JaehyeongIm/automotive-secure-ota-ecu/docs/assets/photos/천장사진.JPG

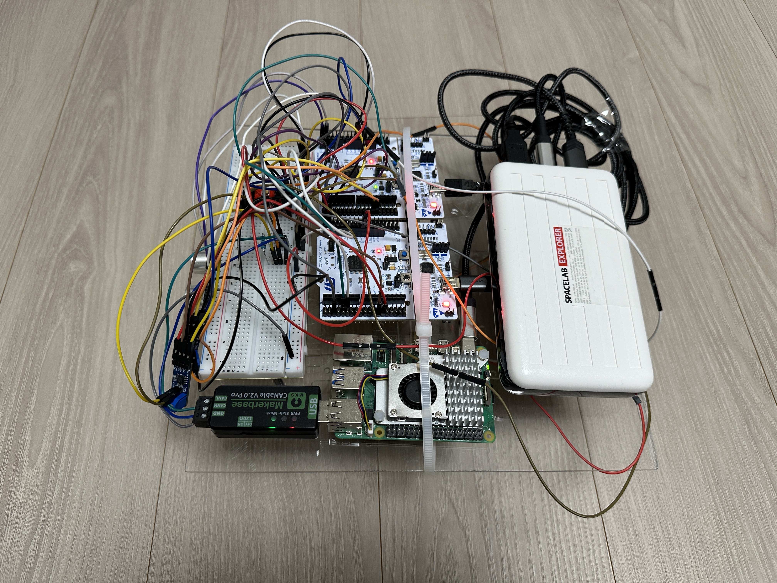
docs/assets/photos/천장사진.JPG
