JaehyeongIm/automotive-secure-ota-ecu/SRS-001_CAN_Secure_OTA_Pipeline_v4.md

# SRS-001: CAN 기반 UDS over ISO-TP Secure OTA 파이프라인 요구사항 명세서

| 항목 | 내용 |
|---|---|
| 문서 ID | SRS-001 |
| 문서명 | CAN 기반 UDS over ISO-TP Secure OTA 파이프라인 요구사항 명세서 |
| 프로젝트명 | Dual ECU 라인트레이싱 차량 Secure OTA 시스템 |
| 버전 | 1.4 |
| 작성일 | 2026-05-16 |
| 작성 목적 | Dual ECU 라인트레이싱 차량 Secure OTA 시스템 소프트웨어 요구사항 정의 |
| 주요 대상 | Raspberry Pi 5 Gateway, STM32F446RE ECU 2대, CAN Bus, Custom Bootloader, 라인트레이싱 차량 |
| 범위 변경 | 1.3 대비 ISO-TP 전송 계층 추가, SAD-001/SDD-001 필수 문서 추가(필수 문서 7종 확장), 산출물 요구사항 간소화, Drive ECU v1/v2 조작변인 구체화(ON/OFF → 비례 제어), Sensor ECU v1/v2 임계값 구체화(15cm → 25cm), HC-SR04 확정 |

---

## 1. 개요

### 1.1 프로젝트 목적

본 프로젝트의 목적은 Raspberry Pi 5를 차량 OTA Gateway 역할로, STM32F446RE 2대를 차량 ECU 역할로 구성하여 CAN 기반 Secure OTA 펌웨어 업데이트 파이프라인을 구현하는 것이다.

단순히 펌웨어 파일을 전송하는 데 그치지 않고, 다음 요소를 포함한 전장형 OTA 구조를 구현한다.

- STM32F446RE Custom Bootloader
- CAN 기반 UDS over ISO-TP 리프로그래밍 명령 구조
- 논리적 A/B App Slot 기반 안전 업데이트 및 Rollback
- Manifest 기반 펌웨어 무결성/인증성 검증
- SHA-256 Hash 검증
- 전자서명 기반 펌웨어 검증
- Anti-rollback 정책
- ECU ID / HW ID 기반 대상 검증
- 공격자 관점의 보안 시나리오 검증
- 라인트레이싱 차량을 통한 OTA 적용 결과 실증

본 시스템은 양산 차량 ECU 환경을 완전히 재현하지 않으며, 가용 개발 플랫폼(STM32F446RE, Raspberry Pi 5) 범위 내에서 전장 OTA의 핵심 기능을 구현하고 검증하는 것을 목표로 한다. 구현 범위의 한계는 Section 19에 명시한다.

본 프로젝트는 요구사항 기반 개발과 양방향 추적성 원칙을 적용하여 SRS, 설계, 구현, 테스트, 트러블슈팅 산출물 간의 일관성을 유지한다.

### 1.2 시스템 목표

본 시스템이 달성해야 하는 핵심 목표는 다음과 같다.

| 목표 영역 | 구현 내용 |
|---|---|
| Custom Bootloader | MCU 메모리맵 기반 Flash 파티션 관리, App jump, Vector Table 재배치 |
| CAN 통신 | 차량 네트워크 기반 ECU 간 업데이트 명령 및 상태 메시지 송수신 |
| UDS-style 명령 구조 | 진단 기반 리프로그래밍 절차(Session Control, Security Access, Download, Transfer) 구현 |
| A/B Slot 및 Rollback | 비활성 Slot 대상 업데이트, Self-test 기반 Confirmed 처리, 실패 시 자동 복구 |
| Secure OTA | SHA-256 무결성 검증, ECDSA 서명 검증, Anti-rollback, ECU ID 검증 |
| 위협 시나리오 검증 | 변조, 위조, 다운그레이드, Replay, 미인증 명령, CAN Flood 공격 방어 검증 |
| 시스템 실증 | 라인트레이싱 차량 플랫폼을 통한 OTA 적용 결과 기능 검증 |
| 요구사항 추적성 | SRS 요구사항에서 설계, 구현, 테스트, 트러블슈팅까지 양방향 추적 관리 |
| 계측 기반 검증 | 오실로스코프, 로직분석기, ST-LINK를 활용한 신호 수준 검증 및 원인 분석 |

---

## 2. 프로젝트 범위

### 2.1 In Scope

본 프로젝트에서 구현 대상에 포함되는 범위는 다음과 같다.

1. Raspberry Pi 5 기반 OTA Gateway 구현
2. STM32F446RE 기반 Drive ECU 구현
3. STM32F446RE 기반 Sensor/Body ECU 구현
4. 각 ECU의 Custom Secure Bootloader 구현
5. ISO-TP (SF/FF/CF/FC) 기반 UDS 전송 계층 구현
6. CAN 기반 UDS 업데이트 명령 구조 구현 (0x10, 0x27, 0x34, 0x36, 0x37, 0x31, 0x11)
7. 논리적 A/B App Slot 기반 업데이트 및 Rollback 구현
8. Manifest 기반 업데이트 패키지 검증
9. SHA-256 기반 이미지 무결성 검증
10. 전자서명 기반 펌웨어 인증성 검증
11. Anti-rollback 정책 구현
12. ECU ID / HW ID 기반 대상 검증
13. 라인트레이싱 App v1/v2 업데이트 실증
14. 공격자 시나리오 기반 보안 테스트
15. 정상/비정상 업데이트 로그 수집 및 테스트 리포트 작성
16. ASPICE-inspired 요구사항 기반 개발 프로세스 적용
17. 요구사항-설계-구현-테스트 간 추적성 매트릭스 작성
18. 계측기 기반 트러블슈팅 사례 수집 및 리포트 작성
19. ST-LINK 디버거 기반 Bootloader/App 실행 흐름 검증

### 2.2 Out of Scope

다음 항목은 본 프로젝트의 1차 구현 범위에서 제외한다.

| 제외 항목 | 제외 사유 |
|---|---|
| Delta Update / 차분 업데이트 | 1차 구현에서는 안정성 검증을 우선하며, Full Image 기반 A/B OTA에 집중하기 위함 |
| 상용 Uptane 전체 구현 | 개인 프로젝트 범위에서 과도하므로 Uptane-lite 개념 참고 수준으로 제한 |
| AUTOSAR Classic/Adaptive 정식 스택 | 상용 스택 없이 개념 연결 수준으로 제한 |
| ISO-TP 멀티 세션 동시 처리 | 단일 ECU당 단일 OTA 세션만 운용하므로 동시 세션 관리는 제외 |
| HSM 기반 키 저장 | F446RE의 하드웨어 한계로 양산 ECU 수준 구현 불가 |
| 실제 차량 ECU 연결 공격 | 안전/법적 문제로 자체 제작 테스트 네트워크 내부에서만 검증 |
| 실제 차량 주행 제어 | 축소형 라인트레이싱 차량 플랫폼에서만 실증 |
| ASPICE 완전 준수/공식 평가 | 개인 프로젝트 범위이므로 공식 ASPICE 심사나 조직 프로세스 수준의 준수는 제외 |
| 상용 요구사항 관리 도구 필수 사용 | Polarion, DOORS 등 상용 도구 대신 Markdown/Spreadsheet 기반 추적성 관리로 대체 |

---

## 3. 시스템 개요

### 3.1 전체 시스템 구성

```text
[Update Package / 개발 PC]
        |
        | 파일 복사 또는 내부 네트워크
        v
[Raspberry Pi 5: OTA Gateway]
- Update Package 관리
- Manifest 파싱 및 1차 검증
- CAN 전송 제어
- ECU Inventory 수집
- Update Campaign 상태 관리
- 공격자 시나리오 실행
        |
        | CAN Bus
        v
+----------------------------+      +------------------------------+
| STM32F446RE ECU #1         |      | STM32F446RE ECU #2           |
| Drive ECU                  |      | Sensor/Body ECU              |
| - Custom Bootloader        |      | - Custom Bootloader          |
| - A/B App Slot             |      | - A/B App Slot               |
| - Line Tracing Control     |      | - Distance/Obstacle Sensing  |
| - Motor Control            |      | - Status Message Tx          |
+----------------------------+      +------------------------------+
```

### 3.2 주요 하드웨어 역할

| 구성 요소 | 역할 |
|---|---|
| Raspberry Pi 5 | OTA Gateway, Update Manager, CAN 송수신, 로그 수집, 공격자 시나리오 실행 |
| STM32F446RE #1 | Drive ECU: 라인트레이싱, 모터 제어, OTA 대상 ECU |
| STM32F446RE #2 | Sensor/Body ECU: 거리센서, 장애물 감지, 상태 메시지 송신, OTA 대상 ECU |
| CAN Transceiver | STM32와 CAN Bus 간 물리 계층 연결 |
| CANable 또는 유사 장치 | PC/Raspberry Pi에서 CAN 로그 확인 및 테스트 프레임 송신 |
| 2WD 차체 | OTA 적용 결과를 실증할 차량 플랫폼 |
| TB6612FNG | DC 모터 구동 드라이버 |
| 라인트레이서 센서 | Drive ECU의 라인 감지 입력 |
| 거리센서 | Sensor/Body ECU의 장애물 감지 입력 |

---

## 4. 사용자 및 이해관계자

| 이해관계자 | 관심사 |
|---|---|
| 임베디드 소프트웨어 개발자 | Bootloader, CAN 드라이버, OTA 절차, 보안 검증 구현 |
| 시스템 통합 담당자 | ECU 간 인터페이스, CAN 메시지 명세, 업데이트 절차 일관성 |
| 품질 보증(QA) 담당자 | 요구사항 추적성, 테스트 커버리지, 실패 복구 검증 결과 |
| 차량 운전자 | 업데이트 실패 시 기존 주행 기능 유지, 업데이트 중 안전 정지 |

---

## 5. 운영 시나리오

### 5.1 정상 업데이트 시나리오

1. Raspberry Pi 5가 ECU Inventory를 요청한다.
2. 각 ECU는 현재 펌웨어 버전, 활성 슬롯, Boot 상태, ECU ID를 응답한다.
3. Raspberry Pi 5가 업데이트 Manifest를 확인한다.
4. Raspberry Pi 5가 대상 ECU에 UDS-style Diagnostic Session 진입을 요청한다.
5. ECU는 업데이트 가능한 조건인지 확인한다.
6. Raspberry Pi 5가 Security Access 절차를 수행한다.
7. Raspberry Pi 5가 Request Download를 전송한다.
8. ECU는 비활성 Slot을 선택하고 다운로드 준비 상태로 진입한다.
9. Raspberry Pi 5가 Transfer Data로 펌웨어 조각을 전송한다.
10. ECU는 조각 순서, 길이, 범위를 확인하고 비활성 Slot에 기록한다.
11. Request Transfer Exit 이후 ECU는 이미지 Hash, Signature, Version, ECU ID를 검증한다.
12. 검증 성공 시 ECU는 Boot Metadata를 갱신하여 다음 부팅 대상 Slot을 변경한다.
13. ECU Reset 이후 새 App으로 부팅한다.
14. App은 Self-test를 수행하고 정상일 경우 Confirmed 상태를 Bootloader에 알린다.
15. Confirmed 처리 완료 후 새 Slot이 정상 슬롯이 된다.

### 5.2 실패 복구 시나리오

1. 업데이트 중 전원 차단 또는 통신 중단이 발생한다.
2. 재부팅 시 Bootloader가 Metadata를 확인한다.
3. 새 Slot이 검증 완료/Confirmed 상태가 아니면 기존 Confirmed Slot으로 부팅한다.
4. 기존 App이 정상 동작해야 한다.
5. Raspberry Pi 5는 실패 원인을 로그로 기록한다.

### 5.3 공격자 검증 시나리오

1. 공격자 노드가 위조된 Update Start 명령을 전송한다.
2. ECU는 인증되지 않은 세션을 거부한다.
3. 공격자 노드가 변조된 Firmware Chunk를 전송한다.
4. ECU는 최종 Hash 또는 Signature 검증에서 실패 처리한다.
5. 공격자 노드가 이전 버전 펌웨어를 전송한다.
6. ECU는 Anti-rollback 정책에 의해 거부한다.
7. 공격자 노드가 Replay 프레임을 전송한다.
8. ECU는 Session ID, Sequence Number, Freshness Counter를 통해 거부한다.

---

## 6. 시스템 제약사항

### 6.1 MCU 제약

- STM32F446RE는 양산 차량용 HSM MCU가 아니다.
- F446RE의 Flash는 하드웨어 Dual Bank 구조가 아니므로, 단일 Flash 내부를 논리적으로 분할하여 A/B Slot을 구성한다.
- F446RE의 Flash 용량은 제한적이므로 App 크기, Bootloader 크기, 암호 라이브러리 크기를 관리해야 한다.
- 실제 양산 ECU 수준의 Secure Boot ROM, HSM Key Storage, Debug Lock 정책은 본 프로젝트에서 완전 재현하지 않는다.

### 6.2 CAN / ISO-TP 제약

- CAN Classic (최대 8바이트 payload) 기반으로 구현한다.
- CAN FD 수준의 대용량 Payload를 전제하지 않는다.
- 대용량 데이터(펌웨어 이미지) 전송은 ISO-TP FF/CF 분할 전송으로 처리한다.
- ISO-TP는 SF/FF/CF/FC 핵심 프레임 타입을 구현하며, 멀티 세션 동시 처리는 제외한다.
- Gateway(Raspberry Pi 5)는 Linux SocketCAN의 ISO-TP 커널 지원을 활용한다.
- ECU(STM32F446RE)는 ISO-TP 수신 상태 머신을 소프트웨어로 구현한다.
- CAN 버스 속도는 500Kbps로 운용한다.
- CAN Bus 부하, 전송 시간, STmin 타이밍, Timeout 정책을 고려한다.

### 6.3 프로젝트 범위 제약

- 본 프로젝트는 개인 사이드 프로젝트이며, 상용 OTA 시스템을 완전 대체하지 않는다.
- Uptane, AUTOSAR, UDS는 전체 표준 구현이 아니라 개념을 참고한 축소 구현으로 제한한다.
- ISO-TP는 OTA에 필요한 SF/FF/CF/FC 핵심 기능을 구현하며, ISO 15765-2 전체 규격 준수를 목표로 하지 않는다.
- 보안 공격 시나리오는 자체 제작한 테스트 환경 내부에서만 수행한다.

---

## 7. 기능 요구사항

### 7.1 OTA Gateway 요구사항

| ID | 요구사항 | 우선순위 | 수용 기준 |
|---|---|---:|---|
| FR-GW-001 | Raspberry Pi 5는 OTA Gateway 역할을 수행해야 한다. | Must | Gateway 프로세스가 ECU 목록, 버전, 상태를 수집할 수 있어야 한다. |
| FR-GW-002 | Gateway는 Update Package와 Manifest를 읽고 파싱해야 한다. | Must | Manifest 필드를 정상적으로 파싱하고 누락 필드를 오류 처리한다. |
| FR-GW-003 | Gateway는 Manifest에 포함된 ECU ID, Version, Image Size, Hash, Signature 정보를 관리해야 한다. | Must | Manifest 내용이 로그에 기록되어야 한다. |
| FR-GW-004 | Gateway는 대상 ECU별 업데이트 순서를 제어해야 한다. | Must | Drive ECU, Sensor ECU를 개별적으로 업데이트할 수 있어야 한다. |
| FR-GW-005 | Gateway는 CAN을 통해 UDS-style 명령을 송수신해야 한다. | Must | Session Control, Request Download, Transfer Data 등 핵심 명령이 동작해야 한다. |
| FR-GW-006 | Gateway는 업데이트 성공/실패 결과를 로그로 저장해야 한다. | Must | 각 ECU별 업데이트 결과, 실패 원인, 시간 정보가 기록되어야 한다. |
| FR-GW-007 | Gateway는 공격자 시나리오 실행 모드를 제공해야 한다. | Should | Replay, 변조, 비인가 명령, Flood 테스트를 선택 실행할 수 있어야 한다. |
| FR-GW-008 | Gateway는 Update Campaign ID를 관리해야 한다. | Should | 동일 Campaign에 속한 ECU 업데이트 결과를 묶어서 기록해야 한다. |

### 7.2 ECU Bootloader 요구사항

| ID | 요구사항 | 우선순위 | 수용 기준 |
|---|---|---:|---|
| FR-BL-001 | 각 STM32F446RE ECU는 Custom Bootloader를 포함해야 한다. | Must | Reset 후 Bootloader가 먼저 실행되어야 한다. |
| FR-BL-002 | Bootloader는 현재 활성 Slot과 후보 Slot을 구분해야 한다. | Must | Metadata에서 active, pending, confirmed 상태를 읽을 수 있어야 한다. |
| FR-BL-003 | Bootloader는 유효한 App이 있을 경우 해당 App으로 jump해야 한다. | Must | Vector Table 설정 후 App Reset Handler로 정상 진입해야 한다. |
| FR-BL-004 | Bootloader는 CAN 기반 업데이트 세션에 진입할 수 있어야 한다. | Must | 특정 조건 또는 명령 수신 시 update mode에 진입해야 한다. |
| FR-BL-005 | Bootloader는 수신한 펌웨어 조각을 비활성 Slot에 기록해야 한다. | Must | Flash erase/write가 섹터 경계와 주소 범위 내에서 수행되어야 한다. |
| FR-BL-006 | Bootloader는 펌웨어 전체 Hash를 검증해야 한다. | Must | Manifest의 Hash와 실제 Slot 이미지 Hash가 일치해야 한다. |
| FR-BL-007 | Bootloader는 펌웨어 Signature를 검증해야 한다. | Must | 공개키 기반 검증 실패 시 업데이트를 거부해야 한다. |
| FR-BL-008 | Bootloader는 Firmware Version을 확인하고 다운그레이드를 차단해야 한다. | Must | 현재 Confirmed Version보다 낮은 버전은 거부해야 한다. |
| FR-BL-009 | Bootloader는 Target ECU ID/HW ID를 확인해야 한다. | Must | 다른 ECU용 이미지 설치를 거부해야 한다. |
| FR-BL-010 | Bootloader는 업데이트 후 첫 부팅에서 Self-test 결과를 확인해야 한다. | Must | Self-test 실패 시 이전 Confirmed Slot으로 rollback해야 한다. |
| FR-BL-011 | Bootloader는 Boot Metadata 손상 시 안전한 기본 정책을 적용해야 한다. | Should | Metadata 오류 시 기존 Confirmed Slot 또는 Safe Mode로 진입해야 한다. |
| FR-BL-012 | Bootloader는 Watchdog 또는 Timeout 기반 업데이트 중단 처리를 지원해야 한다. | Should | 일정 시간 Transfer Data가 없으면 업데이트를 중단하고 기존 App을 유지해야 한다. |

### 7.3 A/B Slot 및 Rollback 요구사항

| ID | 요구사항 | 우선순위 | 수용 기준 |
|---|---|---:|---|
| FR-AB-001 | 시스템은 논리적 A/B App Slot을 사용해야 한다. | Must | Slot A와 Slot B 중 하나만 active 상태여야 한다. |
| FR-AB-002 | 업데이트 이미지는 현재 실행 중인 Slot이 아닌 비활성 Slot에 기록해야 한다. | Must | 현재 Confirmed Slot은 업데이트 과정에서 지워지지 않아야 한다. |
| FR-AB-003 | 새 Slot 검증이 완료되기 전까지 Boot Target을 변경하지 않아야 한다. | Must | Hash/Signature/Version 검증 실패 시 기존 Slot 유지가 확인되어야 한다. |
| FR-AB-004 | 새 App은 부팅 후 Self-test를 통과해야 Confirmed 처리되어야 한다. | Must | Self-test 실패 App은 다음 부팅에서 rollback되어야 한다. |
| FR-AB-005 | 업데이트 중 전원 차단이 발생해도 기존 Confirmed App은 유지되어야 한다. | Must | 전원 차단 테스트 후 기존 App으로 정상 부팅해야 한다. |
| FR-AB-006 | Boot Metadata는 active, pending, confirmed, version, attempt count를 관리해야 한다. | Should | Metadata dump 또는 로그에서 상태 확인이 가능해야 한다. |
| FR-AB-007 | Boot attempt count를 초과하면 이전 Slot으로 복구해야 한다. | Should | 지정 횟수 내 Confirmed 되지 않은 App은 실패 처리되어야 한다. |

### 7.4 CAN / ISO-TP / UDS 프로토콜 요구사항

| ID | 요구사항 | 우선순위 | 수용 기준 |
|---|---|---:|---|
| FR-CAN-001 | 시스템은 CAN 기반 ECU 업데이트 통신을 수행해야 한다. | Must | Gateway와 각 ECU 간 CAN 송수신이 가능해야 한다. |
| FR-CAN-002 | 모든 UDS 메시지는 ISO-TP 전송 계층을 통해 송수신되어야 한다. | Must | ISO-TP 없이 직접 CAN 프레임으로 UDS 명령을 송수신하지 않아야 한다. |
| FR-CAN-003 | ECU는 ISO-TP SF(Single Frame)를 수신하여 UDS 명령을 처리해야 한다. | Must | 7바이트 이하 UDS 명령이 SF로 수신되어 정상 처리되어야 한다. |
| FR-CAN-004 | ECU는 ISO-TP FF/CF(First Frame / Consecutive Frame)를 수신하여 UDS 페이로드를 조립해야 한다. | Must | 다중 프레임으로 분할된 Transfer Data 페이로드가 누락 없이 조립되어야 한다. |
| FR-CAN-005 | ECU는 FF 수신 후 ISO-TP FC(Flow Control) 프레임을 송신해야 한다. | Must | FC 프레임의 FlowStatus, BlockSize, STmin 필드가 정확히 설정되어야 한다. |
| FR-CAN-006 | ECU는 ISO-TP STmin 타이밍을 준수해야 한다. | Must | CF 프레임 간 수신 간격이 STmin 이하일 경우 오류 처리해야 한다. |
| FR-CAN-007 | Gateway는 SocketCAN ISO-TP 인터페이스를 통해 UDS 메시지를 송수신해야 한다. | Must | Python socket(AF_CAN, SOCK_DGRAM, CAN_ISOTP) 기반으로 전송되어야 한다. |
| FR-CAN-008 | 명령 구조는 UDS 리프로그래밍 절차를 준수해야 한다. | Must | 0x10, 0x27, 0x34, 0x36, 0x37, 0x31, 0x11에 대응하는 명령이 정의되어야 한다. |
| FR-CAN-009 | Diagnostic Session Control 명령을 지원해야 한다. | Must | Default Session과 Programming Session 상태를 구분해야 한다. |
| FR-CAN-010 | Security Access 명령을 지원해야 한다. | Must | 인증되지 않은 상태에서는 다운로드 명령을 거부해야 한다. |
| FR-CAN-011 | Request Download 명령을 지원해야 한다. | Must | Image size, target slot, target ECU ID를 확인해야 한다. |
| FR-CAN-012 | Transfer Data 명령을 지원해야 한다. | Must | Sequence Number와 Chunk 길이를 확인해야 한다. |
| FR-CAN-013 | Request Transfer Exit 명령을 지원해야 한다. | Must | 모든 Chunk 수신 후 검증 단계로 진입해야 한다. |
| FR-CAN-014 | Routine Control - Verify Image 명령을 지원해야 한다. | Must | Hash/Signature/Version/ECU ID 검증 결과를 반환해야 한다. |
| FR-CAN-015 | ECU Reset 명령을 지원해야 한다. | Must | 검증 성공 후 Reset을 통해 새 Slot 부팅을 시도해야 한다. |
| FR-CAN-016 | Negative Response Code를 정의해야 한다. | Should | 잘못된 세션, 보안 실패, 길이 오류, 순서 오류, 인증 실패 등을 구분해야 한다. |
| FR-CAN-017 | Replay 방어를 위한 Session ID 또는 Freshness Counter를 사용해야 한다. | Should | 이전 세션의 Transfer Data 재전송이 거부되어야 한다. |

### 7.5 Drive ECU Application 요구사항

| ID | 요구사항 | 우선순위 | 수용 기준 |
|---|---|---:|---|
| FR-DRV-001 | Drive ECU는 라인트레이싱 센서 입력을 읽어야 한다. | Must | 4채널 IR 센서 입력값을 주기적으로 읽고 로그/상태로 확인할 수 있어야 한다. |
| FR-DRV-002 | Drive ECU는 TB6612FNG를 통해 좌우 모터를 제어해야 한다. | Must | PWM 기반 좌우 모터 속도 제어가 가능해야 한다. |
| FR-DRV-003 | Drive ECU App v1은 ON/OFF 방식(bang-bang) 라인트레이싱 제어를 구현해야 한다. | Must | 4채널 IR 센서 입력을 ON/OFF로 해석하여 좌우 모터를 전속 또는 정지 상태로 전환하며, 직선에서는 주행하되 곡선 구간에서 진동/사행 주행이 관찰되어야 한다. |
| FR-DRV-004 | Drive ECU App v2는 가중치 기반 비례 제어 라인트레이싱을 구현해야 한다. | Should | 4채널 IR 센서에 가중치(외측 ±3, 내측 ±1)를 적용하여 편차를 계산하고, 좌우 모터 PWM을 차등 조정하여 v1 대비 곡선 구간 추종이 부드럽게 개선되어야 한다. |
| FR-DRV-005 | Drive ECU는 Sensor ECU의 장애물 상태 메시지를 반영해야 한다. | Should | 장애물 감지 시 정지 또는 감속해야 한다. |
| FR-DRV-006 | Drive ECU는 현재 App Version과 Slot 정보를 CAN으로 보고해야 한다. | Must | Gateway의 Inventory 요청에 응답해야 한다. |

### 7.6 Sensor/Body ECU Application 요구사항

| ID | 요구사항 | 우선순위 | 수용 기준 |
|---|---|---:|---|
| FR-SEN-001 | Sensor ECU는 HC-SR04 초음파 거리센서 입력을 읽어야 한다. | Must | Trigger/Echo GPIO 방식으로 거리값을 주기적으로 측정할 수 있어야 한다. |
| FR-SEN-002 | Sensor ECU App v1은 장애물 감지 임계값 15cm를 사용해야 한다. | Must | 측정 거리가 15cm 이하일 때 obstacle_detected 상태를 CAN으로 송신해야 한다. |
| FR-SEN-003 | Sensor ECU는 Alive/Heartbeat 메시지를 송신해야 한다. | Should | Drive ECU 또는 Gateway가 Sensor ECU 생존 상태를 확인할 수 있어야 한다. |
| FR-SEN-004 | Sensor ECU App v2는 장애물 감지 임계값을 25cm로 변경해야 한다. | Should | OTA 업데이트 후 측정 거리가 25cm 이하일 때 obstacle_detected 상태를 송신하여 v1(15cm) 대비 조기 감지가 확인되어야 한다. |
| FR-SEN-005 | Sensor ECU는 현재 App Version과 Slot 정보를 CAN으로 보고해야 한다. | Must | Gateway의 Inventory 요청에 응답해야 한다. |

---

## 8. 보안 요구사항

### 8.1 Manifest 요구사항

| ID | 요구사항 | 우선순위 | 수용 기준 |
|---|---|---:|---|
| SR-MF-001 | 업데이트 패키지는 Manifest를 포함해야 한다. | Must | Manifest 없이는 업데이트가 시작되지 않아야 한다. |
| SR-MF-002 | Manifest는 target_ecu_id를 포함해야 한다. | Must | ECU ID 불일치 시 업데이트가 거부되어야 한다. |
| SR-MF-003 | Manifest는 firmware_version을 포함해야 한다. | Must | Version 기반 anti-rollback 검증이 가능해야 한다. |
| SR-MF-004 | Manifest는 image_size를 포함해야 한다. | Must | 수신 데이터가 image_size를 초과하면 중단해야 한다. |
| SR-MF-005 | Manifest는 image_hash를 포함해야 한다. | Must | 최종 Slot 이미지 Hash와 비교해야 한다. |
| SR-MF-006 | Manifest는 signature를 포함해야 한다. | Must | 공개키 기반 서명 검증을 수행해야 한다. |
| SR-MF-007 | Manifest는 campaign_id를 포함해야 한다. | Should | 복수 ECU 업데이트 결과를 하나의 캠페인으로 추적해야 한다. |
| SR-MF-008 | Manifest는 expiration 또는 metadata_version을 포함해야 한다. | Should | 오래된 Manifest 재사용을 방지해야 한다. |

### 8.2 Firmware 검증 요구사항

| ID | 요구사항 | 우선순위 | 수용 기준 |
|---|---|---:|---|
| SR-FW-001 | ECU는 수신한 펌웨어 전체에 대해 Hash를 계산해야 한다. | Must | 계산 Hash와 Manifest Hash가 다르면 업데이트 실패 처리해야 한다. |
| SR-FW-002 | ECU는 펌웨어 또는 Manifest Signature를 검증해야 한다. | Must | 검증 실패 시 Boot Target을 변경하지 않아야 한다. |
| SR-FW-003 | ECU는 현재 Confirmed Version보다 낮은 Version을 거부해야 한다. | Must | Downgrade 테스트가 실패 처리되어야 한다. |
| SR-FW-004 | ECU는 대상 ECU ID가 일치하지 않는 이미지를 거부해야 한다. | Must | Drive ECU용 이미지를 Sensor ECU에 설치할 수 없어야 한다. |
| SR-FW-005 | ECU는 이미지 크기가 Slot 크기를 초과하면 업데이트를 거부해야 한다. | Must | Slot boundary 침범이 발생하지 않아야 한다. |
| SR-FW-006 | ECU는 Flash write 주소 범위를 검증해야 한다. | Must | Bootloader, Metadata 영역에 App 데이터가 기록되지 않아야 한다. |

### 8.3 공격 방어 요구사항

| ID | 공격 시나리오 | 방어 요구사항 | 수용 기준 |
|---|---|---|---|
| SR-ATK-001 | Firmware Tampering | Hash/Signature 검증 | 1바이트 변조 이미지가 거부되어야 한다. |
| SR-ATK-002 | Arbitrary Software | Signature 검증 | 개인이 임의 생성한 unsigned image가 거부되어야 한다. |
| SR-ATK-003 | Downgrade Attack | Anti-rollback | 낮은 version image가 거부되어야 한다. |
| SR-ATK-004 | ECU Mismatch | target_ecu_id 검증 | 다른 ECU용 image가 거부되어야 한다. |
| SR-ATK-005 | Replay Attack | session_id, sequence number, freshness counter | 이전 Transfer Data 재전송이 거부되어야 한다. |
| SR-ATK-006 | Unauthorized Update Start | Security Access | 인증되지 않은 update command가 거부되어야 한다. |
| SR-ATK-007 | Endless Data Attack | image_size, chunk_count 제한 | Manifest size 초과 수신 시 세션이 종료되어야 한다. |
| SR-ATK-008 | CAN Flood / DoS | timeout, abort, rollback | 업데이트 중단 후 기존 App으로 복구되어야 한다. |
| SR-ATK-009 | Fake Complete | ECU 내부 검증 결과 기반 commit | Gateway의 fake complete 명령만으로 Confirmed 되지 않아야 한다. |
| SR-ATK-010 | Partial Bundle Installation | campaign result 추적 | 한 ECU만 업데이트 성공 시 Campaign 상태가 partial/fail로 기록되어야 한다. |

---

## 9. Uptane-lite 참고 요구사항

### 9.1 적용 범위

본 프로젝트는 Uptane 전체 표준을 구현하지 않는다. 대신 자동차 OTA 보안에서 중요한 메타데이터 기반 검증 개념을 참고하여 Uptane-lite 구조로 축소 적용한다.

### 9.2 개념 매핑

| Uptane 개념 | 본 프로젝트 대응 |
|---|---|
| Primary ECU | Raspberry Pi 5 OTA Gateway |
| Secondary ECU | STM32F446RE Drive ECU, Sensor ECU |
| Image Repository | 개발 PC 또는 Raspberry Pi 5의 펌웨어 저장소 |
| Director Repository | Raspberry Pi 5의 ECU별 업데이트 지시 로직 |
| Targets Metadata | manifest.json |
| ECU Inventory | ECU ID, version, active slot, boot state 보고 |
| Version Report | 각 ECU의 현재 펌웨어 버전 보고 |
| Rollback 방어 | firmware_version, metadata_version, campaign_id 검증 |
| Partial Bundle 방어 | ECU별 업데이트 결과 수집 및 Campaign 상태 관리 |

### 9.3 Uptane-lite 요구사항

| ID | 요구사항 | 우선순위 | 수용 기준 |
|---|---|---:|---|
| SR-UP-001 | Gateway는 ECU Inventory를 수집해야 한다. | Must | 각 ECU의 version, slot, state가 기록되어야 한다. |
| SR-UP-002 | Manifest는 ECU별 대상 이미지를 명확히 구분해야 한다. | Must | Drive ECU와 Sensor ECU 이미지가 구분되어야 한다. |
| SR-UP-003 | Gateway는 Campaign 단위 업데이트 결과를 관리해야 한다. | Should | 전체 성공, 일부 성공, 전체 실패 상태가 구분되어야 한다. |
| SR-UP-004 | ECU는 Gateway 검증 결과만 신뢰하지 않고 자체 검증을 수행해야 한다. | Must | Gateway가 변조되었다는 가정에서도 unsigned image가 설치되지 않아야 한다. |
| SR-UP-005 | Manifest 재사용 공격을 방어해야 한다. | Should | metadata_version 또는 expiration 기반으로 오래된 Manifest를 거부해야 한다. |

---

## 10. 비기능 요구사항

### 10.1 신뢰성 요구사항

| ID | 요구사항 | 우선순위 | 수용 기준 |
|---|---|---:|---|
| NFR-REL-001 | 업데이트 실패 시 기존 정상 App이 유지되어야 한다. | Must | 실패 테스트 후 기존 라인트레이싱 기능이 동작해야 한다. |
| NFR-REL-002 | 전원 차단 후에도 Bootloader가 일관된 상태로 복구해야 한다. | Must | 재부팅 후 Metadata 기반으로 안전 Slot을 선택해야 한다. |
| NFR-REL-003 | CAN 통신 중단 시 업데이트 세션이 무한 대기하지 않아야 한다. | Must | Timeout 후 abort 상태로 전환되어야 한다. |
| NFR-REL-004 | App Self-test 실패 시 rollback해야 한다. | Must | 실패 App이 Confirmed 처리되지 않아야 한다. |

### 10.2 성능 요구사항

| ID | 요구사항 | 우선순위 | 수용 기준 |
|---|---|---:|---|
| NFR-PERF-001 | CAN 전송은 Chunk 단위로 안정적으로 수행되어야 한다. | Must | 전체 이미지 전송 중 sequence 오류 없이 완료되어야 한다. |
| NFR-PERF-002 | 업데이트 시간은 측정되어야 한다. | Should | 이미지 크기, chunk 수, 전송 시간, 평균 throughput이 로그에 남아야 한다. |
| NFR-PERF-003 | 라인트레이싱 제어 루프는 정상 주행에 충분한 주기로 실행되어야 한다. | Should | 센서 읽기와 PWM 제어가 눈에 띄는 지연 없이 수행되어야 한다. |

### 10.3 유지보수성 요구사항

| ID | 요구사항 | 우선순위 | 수용 기준 |
|---|---|---:|---|
| NFR-MNT-001 | CAN / ISO-TP / UDS 메시지 명세는 문서로 관리해야 한다. | Must | SDD-001 또는 CAN-001에 CAN ID, ISO-TP 프레임 구조, UDS SID/NRC 명세가 포함되어야 한다. |
| NFR-MNT-002 | Bootloader 상태 전이는 다이어그램으로 문서화해야 한다. | Must | SDD-001에 Bootloader 상태 전이 다이어그램이 포함되어야 한다. |
| NFR-MNT-003 | 테스트 케이스와 결과는 추적 가능해야 한다. | Must | 요구사항 ID와 테스트 ID가 매핑되어야 한다. |
| NFR-MNT-004 | App v1/v2 변경점은 릴리즈 노트로 관리해야 한다. | Should | version별 기능 차이가 문서화되어야 한다. |

### 10.4 안전성 요구사항

| ID | 요구사항 | 우선순위 | 수용 기준 |
|---|---|---:|---|
| NFR-SAFE-001 | 라인트레이싱 차량은 업데이트 중 주행하지 않아야 한다. | Must | 업데이트 세션 진입 시 모터 출력이 차단되어야 한다. |
| NFR-SAFE-002 | 장애물 감지 시 Drive ECU는 정지 또는 감속해야 한다. | Should | 지정 거리 이하에서 모터 출력이 제한되어야 한다. |
| NFR-SAFE-003 | Bootloader 상태에서는 모터가 구동되지 않아야 한다. | Must | Bootloader 실행 중 PWM 출력이 비활성화되어야 한다. |

---

## 11. 개발 프로세스 및 요구사항 추적성 요구사항

### 11.1 적용 원칙

본 프로젝트는 Automotive SPICE의 요구사항 기반 개발, 산출물 간 일관성, 양방향 추적성, 변경 영향 추적 원칙을 적용한다. 공식 ASPICE 조직 프로세스 인증 및 외부 평가는 본 프로젝트 범위에 포함하지 않는다.

### 11.2 프로세스 요구사항

| 요구사항 ID | 요구사항 내용 | 우선순위 | 검증 방법 |
|---|---|---:|---|
| PRC-001 | 프로젝트 요구사항은 SRS-001에 고유 ID를 부여하여 관리해야 한다. | High | 문서 리뷰 |
| PRC-002 | 주요 기능 요구사항은 설계 문서 또는 설계 항목으로 추적 가능해야 한다. | High | RTM 확인 |
| PRC-003 | 주요 보안 요구사항은 공격 시나리오 및 테스트 케이스와 연결되어야 한다. | High | SEC-001, TP-001 확인 |
| PRC-004 | 주요 테스트 케이스는 관련 요구사항 ID를 포함해야 한다. | High | TP-001, TR-001 확인 |
| PRC-005 | 구현 중 요구사항이 변경되면 개정 이력 또는 변경 로그에 기록해야 한다. | Medium | 변경 로그 확인 |
| PRC-006 | 실패/결함 사례는 원인, 분석 도구, 조치, 재검증 결과를 포함하여 기록해야 한다. | High | TSR-001 확인 |
| PRC-007 | Release Note는 App v1/v2 차이, 업데이트 대상 ECU, 버전, 검증 결과를 포함해야 한다. | Medium | RN-001 확인 |

### 11.3 추적성 관리 요구사항

| 요구사항 ID | 요구사항 내용 | 우선순위 | 검증 방법 |
|---|---|---:|---|
| RTM-001 | 각 요구사항은 Requirement ID, 설계 항목, 구현 파일/함수, 테스트 케이스, 결과를 연결해야 한다. | High | RTM-001 리뷰 |
| RTM-002 | 보안 요구사항은 최소 1개 이상의 공격 또는 실패 테스트와 연결되어야 한다. | High | RTM-001 리뷰 |
| RTM-003 | Bootloader 관련 요구사항은 App jump, Flash write, Slot selection, Rollback 테스트와 연결되어야 한다. | High | RTM-001 리뷰 |
| RTM-004 | CAN/UDS-style 요구사항은 정상 응답과 Negative Response 테스트를 모두 포함해야 한다. | Medium | TP-001 확인 |
| RTM-005 | 요구사항 변경 시 영향받는 설계/테스트 항목을 식별해야 한다. | Medium | 변경 로그 확인 |

### 11.4 추적성 예시

| Requirement ID | Design 항목 | Implementation 예시 | Test Case | 결과 |
|---|---|---|---|---|
| SR-FW-002 | Signature Verification | boot_verify_signature() | TC-SEC-002 | PASS/FAIL 기록 |
| FR-AB-004 | Rollback State Machine | boot_select_slot() | TC-FAIL-004 | PASS/FAIL 기록 |
| FR-CAN-012 | TransferData Sequence Check | uds_transfer_data_handler() | TC-FAIL-002 | PASS/FAIL 기록 |
| SR-ATK-005 | Replay Defense | session_counter_check() | TC-SEC-005 | PASS/FAIL 기록 |
| PRC-006 | Troubleshooting Record | TSR-001 | TC-DBG-001~ | PASS/FAIL 기록 |

---

## 12. 계측 및 디버깅 요구사항

### 12.1 적용 원칙

계측기 사용 자체를 시스템 기능 요구사항으로 분류하지 않는다. 그러나 전장 임베디드 개발에서 문제를 관찰하고 원인을 측정 근거로 분석하는 과정은 검증의 핵심이다. 따라서 본 프로젝트는 계측 및 디버깅 도구 사용을 검증/트러블슈팅 산출물 요구사항으로 관리한다.

### 12.2 사용 도구 및 목적

| 도구 | 사용 목적 | 주요 확인 항목 |
|---|---|---|
| 오실로스코프 | 전기적 신호 및 전원 품질 확인 | CANH/CANL 파형, 전원 리플, 모터 구동 시 전압 강하 |
| 로직분석기 | 디지털 신호 및 타이밍 확인 | GPIO, PWM, UART, 센서 입력 타이밍 |
| 멀티미터 | 정적 전압/저항/연결 상태 확인 | 전원 레일, GND 연결, 종단저항, 단락 여부 |
| ST-LINK 디버거 | MCU 내부 실행 흐름 분석 | Breakpoint, register, stack pointer, VTOR, Flash error flag |
| CANable 또는 SocketCAN | CAN 프레임 송수신/로그 | UDS-style 요청/응답, 공격 프레임, timeout, NRC |

### 12.3 디버깅/트러블슈팅 요구사항

| 요구사항 ID | 요구사항 내용 | 우선순위 | 검증 방법 |
|---|---|---:|---|
| DBG-001 | CAN 통신 이상 발생 시 CANH/CANL 파형 또는 CAN 로그를 통해 원인을 분석해야 한다. | Medium | TSR-001 |
| DBG-002 | 업데이트 중 MCU 리셋 또는 오동작 발생 시 전원 레일과 모터 구동 영향을 확인해야 한다. | Medium | TSR-001 |
| DBG-003 | Bootloader에서 App jump 실패 시 MSP, Reset Handler 주소, VTOR 설정을 ST-LINK로 확인해야 한다. | High | TSR-001 |
| DBG-004 | Flash erase/write 실패 시 HAL Flash error flag, sector boundary, write alignment를 확인해야 한다. | High | TSR-001 |
| DBG-005 | 라인트레이싱 제어 이상 발생 시 센서 입력, PWM 출력, 모터 드라이버 입력 신호를 확인해야 한다. | Low | TSR-001 |
| DBG-006 | 보안 검증 실패 사례는 로그상 실패 원인과 실제 입력 조건이 일치하는지 확인해야 한다. | High | TR-001, TSR-001 |

### 12.4 트러블슈팅 리포트 형식 요구사항

TSR-001에는 각 문제에 대해 다음 항목을 포함한다.

| 항목 | 설명 |
|---|---|
| Issue ID | 예: ISS-CAN-001, ISS-BL-001 |
| 증상 | 관찰된 문제 현상 |
| 재현 조건 | 문제가 발생하는 입력, 상태, 절차 |
| 초기 가설 | 가능한 원인 후보 |
| 사용 도구 | 오실로스코프, 로직분석기, 멀티미터, ST-LINK 등 |
| 측정/분석 결과 | 파형, 로그, 레지스터, 전압, 오류 플래그 등 |
| 원인 | 최종 원인 |
| 조치 | 코드/회로/배선/설계 수정 내용 |
| 재검증 | 동일 테스트 재수행 결과 |
| 연결 요구사항 | 관련 SRS/테스트 ID |

### 12.5 예상 트러블슈팅 사례

| Issue ID | 예상 문제 | 사용 도구 | 확인 포인트 | 기대 산출물 |
|---|---|---|---|---|
| ISS-CAN-001 | CAN 통신 불안정 | 오실로스코프, 멀티미터 | 종단저항, CANH/CANL 차동 파형 | 파형 캡처, 원인 분석 |
| ISS-PWR-001 | 모터 구동 시 ECU 리셋 | 오실로스코프, 멀티미터 | 전원 강하, GND 공유 문제 | 전원 분리/필터링 조치 기록 |
| ISS-BL-001 | Bootloader App jump 실패 | ST-LINK | MSP, Reset Handler, VTOR | 디버깅 캡처, 수정 전후 로그 |
| ISS-FL-001 | Flash write 실패 | ST-LINK | sector boundary, HAL error flag | sector map 수정 기록 |
| ISS-CAN-002 | TransferData 누락/순서 오류 | CANable, SocketCAN | sequence number, timeout | CAN 로그 및 NRC 기록 |
| ISS-SEN-001 | 라인트레이싱 오동작 | 로직분석기 | 센서 입력 타이밍, PWM duty | 센서/제어 주기 조정 기록 |

---
## 13. 데이터 및 메시지 요구사항

### 13.1 Manifest 예시 구조

```json
{
  "manifest_version": 1,
  "campaign_id": "CAMP-2026-001",
  "target_ecu_id": "DRIVE_ECU",
  "hardware_id": "F446RE-DRIVE-V1",
  "firmware_version": 2,
  "min_allowed_version": 1,
  "image_size": 98304,
  "image_hash_alg": "SHA-256",
  "image_hash": "<hex string>",
  "signature_alg": "ECDSA-P256 or Ed25519",
  "signature": "<hex string>",
  "metadata_version": 5,
  "expires_at": "2026-12-31T23:59:59+09:00"
}
```

### 13.2 Boot Metadata 요구 필드

| 필드 | 설명 |
|---|---|
| magic | Metadata 유효성 확인용 고정 값 |
| metadata_version | Metadata 구조 버전 |
| active_slot | 현재 실행 대상 Slot |
| confirmed_slot | 마지막으로 정상 확인된 Slot |
| pending_slot | 다음 부팅에서 검증할 후보 Slot |
| slot_a_version | Slot A 펌웨어 버전 |
| slot_b_version | Slot B 펌웨어 버전 |
| boot_attempt_count | 후보 Slot 부팅 시도 횟수 |
| last_error | 마지막 업데이트/부팅 실패 원인 |
| metadata_crc | Metadata 손상 검출용 CRC |

### 13.3 UDS-style 명령 요구사항

| SID | 명령명 | 용도 |
|---:|---|---|
| 0x10 | Diagnostic Session Control | Programming Session 진입 |
| 0x27 | Security Access | 업데이트 권한 확인 |
| 0x34 | Request Download | 다운로드 조건 협상 |
| 0x36 | Transfer Data | 펌웨어 Chunk 전송 |
| 0x37 | Request Transfer Exit | 데이터 전송 종료 |
| 0x31 | Routine Control | 이미지 검증, Self-test, Confirm 처리 |
| 0x11 | ECU Reset | 업데이트 후 재부팅 |
| 0x22 | Read Data By Identifier | ECU ID, Version, Slot 상태 조회 |
| 0x7F | Negative Response | 오류 응답 |

### 13.4 주요 Negative Response Code 예시

| NRC | 의미 |
|---:|---|
| 0x10 | General Reject |
| 0x11 | Service Not Supported |
| 0x12 | Sub-function Not Supported |
| 0x22 | Conditions Not Correct |
| 0x24 | Request Sequence Error |
| 0x31 | Request Out Of Range |
| 0x33 | Security Access Denied |
| 0x35 | Invalid Key |
| 0x36 | Exceeded Number Of Attempts |
| 0x72 | General Programming Failure |
| 0x73 | Wrong Block Sequence Counter |

---

## 14. Flash Partition 요구사항

### 14.1 기본 원칙

- F446RE의 하드웨어 Dual Bank Flash를 사용하는 것이 아니라, 단일 Flash를 논리적으로 분할한다.
- Bootloader 영역은 업데이트 중 덮어쓰지 않는다.
- 현재 Confirmed App Slot은 새 이미지 검증이 완료될 때까지 유지한다.
- Metadata는 App 영역과 분리하여 관리한다.

### 14.2 초기 파티션 제안

아래 파티션은 초기 제안이며, 최종 주소는 실제 Linker Script, Bootloader 크기, App 크기 측정 후 확정한다.

```text
0x08000000  Bootloader Area       128KB  섹터 0~4
0x08020000  App Slot A            128KB  섹터 5
0x08040000  App Slot B            128KB  섹터 6
0x08060000  Metadata / Log Area   128KB  섹터 7
```

### 14.3 파티션 관련 요구사항

| ID | 요구사항 | 우선순위 | 수용 기준 |
|---|---|---:|---|
| FR-FL-001 | Linker Script는 Bootloader와 App 주소를 분리해야 한다. | Must | App이 지정된 Slot 시작 주소에서 빌드되어야 한다. |
| FR-FL-002 | Bootloader는 App Vector Table 주소를 검증해야 한다. | Must | Stack Pointer와 Reset Handler가 유효 범위 내에 있어야 한다. |
| FR-FL-003 | Flash erase/write는 Slot 경계 내에서만 수행되어야 한다. | Must | Bootloader와 Metadata 영역 침범이 없어야 한다. |
| FR-FL-004 | App 크기가 Slot 크기를 초과하면 빌드 또는 업데이트 단계에서 실패 처리해야 한다. | Must | 초과 이미지가 설치되지 않아야 한다. |
| FR-FL-005 | Metadata는 손상 검출 정보를 포함해야 한다. | Should | metadata_crc 불일치 시 안전 정책으로 복구해야 한다. |

---

## 15. 테스트 요구사항

### 15.1 정상 기능 테스트

| 테스트 ID | 관련 요구사항 | 테스트 내용 | 기대 결과 |
|---|---|---|---|
| TC-NOR-001 | FR-GW-001, FR-CAN-001 | Gateway와 ECU CAN 통신 확인 | Inventory 응답 수신 |
| TC-NOR-002 | FR-BL-003 | Bootloader에서 App jump 확인 | App 정상 실행 |
| TC-NOR-003 | FR-CAN-002~009 | UDS-style 업데이트 전체 절차 수행 | 새 Slot에 이미지 설치 |
| TC-NOR-004 | FR-AB-004 | 새 App Self-test 및 Confirm | 새 Slot confirmed 처리 |
| TC-NOR-005 | FR-DRV-003 | Drive ECU App v1 ON/OFF 라인트레이싱 | 직선 주행 가능, 곡선 구간에서 진동/사행 주행 관찰 |
| TC-NOR-006 | FR-DRV-004 | OTA 후 App v2 비례 제어 주행 확인 | 동일 코스에서 곡선 추종이 v1 대비 부드러워짐 확인 |
| TC-NOR-007 | FR-SEN-002, FR-SEN-004 | Sensor ECU v1(15cm)/v2(25cm) 임계값 동작 확인 | v1: 15cm 이하 감지, v2: OTA 후 25cm 이하 감지, Drive ECU 정지/감속 반영 |

### 15.2 실패 복구 테스트

| 테스트 ID | 관련 요구사항 | 테스트 내용 | 기대 결과 |
|---|---|---|---|
| TC-FAIL-001 | FR-AB-005 | 업데이트 중 전원 차단 | 기존 Confirmed App 부팅 |
| TC-FAIL-002 | FR-CAN-006 | Transfer Data Sequence 누락 | Request Sequence Error 응답 |
| TC-FAIL-003 | FR-BL-012 | 업데이트 중 통신 중단 | Timeout 후 abort |
| TC-FAIL-004 | FR-AB-004 | 새 App Self-test 실패 | 이전 Slot rollback |
| TC-FAIL-005 | FR-FL-004 | Slot 크기 초과 이미지 전송 | Request Out Of Range 또는 Programming Failure |

### 15.3 보안 공격 테스트

| 테스트 ID | 관련 요구사항 | 공격 시나리오 | 기대 결과 |
|---|---|---|---|
| TC-SEC-001 | SR-ATK-001 | Firmware 1바이트 변조 | Hash mismatch로 거부 |
| TC-SEC-002 | SR-ATK-002 | unsigned firmware 설치 시도 | Signature verification failure |
| TC-SEC-003 | SR-ATK-003 | 낮은 버전 firmware 설치 | Anti-rollback으로 거부 |
| TC-SEC-004 | SR-ATK-004 | ECU ID 불일치 image 전송 | Target mismatch로 거부 |
| TC-SEC-005 | SR-ATK-005 | 이전 Transfer Data replay | Sequence/Freshness 오류로 거부 |
| TC-SEC-006 | SR-ATK-006 | Security Access 없이 Request Download | Security Access Denied |
| TC-SEC-007 | SR-ATK-007 | Manifest size 초과 Transfer Data | Endless data 방어, 세션 종료 |
| TC-SEC-008 | SR-ATK-008 | CAN Flood 중 업데이트 | Timeout/Abort 후 기존 App 유지 |
| TC-SEC-009 | SR-ATK-009 | Fake complete 명령 전송 | ECU 내부 검증 실패 시 commit 거부 |
| TC-SEC-010 | SR-ATK-010 | 한 ECU만 업데이트 성공 | Campaign partial/fail 기록 |

### 15.4 개발 프로세스 및 디버깅 검증

| 테스트 ID | 관련 요구사항 | 검증 내용 | 기대 결과 |
|---|---|---|---|
| TC-PRC-001 | PRC-001, RTM-001 | 요구사항 ID 체계 및 RTM 작성 여부 확인 | 주요 요구사항이 설계/구현/테스트와 연결됨 |
| TC-PRC-002 | PRC-003, RTM-002 | 보안 요구사항과 공격 테스트 연결 확인 | 각 보안 요구사항에 관련 TC가 존재함 |
| TC-DBG-001 | DBG-001 | CAN 통신 문제 사례 문서화 | CAN 로그 또는 파형 기반 원인 분석 기록 |
| TC-DBG-002 | DBG-003 | App jump 문제 사례 문서화 | ST-LINK 기반 MSP/VTOR/Reset Handler 확인 기록 |
| TC-DBG-003 | DBG-004 | Flash write 문제 사례 문서화 | Flash error flag 또는 sector boundary 분석 기록 |
| TC-DBG-004 | DBG-006 | 보안 검증 실패 로그 일관성 확인 | 실패 원인과 입력 조건이 문서/로그에 일치함 |

---

## 16. 요구사항 추적성 매트릭스

| 요구사항 그룹 | 대표 ID | 관련 테스트 |
|---|---|---|
| Gateway | FR-GW-001 ~ FR-GW-008 | TC-NOR-001, TC-NOR-003, TC-SEC-010 |
| Bootloader | FR-BL-001 ~ FR-BL-012 | TC-NOR-002, TC-NOR-003, TC-FAIL-001 ~ TC-FAIL-005 |
| A/B Rollback | FR-AB-001 ~ FR-AB-007 | TC-NOR-004, TC-FAIL-001, TC-FAIL-004 |
| CAN / ISO-TP / UDS | FR-CAN-001 ~ FR-CAN-017 | TC-NOR-003, TC-FAIL-002, TC-SEC-005 |
| Drive ECU App | FR-DRV-001 ~ FR-DRV-006 | TC-NOR-005, TC-NOR-006, TC-NOR-007 |
| Sensor ECU App | FR-SEN-001 ~ FR-SEN-005 | TC-NOR-007 |
| Manifest / Firmware Security | SR-MF-001 ~ SR-MF-008, SR-FW-001 ~ SR-FW-006 | TC-SEC-001 ~ TC-SEC-004 |
| Attack Defense | SR-ATK-001 ~ SR-ATK-010 | TC-SEC-001 ~ TC-SEC-010 |
| Uptane-lite | SR-UP-001 ~ SR-UP-005 | TC-NOR-001, TC-SEC-003, TC-SEC-010 |
| Flash Partition | FR-FL-001 ~ FR-FL-005 | TC-NOR-002, TC-FAIL-005 |
| 개발 프로세스 | PRC-001 ~ PRC-007 | TC-PRC-001, TC-PRC-002 |
| 추적성 관리 | RTM-001 ~ RTM-005 | TC-PRC-001, TC-PRC-002 |
| 계측/디버깅 | DBG-001 ~ DBG-006 | TC-DBG-001 ~ TC-DBG-004 |

---

## 17. 산출물 요구사항

본 프로젝트의 산출물은 제출 산출물과 엔지니어링 문서 산출물로 구분한다.

### 17.1 제출 산출물

| 산출물 ID | 산출물 | 형식 | 목적 |
|---|---|---|---|
| DEL-001 | 프로젝트 발표 PPT | PPT | 시스템 목적, 구조, 구현 결과, 검증 결과 요약 |
| DEL-002 | 소스코드 저장소 | GitHub | 구현 코드, 빌드 방법, 필수 문서 7종 포함 |
| DEL-003 | 시연 동영상 | 동영상 | OTA 동작, 공격 시나리오 방어, rollback 결과 실증 |
| DEL-004 | 작품소개서 | 문서 | 시스템 개요, 핵심 기능, 보안 설계, 검증 결과 요약 |
| DEL-005 | 개발 작품 하드웨어 | 실물 | 차체, Dual ECU, Gateway, CAN Bus 결합 실물 |

### 17.3 필수 엔지니어링 문서 산출물 7종

본 프로젝트는 ASPICE SWE.1~SWE.6 개발 주기에 대응하는 다음 7종의 문서를 필수 산출물로 작성해야 한다.

| 필수 여부 | 문서 ID | 문서명 | ASPICE 대응 | 목적 |
|---|---|---|---|---|
| 필수 | SRS-001 | Software Requirements Specification | SWE.1 | 프로젝트 범위, 기능/비기능/보안/검증/산출물 요구사항 정의 |
| 필수 | SAD-001 | Software Architectural Design | SWE.2 | 전체 시스템 아키텍처, ECU 역할 분담, 컴포넌트 간 인터페이스, 소프트웨어 레이어 구조 정의 |
| 필수 | SDD-001 | Software Detailed Design | SWE.3 | Bootloader 상태 전이, Flash 파티션, ISO-TP 상태 머신, UDS 서비스별 처리 함수, CAN ID 할당 상세 정의 |
| 필수 | RTM-001 | Requirements Traceability Matrix | SWE.1~6 | 요구사항-설계-구현-테스트-결과 양방향 연결 관리 |
| 필수 | TP-001 | Test Plan | SWE.5/6 | 정상/실패/보안/디버깅 테스트 계획 정의 |
| 필수 | TR-001 | Test Report | SWE.5/6 | 테스트 실행 결과, PASS/FAIL, 로그, 사진/영상 증빙 정리 |
| 필수 | TSR-001 | Troubleshooting Report | SUP.9 | 오실로스코프, 로직분석기, 멀티미터, ST-LINK 기반 문제 분석 및 해결 과정 정리 |

### 17.4 선택 엔지니어링 문서 산출물

필수 7종 외에도 프로젝트 완성도를 높이기 위해 다음 문서는 선택적으로 작성할 수 있다.

| 문서 ID | 문서명 | 목적 |
|---|---|---|
| CAN-001 | CAN / ISO-TP / UDS Message Specification | CAN ID, ISO-TP 프레임, UDS SID/NRC 별도 명세가 필요한 경우 (SDD-001에 포함 가능) |
| SEC-001 | Threat Model & Attack Scenario | 공격자 모델, 공격 시나리오, 방어 요구사항 정의 |
| CHG-001 | Change Log | 요구사항/설계/구현 변경 이력 관리 |
| RN-001 | Release Note | App v1/v2 변경점 및 OTA 결과 정리 |

### 17.5 필수 문서 간 추적 관계

필수 문서 7종은 다음 관계를 가져야 한다.

```text
SRS-001  (SWE.1)
  ↓ 요구사항 ID → 컴포넌트 할당
SAD-001  (SWE.2)
  ↓ 아키텍처 컴포넌트 → 상세 설계
SDD-001  (SWE.3)
  ↓ 함수/모듈/프로토콜 명세 → 구현
  ↕ 요구사항-설계-구현-테스트 양방향 연결
RTM-001
  ↓ 테스트 케이스 연결
TP-001   (SWE.5/6)
  ↓ 테스트 케이스 실행
TR-001   (SWE.5/6)
  ↓ 실패/비정상 현상 발생 시
TSR-001  (SUP.9)
  ↓ 원인 분석 및 재발 방지 → SRS/SAD/SDD/RTM 반영
```

| 연결 기준 | 요구사항 |
|---|---|
| SRS → SAD | 모든 주요 기능/보안 요구사항은 SAD의 컴포넌트 또는 인터페이스 항목으로 할당되어야 한다. |
| SAD → SDD | 아키텍처의 각 컴포넌트는 SDD에서 상태 전이, 함수, 자료구조 수준으로 상세화되어야 한다. |
| SDD → RTM | SDD의 설계 항목은 RTM에서 요구사항 ID 및 구현 파일/함수와 연결되어야 한다. |
| RTM → TP | 각 핵심 요구사항은 최소 1개 이상의 테스트 케이스와 연결되어야 한다. |
| TP → TR | 테스트 케이스는 실행 결과, 로그, PASS/FAIL, 증빙 자료와 연결되어야 한다. |
| TR → TSR | 테스트 중 발생한 주요 실패 또는 비정상 현상은 TSR에 원인 분석과 해결 조치로 기록되어야 한다. |
| TSR → SRS/RTM | 트러블슈팅 결과 요구사항 또는 설계 변경이 필요하면 SRS/SAD/SDD/RTM에 반영되어야 한다. |

---

## 18. 성공 기준

본 프로젝트는 다음 조건을 만족하면 1차 성공으로 판단한다.

1. Raspberry Pi 5와 STM32F446RE 2대가 CAN으로 통신한다.
2. 각 ECU가 Custom Bootloader를 통해 App으로 정상 jump한다.
3. Gateway가 UDS over ISO-TP 절차로 각 ECU에 Full Image OTA를 수행한다.
4. 새 이미지는 비활성 Slot에 기록된다.
5. Hash, Signature, Version, ECU ID 검증이 수행된다.
6. 검증 성공 후 새 Slot으로 부팅하고 Self-test 후 Confirmed 처리된다.
7. 업데이트 실패 또는 전원 차단 시 기존 Confirmed Slot으로 복구된다.
8. Drive ECU App v1/v2의 라인트레이싱 동작 차이가 확인된다.
9. Sensor ECU의 장애물 감지 메시지가 Drive ECU 동작에 반영된다.
10. 변조, unsigned, downgrade, replay, unauthorized update, CAN flood 공격 시나리오가 거부 또는 안전 실패 처리된다.
11. 요구사항-설계-구현-테스트 추적성 문서와 테스트 로그가 남는다.
12. 주요 디버깅 이슈는 사용 도구, 측정 근거, 원인, 조치, 재검증 결과를 포함하여 TSR-001에 기록된다.

---

## 19. 한계 및 명시적 인정 사항

본 시스템은 가용 개발 플랫폼(STM32F446RE, Raspberry Pi 5) 기반의 축소형 전장 OTA 검증 시스템이다. 다음 한계 사항을 명시한다.

1. STM32F446RE는 실제 차량용 HSM MCU가 아니므로 양산 ECU 수준의 키 보호와 Secure Boot ROM을 제공하지 않는다.
2. F446RE는 하드웨어 Dual Bank Flash 구조가 아니므로, 단일 Flash를 논리적으로 분할한 A/B Slot 구조를 사용한다.
3. UDS는 정식 상용 UDS 스택 전체 구현이 아니라, 리프로그래밍 절차를 참고한 UDS-style 구조이다.
4. Uptane은 전체 표준 구현이 아니라, Manifest, ECU Inventory, Version Report, Rollback 방어, Partial Bundle 방어 개념을 참고한 Uptane-lite 구조이다.
5. Delta Update는 1차 구현 범위에서 제외하고, Full Image 기반 A/B Secure OTA에 집중한다.
6. ASPICE는 공식 준수 또는 평가가 아니라, 요구사항 기반 개발과 추적성 개념을 참고한 수준으로 적용한다.
7. 공격자 시나리오는 자체 제작한 CAN 테스트 네트워크 내부에서만 수행한다.
8. 실제 차량의 IGN 상태, 배터리 전압 조건, DTC, 네트워크 슬립/웨이크업, 서비스센터 복구 정책은 1차 범위에서 제외한다.

이러한 한계를 인정한 상태에서, 본 프로젝트는 개인이 구현 가능한 범위 내에서 Secure OTA의 핵심 설계 사고와 전장 펌웨어 개발 역량을 증명하는 것을 목표로 한다.

---

## 20. 향후 확장 방향

1차 구현 이후 다음 확장을 고려할 수 있다.

| 확장 항목 | 목적 |
|---|---|
| ISO-TP 멀티 세션 확장 | 복수 ECU 동시 업데이트 세션 관리 구현 |
| Delta Update | CAN 전송량과 업데이트 시간을 줄이는 최적화 실험 |
| 차량용 MCU 보드 포팅 | AURIX, S32K, SPC5 등 차량용 MCU 경험 확장 |
| HSM/Secure Element 연동 | 키 저장과 서명 검증 보안성 강화 |
| CANoe/CANalyzer 또는 대체 도구 연동 | 테스트 자동화와 CAN 로그 분석 전문성 강화 |
| DTC/진단 서비스 추가 | OTA 실패 원인과 ECU 상태를 진단 서비스로 조회 |
| 배터리 전압/주행 상태 조건 추가 | 실제 차량 OTA 조건에 가까운 업데이트 조건 제어 |

---

## 22. 용어 정의

| 용어 | 정의 |
|---|---|
| OTA | Over-The-Air. 네트워크를 통한 소프트웨어/펌웨어 업데이트 |
| ECU | Electronic Control Unit. 차량 내 전자제어장치 |
| Gateway | 여러 ECU와 외부 업데이트 서버 사이에서 업데이트를 중계하는 노드 |
| Bootloader | Reset 후 먼저 실행되어 App 검증, 업데이트, App jump를 담당하는 펌웨어 |
| App Slot | 실행 가능한 Application Image가 저장되는 Flash 영역 |
| A/B Update | 기존 App을 유지한 채 비활성 Slot에 새 App을 설치하고 검증 후 전환하는 업데이트 방식 |
| Rollback | 새 App 실패 시 이전 정상 App으로 복구하는 동작 |
| Manifest | 업데이트 대상, 버전, 크기, Hash, Signature 등을 담은 메타데이터 |
| Hash | 데이터 무결성 검증을 위한 요약값 |
| Signature | 펌웨어가 신뢰된 배포자로부터 왔음을 확인하기 위한 전자서명 |
| Anti-rollback | 취약한 구버전 펌웨어 재설치를 방지하는 정책 |
| UDS | Unified Diagnostic Services. 차량 진단 서비스 표준 |
| UDS-style | 본 프로젝트에서 UDS 개념을 참고하여 축소 구현한 명령 구조 |
| Uptane-lite | Uptane의 메타데이터/위협 모델 개념을 참고한 축소형 OTA 보안 구조 |
| CAN | Controller Area Network. 차량용 네트워크 프로토콜 |
| DTC | Diagnostic Trouble Code. 진단 고장 코드 |
| ASPICE-inspired | Automotive SPICE를 공식 준수하지는 않지만 요구사항 기반 개발, 추적성, 검증 연계 개념을 참고하는 방식 |
| RTM | Requirements Traceability Matrix. 요구사항-설계-구현-테스트 연결표 |
| TSR | Troubleshooting Report. 문제 발생, 분석, 조치, 재검증 과정을 기록한 문서 |
| VTOR | Vector Table Offset Register. Cortex-M에서 인터럽트 벡터 테이블 위치를 지정하는 레지스터 |

---

## 23. 개정 이력

| 버전 | 날짜 | 변경 내용 |
|---|---|---|
| 1.0 | 2026-05-15 | 초기 Secure OTA SRS 작성 |
| 1.1 | 2026-05-15 | 라인트레이싱 차량 실증, 논리적 A/B Slot, Uptane-lite, 공격 시나리오, Delta Update 제외 범위 반영 |
| 1.2 | 2026-05-15 | ASPICE-inspired 개발 관리, 요구사항 추적성, 계측기 기반 트러블슈팅, 디버깅 검증 요구사항 반영 |
| 1.3 | 2026-05-15 | 최종 제출 산출물 5종과 필수 문서 산출물 5종(SRS, RTM, TP, TR, TSR) 요구사항 반영 |
| 1.4 | 2026-05-16 | ISO-TP 전송 계층 추가, SAD-001/SDD-001 필수 문서 추가(필수 문서 7종 확장), 산출물 요구사항 간소화, Drive ECU v1/v2 조작변인 구체화(ON/OFF → 비례 제어), Sensor ECU v1/v2 임계값 구체화(15cm → 25cm), HC-SR04 확정 |
