JaehyeongIm/automotive-secure-ota-ecu/docs/SRS-001_CAN_Secure_OTA_Pipeline_v1.4.md

# SRS-001: CAN 기반 UDS over ISO-TP Secure OTA 파이프라인 요구사항 명세서

| 항목 | 내용 |
|---|---|
| 문서 ID | SRS-001 |
| 문서명 | CAN 기반 UDS over ISO-TP Secure OTA 파이프라인 요구사항 명세서 |
| 프로젝트명 | Dual ECU 버튼 트리거 직진 주행 Secure OTA 시스템 |
| 버전 | 2.4 |
| 작성일 | 2026-05-25 |
| 작성 목적 | Dual ECU 버튼 트리거 직진 주행 + 장애물 회피 OTA 데모 시스템 소프트웨어 요구사항 정의 |
| 주요 대상 | Raspberry Pi 5 Gateway, STM32F446RE ECU 2대, CAN Bus, Custom Bootloader, RC 차량 데모 플랫폼 |
| 범위 변경 | 1.7 대비 주행 방식 변경(라인트레이싱 → 버튼 트리거 직진), App v1/v2 2단계 OTA 구조 확정, Uptane 지연 활성화 도입, 장애물 임계값 단일화(10cm) |

---

## 1. 개요

### 1.1 프로젝트 목적

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

단순히 펌웨어 파일을 전송하는 데 그치지 않고, 다음 요소를 포함한 전장형 OTA 구조를 구현한다.

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

### 1.2 시스템 목표

본 시스템이 달성해야 하는 핵심 목표는 다음과 같다.

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

---

## 2. 프로젝트 범위

### 2.1 In Scope

본 프로젝트에서 구현 대상에 포함되는 범위는 다음과 같다.

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

### 2.2 Out of Scope

다음 항목은 본 프로젝트의 1차 구현 범위에서 제외한다.

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

---

## 3. 시스템 개요

### 3.1 전체 시스템 구성

```text
[개발자 PC]
        |
        | Git Push (로컬 네트워크)
        v
[Raspberry Pi 5: Jenkins CI/CD 서버 + OTA Gateway]
  ┌─ CI/CD 파이프라인 (Jenkins) ──────────────────┐
  │  Stage 1: 크로스컴파일 (arm-none-eabi-gcc)    │
  │  Stage 2: 정적 분석 (cppcheck)                │
  │  Stage 3: 바이너리 크기 검사 (≤ 128KB)        │
  │  Stage 4: ECDSA 서명 + Manifest 생성          │
  │  Stage 5: OTA 배포 스크립트 실행              │
  └───────────────────────────────────────────────┘
  ┌─ OTA Gateway ─────────────────────────────────┐
  │  - ECU Inventory 수집                          │
  │  - Update Campaign 상태 관리                   │
  │  - 공격자 시나리오 실행                        │
  └───────────────────────────────────────────────┘
        |
        | CAN Bus
        v
+----------------------------+      +------------------------------+
| STM32F446RE ECU #1         |      | STM32F446RE ECU #2           |
| Drive ECU                  |      | Sensor/Body ECU              |
| - Custom Bootloader        |      | - Custom Bootloader          |
| - A/B App Slot             |      | - A/B App Slot               |
| - Button-Trigger Drive     |      | - Distance/Obstacle Sensing  |
| - Motor Control (PWM)      |      | - Status Message Tx          |
+----------------------------+      +------------------------------+
```

### 3.2 주요 하드웨어 역할

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

---

## 4. 사용자 및 이해관계자

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

---

## 5. 운영 시나리오

### 5.1 정상 업데이트 시나리오

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

### 5.2 실패 복구 시나리오

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

### 5.3 공격자 검증 시나리오

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

---

## 6. 시스템 제약사항

### 6.1 MCU 제약

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

### 6.2 CAN / ISO-TP 제약

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

### 6.3 프로젝트 범위 제약

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

---

## 7. 기능 요구사항

### 7.1 OTA Gateway 요구사항

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

### 7.2 ECU Bootloader 요구사항

| ID | 요구사항 | 우선순위 | 수용 기준 |
|---|---|---:|---|
| FR-BL-001 | 각 STM32F446RE ECU는 Custom Bootloader를 포함해야 한다. | Must | Reset 후 Bootloader가 먼저 실행되어야 한다. |
| FR-BL-002 | Bootloader는 현재 활성 Slot과 후보 Slot을 구분해야 한다. | Must | Metadata에서 active, pending, confirmed 상태를 읽을 수 있어야 한다. |
| FR-BL-003 | Bootloader는 유효한 App이 있을 경우 해당 App으로 jump해야 한다. | Must | Vector Table 설정 후 App Reset Handler로 정상 진입해야 한다. |
| FR-BL-004 | Bootloader는 CAN 기반 업데이트 세션에 진입할 수 있어야 한다. | Must | 특정 조건 또는 명령 수신 시 update mode에 진입해야 한다. |
| FR-BL-005 | Bootloader는 수신한 펌웨어 조각을 비활성 Slot에 기록해야 한다. | Must | Flash erase/write가 섹터 경계와 주소 범위 내에서 수행되어야 한다. |
| FR-BL-006 | Bootloader는 펌웨어 전체 Hash를 검증해야 한다. | Must | Manifest의 Hash와 실제 Slot 이미지 Hash가 일치해야 한다. |
| FR-BL-007 | Bootloader는 펌웨어 Signature를 검증해야 한다. | Must | 공개키 기반 검증 실패 시 업데이트를 거부해야 한다. |
| FR-BL-008 | Bootloader는 Firmware Version을 확인하고 다운그레이드를 차단해야 한다. | Must | 현재 Confirmed Version보다 낮은 버전은 거부해야 한다. |
| FR-BL-009 | Bootloader는 Target ECU ID/HW ID를 확인해야 한다. | Must | 다른 ECU용 이미지 설치를 거부해야 한다. |
| FR-BL-010 | Bootloader는 업데이트 후 첫 부팅에서 Self-test 결과를 확인해야 한다. | Must | Self-test 실패 시 이전 Confirmed Slot으로 rollback해야 한다. |
| FR-BL-011 | Bootloader는 Boot Metadata 손상 시 안전한 기본 정책을 적용해야 한다. | Should | Metadata CRC 오류 시 기존 Confirmed Slot 또는 Safe Mode로 진입해야 한다. |
| FR-BL-012 | Bootloader는 IWDG(Independent Watchdog)를 사용하여 MCU 무응답 상태를 감지해야 한다. | Must | IWDG 타임아웃은 8000ms로 설정하며, Flash erase/write 구간에서 주기적으로 피딩하여 의도치 않은 리셋을 방지해야 한다. Transfer Data 미수신 5000ms 초과 시 소프트웨어적으로 세션을 abort하고 기존 App을 유지해야 한다. |
| FR-BL-013 | Bootloader Flash 영역은 STM32 WRP(Write Protection)로 보호되어야 한다. | Should | Bootloader 섹터(0x08000000~0x0801FFFF, Sector 0~4)에 WRP가 설정된 상태에서 해당 영역 write 시도가 거부되어야 한다. |

### 7.3 A/B Slot 및 Rollback 요구사항

#### 7.3.1 슬롯 상태 모델

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

#### 7.3.2 요구사항

| ID | 요구사항 | 우선순위 | 수용 기준 |
|---|---|---:|---|
| FR-AB-001 | 시스템은 논리적 A/B App Slot을 사용하며, 각 슬롯은 INVALID/UPDATING/UPDATED/TRIAL/CONFIRMED 5상태(§7.3.1)로 관리해야 한다. | Must | 임의 시점에 CONFIRMED-active 슬롯은 최대 1개여야 한다. 두 슬롯이 모두 CONFIRMED이면 active_slot이 우선하고, 모두 비유효(INVALID/검증실패)이면 Safe State(NFR-SAFE-004)로 진입해야 한다. |
| FR-AB-002 | 업데이트 이미지는 실행 중이 아닌 비활성 Slot에만 기록하며, 기록 구간 동안 해당 슬롯을 UPDATING으로 표시해야 한다. | Must | 현재 CONFIRMED Slot은 업데이트 과정에서 erase/write되지 않아야 한다. |
| FR-AB-003 | 새 Slot은 정적 검증(이미지 헤더 서명·hash·version, FR-AB-008)을 통과하기 전까지 Boot Target으로 선택되지 않아야 한다. 검증 불가·헤더 부재는 PASS가 아니라 **검증 실패(fail-closed)**로 처리한다. | Must | 헤더/서명/hash/version 중 하나라도 검증 실패 또는 검증 불가 시 기존 CONFIRMED Slot이 유지되어야 한다. `image_size==0` 등 검증을 우회하는 경로가 존재하지 않아야 한다(ISO 24089/R155 deny-by-default). |
| FR-AB-004 | 새 App은 부팅 후 **측정 가능한 Self-test**를 통과해야 CONFIRMED로 전이되며, Confirm 주체는 ECU 자신이어야 한다. | Must | 다음 4개를 부팅 후 Tboot 이내 모두 만족 시 PASS: ① app main 루프 진입, ② CAN/Timer/모터·센서 페리페럴 init 성공, ③ CAN heartbeat 1회 송신 성공, ④ 런타임 APP_VERSION == 이미지 헤더 version(FR-AB-008). PASS 시 ECU가 메타를 TRIAL→CONFIRMED로 기록한다. Gateway의 완료 명령만으로는 CONFIRMED되지 않아야 한다(SR-ATK-009). **Tboot**는 타깃 실측 worst-case(리셋~Self-test 완료)의 2배 이상 여유로 유도하되 IWDG 윈도우(8000ms) 미만이어야 하며, 측정 방식은 **ADR-002**를 따른다. |
| FR-AB-005 | 업데이트(특히 메타데이터 갱신) 도중 전원 차단이 발생해도 기존 CONFIRMED App이 유지되어야 하며, 메타데이터는 **원자적으로** 갱신되어야 한다. | Must | 메타데이터를 **2개의 분리된 플래시 섹터에 이중화(redundant)**하고 각 사본에 CRC32와 monotonic `seq_counter`를 둔다. 갱신은 구(舊) 사본에 기록하고 CRC를 **마지막에** 기록하며, 부팅 시 CRC가 유효하고 seq가 최신인 사본을 선택한다(AUTOSAR NvM redundant-block 패턴). 메타 쓰기 중 전원 차단 테스트 후 기존 App으로 정상 부팅해야 한다. |
| FR-AB-006 | Boot Metadata는 슬롯 상태(slot_a/b_status), active/confirmed/pending slot, slot 버전, boot_attempt_count, last_error, metadata_crc, seq_counter를 관리해야 한다. | Should | §13.3의 필드를 모두 포함하고, metadata dump 또는 로그에서 상태 확인이 가능해야 한다. |
| FR-AB-007 | 부트로더는 UPDATED 슬롯으로 점프하기 **직전** boot_attempt_count를 비휘발성으로 1 증가시키고, Self-test PASS 시 0으로 리셋하며 CONFIRMED로 전이해야 한다. count가 3을 초과하면 해당 슬롯을 INVALID로 마킹하고 이전 CONFIRMED Slot으로 롤백해야 한다. | Should | hang·crash·reset 등 Self-test를 완료하지 못한 **모든** 경우가 카운트되어, 3회 초과 시 자동 롤백이 확인되어야 한다(증가-먼저-점프). 임계값 3과 롤백 총지연(3×부팅시간)은 ISO 26262 FTTI 범위 및 IWDG 윈도우 내여야 한다. |
| FR-AB-008 | 각 App 이미지는 고정 오프셋(offset 0)에 **서명으로 보호되는 Image Header**를 포함해야 한다. | Must | 헤더는 `{magic, header_version, target_ecu_id, hardware_id, fw_version, image_size, image_hash}`를 포함하고, ECDSA 서명이 (헤더+코드)를 함께 덮어야 한다. 부트로더는 이미지를 **실행하지 않고** 헤더만 읽어 anti-rollback(fw_version, FR-BL-008/SR-FW-003)과 ECU ID 일치(FR-BL-009)를 검증한다. 기대 fw_version의 출처는 서명된 Manifest(§13.1)이며, ECU는 Gateway의 Manifest를 신뢰하지 않고 헤더+서명으로 독립 검증해야 한다(SR-UP-004, Uptane). |

### 7.4 CAN / ISO-TP / UDS 프로토콜 요구사항

| ID | 요구사항 | 우선순위 | 수용 기준 |
|---|---|---:|---|
| FR-CAN-001 | 시스템은 CAN 기반 ECU 업데이트 통신을 수행해야 한다. | Must | Gateway와 각 ECU 간 CAN 송수신이 가능해야 한다. |
| FR-CAN-002 | 모든 UDS 메시지는 ISO-TP 전송 계층을 통해 송수신되어야 한다. | Must | ISO-TP 없이 직접 CAN 프레임으로 UDS 명령을 송수신하지 않아야 한다. |
| FR-CAN-003 | ECU는 ISO-TP SF(Single Frame)를 수신하여 UDS 명령을 처리해야 한다. | Must | 7바이트 이하 UDS 명령이 SF로 수신되어 정상 처리되어야 한다. |
| FR-CAN-004 | ECU는 ISO-TP FF/CF(First Frame / Consecutive Frame)를 수신하여 UDS 페이로드를 조립해야 한다. | Must | 다중 프레임으로 분할된 Transfer Data 페이로드가 누락 없이 조립되어야 한다. |
| FR-CAN-005 | ECU는 FF 수신 후 ISO-TP FC(Flow Control) 프레임을 송신해야 한다. | Must | FC 프레임의 FlowStatus, BlockSize, STmin 필드가 정확히 설정되어야 한다. |
| FR-CAN-006 | ECU는 ISO-TP STmin 타이밍을 준수해야 한다. | Must | CF 프레임 간 수신 간격이 STmin 이하일 경우 오류 처리해야 한다. |
| FR-CAN-007 | Gateway는 SocketCAN ISO-TP 인터페이스를 통해 UDS 메시지를 송수신해야 한다. | Must | Python socket(AF_CAN, SOCK_DGRAM, CAN_ISOTP) 기반으로 전송되어야 한다. |
| FR-CAN-008 | 명령 구조는 UDS 리프로그래밍 절차를 따르며, FR-CAN-009~015가 이를 구성하는 개별 요구사항이다. | Must | FR-CAN-009~015 요구사항이 모두 구현되어야 한다. |
| FR-CAN-009 | Diagnostic Session Control 명령을 지원해야 한다. | Must | Default Session과 Programming Session 상태를 구분해야 한다. |
| FR-CAN-010 | Security Access 명령을 지원해야 한다. | Must | ECU가 4바이트 랜덤 Seed를 생성하고, Gateway가 HMAC-SHA256(Seed \|\| PreSharedKey)의 앞 4바이트를 Key로 응답하면 인증이 성공해야 한다. 연속 3회 Key 오류 시 NRC 0x36(Exceeded Number of Attempts)을 반환하고 10초간 Security Access를 잠금해야 한다. |
| FR-CAN-011 | Request Download 명령을 지원해야 한다. | Must | Image size, target slot, target ECU ID를 확인해야 한다. |
| FR-CAN-012 | Transfer Data 명령을 지원해야 한다. | Must | Sequence Number와 Chunk 길이를 확인해야 한다. |
| FR-CAN-013 | Request Transfer Exit 명령을 지원해야 한다. | Must | 모든 Chunk 수신 후 검증 단계로 진입해야 한다. |
| FR-CAN-014 | Routine Control - Verify Image 명령을 지원해야 한다. | Must | Hash/Signature/Version/ECU ID 검증 결과를 반환해야 한다. |
| FR-CAN-015 | ECU Reset 명령을 지원해야 한다. | Must | 검증 성공 후 Reset을 통해 새 Slot 부팅을 시도해야 한다. |
| FR-CAN-016 | Negative Response Code를 정의해야 한다. | Must | 잘못된 세션, 보안 실패, 길이 오류, 순서 오류, 인증 실패 등을 구분해야 한다. |
| FR-CAN-017 | Replay 방어를 위한 Session ID 또는 Freshness Counter를 사용해야 한다. | Should | 이전 세션의 Transfer Data 재전송이 거부되어야 한다. |

### 7.5 Drive ECU Application 요구사항

| ID | 요구사항 | 우선순위 | 수용 기준 |
|---|---|---:|---|
| FR-DRV-001 | Drive ECU는 TB6612FNG를 통해 좌우 모터를 PWM 제어해야 한다. | Must | PWM 기반 좌우 모터 속도 제어 및 후진 방향 제어가 가능해야 한다. |
| FR-DRV-002 | Drive ECU는 B1(USER) 버튼 입력을 EXTI 인터럽트로 감지하여 주행을 시작해야 한다. | Must | B1 버튼 누름 후 300ms 디바운스 처리 후 g_button_pressed 플래그가 설정되어 DRIVE_IDLE → DRIVE_RUNNING 전이가 발생해야 한다. |
| FR-DRV-003 | Drive ECU App v1은 버튼 트리거 직진 주행 중 장애물이 10cm 이내 감지되면 즉시 정지해야 한다. | Must | 주행 시작 후 최대 3000ms 직진하며, 10cm 이하 장애물 감지 시(g_obstacle_flag) 즉시 모터를 정지하고 DRIVE_IDLE로 복귀해야 한다. |
| FR-DRV-004 | Drive ECU App v2는 v1 정지 후 자동 후진 복귀를 구현해야 한다. | Should | 10cm 이하 정지 후 300ms 대기, 600ms 후진(SLOW_SPEED), DRIVE_IDLE 복귀 순서로 동작해야 한다. |
| FR-DRV-006 | Drive ECU는 현재 App Version과 Slot 정보를 CAN으로 보고해야 한다. | Must | CAN ID 0x100 heartbeat에 APP_VERSION, 활성 슬롯, 주행 상태, 장애물 상태가 포함되어야 한다. |
| FR-DRV-007 | Drive ECU는 OTA 다운로드(TransferData) 진행 중에도 주행 기능을 유지해야 한다. | Must | RequestDownload(0x34) 수신 후 g_ota_active=1 구간(Flash Erase ~4초)에만 모터가 정지되며, 그 외 TransferData 구간에서는 drive_update()가 정상 실행되어야 한다. |
| FR-DRV-008 | Drive ECU는 DRIVE_IDLE 상태 진입 시 g_fw_pending 플래그를 확인하여 재부팅으로 펌웨어를 활성화해야 한다. | Must | TransferExit(0x37) 완료 후 g_fw_pending=1이 설정되고, 다음 DRIVE_IDLE 진입 시 NVIC_SystemReset()이 호출되어 Bootloader가 새 슬롯으로 부팅해야 한다. (Uptane 지연 활성화) |

### 7.6 Sensor/Body ECU Application 요구사항

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

### 7.7 CI/CD 파이프라인 요구사항

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

| ID | 요구사항 | 우선순위 | 수용 기준 |
|---|---|---:|---|
| FR-CICD-001 | Jenkins 서버는 Raspberry Pi 5에 설치되어 운용되어야 한다. | Must | Jenkins 웹 UI에 접근 가능하고 파이프라인 실행 이력이 기록되어야 한다. |
| FR-CICD-002 | Git 저장소에 push 이벤트 발생 시 Jenkins 파이프라인이 자동으로 트리거되어야 한다. | Must | 소스코드 커밋 후 수동 개입 없이 파이프라인이 시작되어야 한다. |
| FR-CICD-003 | Stage 1에서 arm-none-eabi-gcc를 통해 Drive ECU 및 Sensor ECU 펌웨어를 크로스컴파일해야 한다. | Must | 빌드 오류 발생 시 이후 Stage가 실행되지 않고 파이프라인이 중단되어야 한다. |
| FR-CICD-004 | Stage 2에서 cppcheck를 통해 펌웨어 소스코드 정적 분석을 수행해야 한다. | Should | error 등급 이상의 결함 검출 시 파이프라인이 중단되고 결함 목록이 로그에 기록되어야 한다. |
| FR-CICD-005 | Stage 3에서 빌드된 펌웨어 바이너리 크기가 App Slot 크기(128KB)를 초과하는지 검사해야 한다. | Must | 초과 시 파이프라인이 중단되고 실제 크기와 한계 크기가 로그에 기록되어야 한다. |
| FR-CICD-006 | Stage 4에서 ECDSA 개인키로 펌웨어에 서명하고 Manifest를 생성해야 한다. | Must | 서명된 펌웨어 바이너리와 Manifest 파일이 Jenkins 아티팩트로 저장되어야 한다. |
| FR-CICD-007 | Stage 5에서 OTA 배포 스크립트는 주행 중에도 다운로드를 시작할 수 있으나, 실제 펌웨어 활성화(재부팅)는 ECU가 IDLE 상태가 된 후 자동으로 수행된다. | Must | UDS over ISO-TP 절차(0x10→0x27→0x34→0x36→0x37)로 비활성 슬롯에 펌웨어 기록을 완료한다. TransferExit 후 ECU는 g_fw_pending=1을 세트하고 즉시 재부팅하지 않는다. DRIVE_IDLE 상태 진입 시 ECU가 자동 재부팅하며, Jenkins는 heartbeat(CAN 0x100) 슬롯 전환을 확인한다. (Uptane 지연 활성화, FR-DRV-008 연계) |
| FR-CICD-008 | 각 Stage의 실행 결과와 로그가 Jenkins 빌드 이력에 기록되어야 한다. | Must | 성공/실패 여부, 실패 원인, 각 Stage 소요 시간이 Jenkins UI에서 확인 가능해야 한다. |
| FR-CICD-009 | ECDSA 개인키는 Jenkins Credentials로 관리되어야 하며 Jenkinsfile에 평문 노출되지 않아야 한다. | Must | Jenkinsfile 소스코드에 키 값이 존재하지 않아야 한다. |
| FR-CICD-010 | Stage 5 OTA 배포 실패 시 Jenkins 빌드를 FAILURE로 표시하고 실패 원인을 로그에 기록해야 한다. | Must | ECU 플래시 실패, Self-test 실패, Rollback 발생 중 어느 경우에도 Jenkins 빌드 상태가 FAILURE로 기록되어야 한다. 재시도는 수동으로만 수행한다. |

---

## 8. 보안 요구사항

### 8.1 Manifest 요구사항

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

### 8.2 Firmware 검증 요구사항

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

### 8.3 공격 방어 요구사항

| ID | 공격 시나리오 | 방어 요구사항 | 수용 기준 |
|---|---|---|---|
| SR-ATK-001 | Firmware Tampering | Hash/Signature 검증 | 1바이트 변조 이미지가 거부되어야 한다. |
| SR-ATK-002 | Arbitrary Software | Signature 검증 | 개인이 임의 생성한 unsigned image가 거부되어야 한다. |
| SR-ATK-003 | Downgrade Attack | Anti-rollback | 낮은 version image가 거부되어야 한다. |
| SR-ATK-004 | ECU Mismatch | target_ecu_id 검증 | 다른 ECU용 image가 거부되어야 한다. |
| SR-ATK-005 | Replay Attack | session_id, sequence number, freshness counter | 이전 Transfer Data 재전송이 거부되어야 한다. |
| SR-ATK-006 | Unauthorized Update Start / Brute Force | Security Access, 시도 횟수 제한 | 인증되지 않은 update command가 거부되어야 하며, 연속 3회 Key 오류 시 10초간 Security Access가 잠금되어야 한다. |
| SR-ATK-007 | Endless Data Attack | image_size, chunk_count 제한 | Manifest size 초과 수신 시 세션이 종료되어야 한다. |
| SR-ATK-008 | CAN Flood / DoS | timeout, abort, rollback | 업데이트 중단 후 기존 App으로 복구되어야 한다. |
| SR-ATK-009 | Fake Complete | ECU 내부 검증 결과 기반 commit | Gateway의 fake complete 명령만으로 Confirmed 되지 않아야 한다. |
| SR-ATK-010 | Partial Bundle Installation | campaign result 추적 | 한 ECU만 업데이트 성공 시 Campaign 상태가 partial/fail로 기록되어야 한다. |

### 8.4 키 관리 요구사항

| ID | 요구사항 | 우선순위 | 수용 기준 |
|---|---|---:|---|
| SR-KEY-001 | ECDSA 공개키는 Bootloader Flash 영역(Sector 0~4)에 하드코딩되어야 한다. | Must | 공개키가 App Slot 또는 Metadata 영역에 저장되지 않고 Bootloader 이미지 내에 포함되어야 한다. |
| SR-KEY-002 | ECDSA 개인키는 개발 PC 또는 Jenkins Credentials에만 존재해야 하며 ECU에 저장되지 않아야 한다. | Must | ECU Flash 어느 영역에도 개인키가 존재하지 않아야 한다. |
| SR-KEY-003 | Security Access에 사용하는 PreSharedKey는 Bootloader Flash 영역에 저장되어야 한다. | Must | PreSharedKey가 App Slot에 포함되지 않아야 한다. WRP가 적용된 Bootloader 영역에 위치해야 한다. |
| SR-KEY-004 | 공개키 및 PreSharedKey의 갱신은 Bootloader 재플래싱을 통해서만 가능해야 한다. | Should | ST-LINK 또는 전용 플래싱 도구를 통한 Bootloader 재기록으로만 키를 변경할 수 있어야 한다. |

---

## 9. Uptane-lite 참고 요구사항

### 9.1 적용 범위

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

### 9.2 개념 매핑

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

### 9.3 Uptane-lite 요구사항

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

---

## 10. 비기능 요구사항

### 10.1 신뢰성 요구사항

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

### 10.2 성능 요구사항

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

### 10.3 유지보수성 요구사항

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

### 10.4 안전성 요구사항

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

---

## 11. 개발 프로세스 및 요구사항 추적성 요구사항

### 11.1 적용 원칙

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

### 11.2 프로세스 요구사항

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

### 11.3 추적성 관리 요구사항

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

### 11.4 추적성 예시

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

---

## 12. 계측 및 디버깅 요구사항

### 12.1 적용 원칙

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

### 12.2 사용 도구 및 목적

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

### 12.3 디버깅/트러블슈팅 요구사항

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

### 12.4 트러블슈팅 리포트 형식 요구사항

TSR-001에는 각 문제에 대해 다음 항목을 포함한다.

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

### 12.5 예상 트러블슈팅 사례

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

---
## 13. 데이터 및 메시지 요구사항

### 13.1 Manifest 예시 구조

```json
{
  "manifest_version": 1,
  "campaign_id": "CAMP-2026-001",
  "target_ecu_id": "DRIVE_ECU",
  "hardware_id": "F446RE-DRIVE-V1",
  "firmware_version": 2,
  "min_allowed_version": 1,
  "image_size": 98304,
  "image_hash_alg": "SHA-256",
  "image_hash": "<hex string>",
  "signature_alg": "ECDSA-P256 or Ed25519",
  "signature": "<hex string>",
  "metadata_version": 5,
  "expires_at": "2026-12-31T23:59:59+09:00"
}
```

### 13.2 CAN ID 할당 테이블

본 프로젝트에서 사용하는 CAN ID는 11-bit Standard CAN ID 기반으로 다음과 같이 할당한다.

#### UDS 진단 메시지 (Physical Addressing)

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

#### Application 메시지

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

### 13.3 Boot Metadata 요구 필드

| 필드 | 설명 |
|---|---|
| magic | Metadata 유효성 확인용 고정 값 |
| metadata_version | Metadata 구조 버전 |
| active_slot | 현재 실행 대상 Slot |
| confirmed_slot | 마지막으로 정상 확인된 Slot |
| pending_slot | 다음 부팅에서 검증할 후보 Slot |
| slot_a_version | Slot A 펌웨어 버전 |
| slot_b_version | Slot B 펌웨어 버전 |
| slot_a_status | Slot A 상태 (INVALID/UPDATING/UPDATED/TRIAL/CONFIRMED, §7.3.1) |
| slot_b_status | Slot B 상태 (INVALID/UPDATING/UPDATED/TRIAL/CONFIRMED, §7.3.1) |
| boot_attempt_count | 후보 Slot 부팅 시도 횟수 |
| last_error | 마지막 업데이트/부팅 실패 원인 |
| metadata_crc | Metadata 손상 검출용 CRC32 |
| seq_counter | 이중화 사본 중 최신본 식별용 monotonic 카운터 |

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

### 13.4 UDS-style 명령 요구사항

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

### 13.5 주요 Negative Response Code 예시

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

### 13.6 Security Access 파라미터

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

---

## 14. Flash Partition 요구사항

### 14.1 기본 원칙

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

### 14.2 확정 파티션 레이아웃

STM32F446RE Linker Script 및 실제 구현 기준으로 확정된 파티션.

```text
주소          영역                크기    섹터
0x08000000  Bootloader Area     32KB    섹터 0 (16KB) + 섹터 1 (16KB)
0x08008000  Metadata Copy A     16KB    섹터 2
0x0800C000  Metadata Copy B     16KB    섹터 3
0x08010000  Slot A Application  192KB   섹터 4 (64KB) + 섹터 5 (128KB)
0x08040000  Slot B Application  256KB   섹터 6 (128KB) + 섹터 7 (128KB)
```

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

### 14.3 파티션 관련 요구사항

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

---

## 15. 테스트 요구사항

### 15.1 정상 기능 테스트 (SWE.6 — 시스템 수준)

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

### 15.2 실패 복구 테스트 (SWE.6 — 시스템 수준)

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

### 15.3 보안 공격 테스트 (SWE.6 — 시스템 수준)

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

### 15.4 개발 프로세스 및 디버깅 검증 (SWE.4/SWE.5 — 단위/통합 수준)

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

### 15.5 CI/CD 파이프라인 테스트 (SWE.5 — 통합 수준)

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

---

## 16. 요구사항 추적성 매트릭스

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

---

## 17. 산출물 요구사항

본 프로젝트의 산출물은 제출 산출물과 엔지니어링 문서 산출물로 구분한다.

### 17.1 제출 산출물

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

### 17.3 필수 엔지니어링 문서 산출물 7종

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

### 17.4 선택 엔지니어링 문서 산출물

필수 7종 외에도 프로젝트 완성도를 높이기 위해 다음 문서는 선택적으로 작성할 수 있다.

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

### 17.5 필수 문서 간 추적 관계

필수 문서 7종은 다음 관계를 가져야 한다.

```text
SRS-001  (SWE.1)
  ↓ 요구사항 ID → 컴포넌트 할당
SAD-001  (SWE.2)
  ↓ 아키텍처 컴포넌트 → 상세 설계
SDD-001  (SWE.3)
  ↓ 함수/모듈/프로토콜 명세 → 구현
  ↕ 요구사항-설계-구현-테스트 양방향 연결
RTM-001
  ↓ 테스트 케이스 연결
TP-001   (SWE.5/6)
  ↓ 테스트 케이스 실행
TR-001   (SWE.5/6)
  ↓ 실패/비정상 현상 발생 시
TSR-001  (SUP.9)
  ↓ 원인 분석 및 재발 방지 → SRS/SAD/SDD/RTM 반영
```

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

---

## 18. 성공 기준

본 프로젝트는 다음 조건을 만족하면 1차 성공으로 판단한다.

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

---

## 19. 한계 및 명시적 인정 사항

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

1. STM32F446RE는 실제 차량용 HSM MCU가 아니므로 양산 ECU 수준의 키 보호와 Secure Boot ROM을 제공하지 않는다.
2. F446RE는 하드웨어 Dual Bank Flash 구조가 아니므로, 단일 Flash를 논리적으로 분할한 A/B Slot 구조를 사용한다.
3. UDS는 정식 상용 UDS 스택 전체 구현이 아니라, 리프로그래밍 절차를 참고한 UDS-style 구조이다.
4. Uptane은 전체 표준 구현이 아니라, Manifest, ECU Inventory, Version Report, Rollback 방어, Partial Bundle 방어 개념을 참고한 Uptane-lite 구조이다.
5. Delta Update는 1차 구현 범위에서 제외하고, Full Image 기반 A/B Secure OTA에 집중한다.
6. ASPICE는 공식 준수 또는 평가가 아니라, 요구사항 기반 개발과 추적성 개념을 참고한 수준으로 적용한다.
7. 공격자 시나리오는 자체 제작한 CAN 테스트 네트워크 내부에서만 수행한다.
8. 실제 차량의 IGN 상태, 배터리 전압 조건, DTC, 네트워크 슬립/웨이크업, 서비스센터 복구 정책은 1차 범위에서 제외한다.
9. **직진 주행이 보장되지 않는다.** 실제 테스트 시 매 실행마다 진행 방향이 달라지는 현상이 확인된다 (고정된 편향이 아니라 실행마다 방향이 좌·우 불규칙하게 변함). 원인은 미파악 상태이며, 모터 PWM 초기 타이밍 불일치, 기구적 요인, 또는 소프트웨어 로직 요인 중 하나 또는 복합 원인으로 추정된다. 추후 원인 분석 및 해결이 필요하다.

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

---

## 20. 향후 확장 방향

1차 구현 이후 다음 확장을 고려할 수 있다.

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

---

## 21. 개발 일정

### 21.1 전체 일정 요약

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

### 21.2 주차별 상세 일정

#### 1주차: 개발 환경 + Bootloader (2026-05-16 ~ 2026-05-22)

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

#### 2주차: OTA 파이프라인 + Secure OTA (2026-05-23 ~ 2026-05-29)

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

#### 3주차: App 구현 + 통합 + 문서화 (2026-05-30 ~ 2026-06-06)

| 날짜 | 작업 내용 | 산출물 |
|---|---|---|
| 05/30 ~ 05/31 | Drive ECU App v1(즉시 정지) + App v2(자동 후진 복귀) 구현, 장애물 임계값 10cm 고정 (FR-DRV-001~008, FR-SEN-002~004) | v1/v2 버튼 트리거 주행 및 장애물 반응 동작 확인 |
| 06/01 | OTA로 App v1→v2 순차 배포 및 장애물 반응 차이 실증, Uptane 지연 활성화 확인 (FR-DRV-007, FR-DRV-008) | TC-NOR-005~006 PASS |
| 06/02 ~ 06/03 | 보안 공격 시나리오 테스트 10종 수행 (SR-ATK-001~010) | TC-SEC-001~010 PASS |
| 06/04 | Jenkins Stage 4~5 완성 (서명 자동화 + OTA 자동 배포) (FR-CICD-006~009) | TC-CICD-001~003 PASS |
| 06/05 ~ 06/06 | 필수 문서 7종 완성 (SAD, SDD, RTM, TP, TR, TSR) + 최종 검토 | 필수 문서 7종 완료 |

### 21.3 마일스톤 요약

| 마일스톤 ID | 날짜 | 내용 |
|---|---|---|
| MS-001 | 2026-05-22 | Bootloader에서 App jump 성공, Jenkins 빌드 파이프라인 동작 |
| MS-002 | 2026-05-29 | 전체 OTA 흐름 성공 (SHA-256/ECDSA 검증 포함), Rollback 동작 확인 |
| MS-003 | 2026-06-01 | App v1/v2 OTA 실증 완료 (버튼 트리거 주행 + 장애물 반응 단계별 차이 확인, Uptane 지연 활성화 확인) |
| MS-004 | 2026-06-04 | 보안 공격 시나리오 10종 통과, Jenkins 전체 파이프라인 완성 |
| MS-005 | 2026-06-06 | 필수 문서 7종 완성, 프로젝트 1차 완료 |

---

## 22. 용어 정의

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

---

## 23. 개정 이력

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
