JaehyeongIm/automotive-secure-ota-ecu/docs/assets/구현계획.md

# 구현 계획

## 구현 현황 요약

| 컴포넌트 | 상태 | 비고 |
|---|---|---|
| Phase 1 — CAN 통신 기초 | ✅ 완료 | 양방향 통신, CANable 모니터링 검증 |
| Phase 2 — CAN 메시지 구조 | ✅ 완료 | 0x100(DriveECU), 0x201(SensorECU) 송수신 |
| Phase 3 — Bootloader | ✅ 완료 | Slot A/B 선택, IWDG 시작, App jump |
| Phase 4 — UDS/ISO-TP/OTA (DriveECU) | ✅ 완료 | A/B OTA 완료 (ECU가 비활성 슬롯 자동 선택) |
| Phase 5 — RPi5 게이트웨이 + ECDSA 서명 파이프라인 | ✅ 완료 | SocketCAN(can0) OTA 성공, ECDSA 서명 검증 OK |
| Phase 6 — SensorECU OTA 완성 | ✅ 완료 | HC-SR04, 0x200 메시지, UDS/ISO-TP OTA |
| Phase 7 — Jenkins CI/CD | ✅ 완료 | Git push → 빌드 → 서명 → OTA 자동화 |
| Phase 8 — CI/CD 파이프라인 통합 테스트 | 🔄 진행 중 | OTA 버그 수정, 안정성 확보 |
| Phase 9 — RC카 + Drive ECU 앱 구현 | ✅ 완료 | 버튼 트리거 직진, App v1/v2/v3 구현 완료 |
| Phase 10 — 예외 시나리오 + 단위 테스트 | ❌ 미완료 | 실패 복구, 보안 공격, OTA 단위 테스트 |
| Phase 11 — 통합 테스트 + 시연 영상 | ❌ 미완료 | 전체 E2E 검증, 시연 영상 촬영 |

---

## 컴포넌트별 현재 구현 상태

### Bootloader (`Bootloader/Core/Src/bootloader.c`)

| 기능 | 상태 |
|---|---|
| Slot A/B Metadata 기반 선택 | ✅ |
| Stack Pointer 유효성 검사 후 App jump | ✅ |
| IWDG 시작 (App 8초 내 kick 필요) | ✅ |
| ECDSA-P256 서명 검증 (micro-ecc + SHA-256) | ✅ |
| boot_count 기반 롤백 | ❌ (필드는 있으나 미사용) |
| WRP(Write Protection) 설정 | ❌ |

### DriveECU (`DriveECU/Core/Src/`)

| 기능 | 상태 |
|---|---|
| CAN 0x100 상태 메시지 200ms 송신 | ✅ |
| ISO-TP SF/FF/CF/FC 수신 처리 | ✅ |
| UDS 0x10/0x27/0x34/0x36/0x37 | ✅ |
| Flash Slot A/B erase/write | ✅ |
| ECU 자동 비활성 슬롯 선택 (ota_get_active_slot) | ✅ |
| Metadata A/B 대칭 PENDING 기록 및 리셋 | ✅ |
| Bootloader에서 점프 후 VTOR 재설정 | ✅ |
| B1 버튼 트리거 직진 주행 (EXTI PC13) | ✅ |
| TB6612FNG 모터 PWM 제어 | ✅ |
| App v1 (즉시 정지 장애물 반응) | ✅ |
| App v2 (비례 감속 + 정지) | ✅ |
| App v3 (비례 감속 + 정지 + 자동 후진 복귀) | ✅ |
| 0x200 수신 후 장애물 반응 로직 | ✅ |

### SensorECU (`SensorECU/Core/Src/`)

| 기능 | 상태 |
|---|---|
| CAN 0x201 Heartbeat 100ms 송신 | ✅ |
| HC-SR04 거리 측정 | ✅ |
| CAN 0x200 장애물 감지 메시지 | ✅ |
| ISO-TP + UDS OTA 수신 | ✅ |
| Flash Slot A/B erase/write | ✅ |

### RPi5 / Gateway (`tools/`)

| 기능 | 상태 |
|---|---|
| RPi5 SocketCAN(can0)을 통한 UDS OTA 전송 (`ota_client.py`) | ✅ |
| ECDSA 서명 바이너리 생성 (`sign_firmware.py`) | ✅ |
| Jenkins CI/CD 파이프라인 (빌드/서명/OTA 자동화) | ✅ |
| ECU Inventory 수집 (0x22 RDBI) | ❌ |
| Campaign 단위 결과 관리 | ❌ |

---

## Phase 1 — CAN 버스 통신 검증 ✅ 완료

**목표:** STM32 두 보드가 CAN으로 실제 통신하는 것 확인

- STM32CubeIDE 프로젝트 생성 (F446RE ×2, DriveECU / SensorECU)
- 하드웨어 연결

```
STM32 #1 --- SN65HVD230 ---[120Ω]--- SN65HVD230 --- STM32 #2
                               |
                           CANable --- PC (USB)
```

- CAN 핀: PA11 (CAN1_RX), PA12 (CAN1_TX)
- 버스 양 끝단에 120Ω 종단저항 각 1개
- PC 측 툴 설치

### 하드웨어 배선 절차

**각 Nucleo → SN65HVD230 연결 (×2)**

| Nucleo 핀 | SN65HVD230 핀 | 비고 |
|---|---|---|
| PA12 (CAN1_TX) | CTX | 데이터 송신 |
| PA11 (CAN1_RX) | CRX | 데이터 수신 |
| 3.3V | VCC | 트랜시버 전원 |
| GND | GND | 공통 그라운드 |

**CAN 버스 (브레드보드)**

```
DriveECU                         SensorECU
SN65HVD230                       SN65HVD230
  CANH ─┬────────────────────────┬─ CANH
  CANL ─┼────────────────────────┼─ CANL
        │                        │
       [120Ω]              [120Ω]  ← 버스 양 끝단 종단저항
        │                        │
       GND                      GND
```

**CANable 연결**

| CANable 단자 | 연결 대상 |
|---|---|
| CANH | 버스 CANH 라인 |
| CANL | 버스 CANL 라인 |
| GND | 공통 GND |
| USB | PC |

**GND 공통 연결 필수**
- DriveECU GND, SensorECU GND, CANable GND 모두 브레드보드 GND 레일에 연결

**전원 인가 순서**
1. USB → DriveECU, SensorECU (PC 연결)
2. CANable USB → PC

**정상 동작 확인**
- 두 보드 모두 LD2(녹색) 깜빡임 → CAN 메시지 송신 중
- 각 보드 UART 터미널에 상대방 ID 수신 로그 출력

```bash
pip install python-can   # CANable → slcan 인터페이스로 인식
```

- CAN Loopback 테스트 (단일 보드 자가 송수신) → 두 노드 양방향 통신 테스트 → CANable PC 모니터링
- 오실로스코프로 CAN_H/CAN_L 파형 확인 (500Kbps 검증)

---

## Phase 2 — CAN 메시지 구조 구현 ✅ 완료

**목표:** SRS Section 13.2 CAN ID 테이블대로 메시지 송수신

| 보드 | 역할 | 구현 내용 |
|---|---|---|
| STM32 #1 | Drive ECU | 0x100 Status 메시지 200ms 주기 송신 |
| STM32 #2 | Sensor ECU | 0x201 Heartbeat 100ms 주기 송신 |
| PC (Python) | 임시 Gateway | 수신 파싱 + UDS 명령 송신 |

---

## Phase 3 — Bootloader 구현 ✅ 완료

**목표:** 전원 인가 시 유효한 Slot을 선택해 점프하는 Bootloader

- Flash 레이아웃 설계 (F446RE 512KB 기준)

```
주소          영역                크기   섹터
0x08000000  Bootloader Area     32KB   섹터 0(16KB) + 섹터 1(16KB)
0x08008000  Metadata Area       16KB   섹터 2
0x0800C000  Reserved            16KB   섹터 3
0x08010000  Slot A Application  192KB  섹터 4(64KB) + 섹터 5(128KB)
0x08040000  Slot B Application  256KB  섹터 6(128KB) + 섹터 7(128KB)
```

- Metadata 구조체: magic, active_slot, slot_a/b_status, slot_a/b_version, boot_count, slot_a_size, slot_b_size
- 부팅 로직: Metadata 확인 → CONFIRMED/PENDING Slot 선택 → Stack Pointer 유효성 검사 → ECDSA-P256 서명 검증 → App jump
- IWDG 시작 (Prescaler 256, Reload 999 → 약 8초): App이 kick하지 않으면 리셋
- 검증 실패 시 Safe State (UART 출력 + IWDG kick 루프)

**미구현 사항:**
- boot_count 3회 초과 시 반대 Slot 폴백
- WRP(Write Protection) Sector 0~1 활성화

---

## Phase 4 — UDS + ISO-TP + OTA 프로토콜 (DriveECU) ✅ 완료

**목표:** A/B OTA — ECU가 비활성 슬롯을 자동 선택하여 펌웨어 업데이트

- ISO-TP 구현 (STM32 측 수신 처리)
  - Single Frame / First Frame / Consecutive Frame / Flow Control
  - STmin=0, BlockSize=0, N_Bs=1000ms
- UDS 서비스 구현 (DriveECU)
  - `0x10` DiagnosticSessionControl
  - `0x27` SecurityAccess (Seed XOR 0xDEADBEEF)
  - `0x34` RequestDownload — addr=0: ECU가 `ota_get_active_slot()`으로 비활성 슬롯 자동 선택
  - `0x36` TransferData (256 byte 청크)
  - `0x37` RequestTransferExit → `ota_meta_write_pending(slot, fw_size)` → NVIC_SystemReset
- OTA 클라이언트 (`tools/ota_client.py`) — Slot 주소 하드코딩 제거, ECU 자동 선택 위임
- E2E 테스트 완료: RPi5(can0) → DriveECU A/B OTA → ECDSA OK → 신규 슬롯 부팅

**A/B 슬롯 동작 원리:**
```
active_slot=0(A) → OTA 타겟=Slot B → firmware_slotb.bin(0x08040000 링크)
active_slot=1(B) → OTA 타겟=Slot A → firmware_slota.bin(0x08010000 링크)
```
클라이언트는 항상 동일한 명령 전송, 타겟 슬롯 결정은 ECU 책임.

**트러블슈팅 기록:**
- VTOR 하드코딩 문제 → `g_pfnVectors` 링커 심볼로 해결 (`main.c` USER CODE BEGIN 1)
- python-can slcan DLC 파싱 버그 → `.venv/.../slcan.py` line 282 패치
- ARM inline asm `-mthumb` 호환 문제 → `uECC_PLATFORM=0`으로 순수 C 강제
- 상세 내용: `docs/troubleshooting/ISS-BL-001_can-irq-after-bootloader.md`

---

## Phase 5 — RPi5 게이트웨이 + ECDSA 서명 파이프라인 ✅ 완료

**목표:** RPi5가 SocketCAN을 통해 게이트웨이로 동작하고, 서명된 펌웨어만 Bootloader가 수락

### RPi5 기초 설정

1. Raspberry Pi OS 64-bit 설치 + SSH 설정 (개발 PC와 동일 LAN)
2. CANable USB 연결 및 SocketCAN 인터페이스 활성화

```bash
sudo apt install can-utils
sudo ip link set can0 up type can bitrate 500000
ip link show can0  # 확인
candump can0       # CAN 프레임 모니터링
```

3. Python 환경 구성

```bash
python3 -m venv .venv
source .venv/bin/activate
pip install python-can cryptography
```

4. `tools/ota_client.py` + `tools/sign_firmware.py` RPi5로 복사
5. slcan 대신 `--interface socketcan --channel can0` 옵션으로 실행 (slcan DLC 패치 불필요)

**검증 완료:** RPi5(can0) → DriveECU A/B OTA 성공, ECDSA OK 확인

### 구현된 서명 포맷 (Appended Signature)

SRS 13.1의 manifest.json 방식 대신, 바이너리 말미에 서명을 직접 붙이는 방식으로 구현:

```
┌───────────────────────────────┐
│  firmware binary  (N bytes)   │  ← SHA-256 해시 대상
├───────────────────────────────┤
│  ECDSA-P256 sig   (64 bytes)  │  ← r(32) || s(32), big-endian
└───────────────────────────────┘
         총 (N + 64) bytes
```

Metadata의 `slot_*_size` = 총 바이너리 크기(N + 64), Bootloader가 마지막 64바이트를 서명으로 인식.

### 키 생성 (개발 PC에서 1회)

```bash
openssl ecparam -name prime256v1 -genkey -out keys/private_key.pem
# 공개키는 tools/sign_firmware.py 실행 시 자동 출력되는 C 배열을
# Bootloader/Core/Inc/ecdsa_pubkey.h 에 복사
```

- `keys/private_key.pem`: Git 커밋 금지 (`.gitignore` 등록), Jenkins Credentials에만 보관
- `ecdsa_pubkey.h`: Bootloader 이미지에 하드코딩 (공개키이므로 노출 무방)

### Bootloader ECDSA 검증 (`bootloader.c`, 구현 완료)

- micro-ecc 라이브러리 (secp256r1, `uECC_PLATFORM=0` 순수 C)
- SHA-256 라이브러리 (`Bootloader/Core/Lib/sha256.c`)
- 검증 흐름:
  1. `slot_*_size`(N+64)에서 N = `fw_total - 64` 계산
  2. Flash[boot_addr .. boot_addr+N-1] 구간 SHA-256 해시
  3. Flash[boot_addr+N .. boot_addr+N+63] 를 서명으로 `uECC_verify()` 호출
  4. 실패 시 `safe_state()` 진입
- `size==0` 또는 `size > slot_max`: ST-Link 직접 플래싱 호환을 위해 검증 건너뜀

**검증 완료 (UART 로그):**
```
[BL] ECDSA OK
[DriveECU v2] Start
```

**트러블슈팅 기록:**
- RPi5 OTA 중단 후 Bootloader Safe State 진입: `docs/troubleshooting/ISS-BL-002_fallback-pending-invalid.md`
- Slot B 부팅 후 CAN 통신 불통 (ISS-CAN-003): `docs/troubleshooting/ISS-CAN-003_slot-b-can-failure.md`

---

## Phase 6 — SensorECU OTA 완성 ✅ 완료

**목표:** HC-SR04 장애물 감지 메시지 송신 + UDS/ISO-TP OTA 수신

### HC-SR04 거리 측정

| 핀 | SensorECU 핀 | 비고 |
|---|---|---|
| Trigger | GPIO Output | 10us pulse |
| Echo | TIM InputCapture | 펄스 폭 측정 |

- 측정 거리(cm) = Echo 펄스 폭(us) / 58
- 10cm 이하 감지 시 0x200 CAN 메시지 송신

**0x200 CAN 메시지 페이로드:**

| Byte | 내용 |
|---|---|
| 0 | obstacle_detected (0x01=감지, 0x00=없음) |
| 1 | distance_cm |
| 2~3 | 예약 |

### SensorECU OTA 구현

DriveECU 구현을 포팅 (CAN ID만 교체):

| 항목 | DriveECU | SensorECU |
|---|---|---|
| UDS Request CAN ID | 0x7E0 | 0x7E1 |
| UDS Response CAN ID | 0x7E8 | 0x7E9 |
| Slot A 주소 | 0x08010000 | 0x08010000 (동일) |
| Slot B 주소 | 0x08040000 | 0x08040000 (동일) |

- `isotp.c`, `uds.c`, `ota_flash.c` SensorECU 프로젝트에 추가
- Linker Script: DriveECU와 동일 구조 사용
- Bootloader: 동일 바이너리 재사용 가능

---

## Phase 7 — Jenkins CI/CD 파이프라인 ✅ 완료

**목표:** Git push → 빌드 → 서명 → OTA 자동화 (SRS FR-CICD-001~009)

### 구현 내용

- RPi5에 Jenkins 직접 설치 (Docker 미사용)
- arm-none-eabi-gcc 크로스컴파일 환경 구성
- `Jenkinsfile` 4단계 파이프라인:
  1. 변경된 ECU 감지 (git diff)
  2. 빌드 (`ci/build.sh`: make clean + make all)
  3. ECDSA 서명 (`tools/sign_firmware.py`)
  4. OTA 배포 (`tools/ota_client.py --cf-delay 0.005`)
- 슬롯 전환 확인: `ci/read_slot.py`로 OTA 완료 후 활성 슬롯 검증
- Jenkins Credentials에 ECDSA 개인키 Secret File로 등록
- GitHub Push 트리거 (`githubPush()`)

---

## Phase 8 — CI/CD 파이프라인 통합 테스트 🔄 진행 중

**목표:** Jenkins 파이프라인의 안정적 동작 확인, 알려진 OTA 버그 수정

### 진행 중인 작업

| 항목 | 상태 | 참고 |
|---|---|---|
| CF 간격 최적값 확인 (ISS-OTA-004) | 🔄 0.005s 유효 확인, TX_FAIL 진단 중 | `ISS-OTA-004_sensor-ota-random-timeout.md` |
| OTA 실패 후 반복 하트비트 없음 수정 (ISS-OTA-005) | ❌ 미수정 | `ISS-OTA-005_no-heartbeat-after-failed-ota.md` |
| ISS-OTA-005 수정: RequestDownload에서 슬롯 소거 전 메타데이터 INVALID 기록 | ❌ | `SensorECU/Core/Src/uds.c` |
| 진단 코드 정리 (g_isotp_tx_fail_count, TX_FAIL_DURING_OTA) | ❌ CF 간격 확인 후 제거 예정 | |
| Jenkinsfile SENSOR_CHANGED 조건 복원 | ❌ 현재 'true' 하드코딩 | |

### 알려진 버그

**ISS-OTA-004: SensorECU OTA 랜덤 타임아웃**
- 원인: ISO-TP CF 전송 간격이 짧으면 CAN TX 메일박스 포화 → OTA 실패
- 현황: CF 간격 0.005s에서 안정적 동작 확인. 원인 재분석 중.
- 참고: `docs/troubleshooting/ISS-OTA-004_sensor-ota-random-timeout.md`

**ISS-OTA-005: OTA 실패 후 반복적 하트비트 없음**
- 원인: 플래시 소거와 메타데이터 무효화가 원자적이지 않음. OTA 실패 후 소거된 슬롯이 CONFIRMED로 잘못 기록되어, 반복 OTA 실패 시 양쪽 슬롯 모두 소거 → safe_state()
- 수정 방향: `RequestDownload`에서 슬롯 소거 전에 대상 슬롯을 INVALID로 메타데이터에 기록
- 임시 복구: STM32CubeProgrammer로 메타데이터 섹터(0x08008000) 소거 후 SlotA 재플래싱
- 참고: `docs/troubleshooting/ISS-OTA-005_no-heartbeat-after-failed-ota.md`

### Phase 8 완료 기준

- [ ] ISS-OTA-005 수정 및 검증 (연속 OTA 5회 이상 실패/성공 반복 후 safe_state 없음)
- [ ] 진단 코드 제거
- [ ] Jenkinsfile SENSOR_CHANGED 조건 복원
- [ ] 파이프라인 연속 3회 성공 확인

---

## Phase 9 — RC카 + Drive ECU 앱 구현 ✅ 완료

**목표:** 버튼 트리거 직진 주행 + App v1/v2/v3 구현 (SRS FR-DRV-001~005)

### 하드웨어 배선

**TB6612FNG 모터 드라이버 (DriveECU)**

| DriveECU 핀 | TB6612FNG 핀 | 비고 |
|---|---|---|
| TIM (PWM A) | PWMA | 좌측 모터 속도 |
| TIM (PWM B) | PWMB | 우측 모터 속도 |
| GPIO | AIN1/AIN2 | 좌측 모터 방향 |
| GPIO | BIN1/BIN2 | 우측 모터 방향 |
| 3.3V | STBY | Standby 해제 |
| VM | 모터 전원 (배터리) | |

**B1 버튼 (USER button)**

| 핀 | 용도 |
|---|---|
| PC13 (EXTI) | 주행 트리거 입력 |

버튼 누름 → DRIVE_RUN 진입 → 직진 → 장애물 반응 또는 3000ms 경과 → DRIVE_IDLE 복귀

### Drive ECU App v1 — 즉시 정지 (FR-DRV-003)

- B1 버튼 누름 → 직진 시작 (BASE_SPEED)
- 0x200 수신 + distance_cm ≤ 10 → 즉시 모터 정지 → DRIVE_IDLE
- 3000ms 경과 시 자동 DRIVE_IDLE 복귀
- OTA 세션 진입 시 PWM 출력 차단 (NFR-SAFE-001)

### Drive ECU App v2 — 비례 감속 + 정지 (FR-DRV-004)

- 30cm ≥ distance_cm > 10: `PWM = BASE_SPEED(600) ~ SLOW_SPEED(300)` 비례 감속
- distance_cm ≤ 10: 즉시 정지 → DRIVE_IDLE
- OTA 다운로드 완료 후 DRIVE_IDLE 진입 시 자동 재부팅 (FR-DRV-007)

### Drive ECU App v3 — 비례 감속 + 정지 + 자동 후진 복귀 (FR-DRV-005)

- v2 감속 로직 동일
- distance_cm ≤ 10 정지 → 300ms 대기 → 600ms 후진(SLOW_SPEED) → DRIVE_IDLE 복귀

**0x100 CAN 메시지 페이로드 업데이트:**

| Byte | 내용 |
|---|---|
| 0 | app_version (1, 2, 또는 3) |
| 1 | active_slot (0=A, 1=B) |
| 2 | driving_state (0=IDLE, 1=RUN) |
| 3 | obstacle_flag (0x200 수신 여부) |
| 4~7 | tx_count (기존 유지) |

---

## Phase 10 — 예외 시나리오 + 단위 테스트 ❌ 미완료

**목표:** OTA 실패 복구 시나리오 검증, 보안 공격 테스트, 단위 테스트 커버리지 확보

### 실패 복구 테스트

| TC ID | 내용 | 기대 결과 |
|---|---|---|
| TC-FAIL-001 | OTA 전송 중 전원 차단 | 재부팅 후 기존 Confirmed Slot 부팅 |
| TC-FAIL-002 | TransferData Sequence 누락 | Request Sequence Error NRC 응답 |
| TC-FAIL-003 | 통신 중단 후 N_Bs Timeout | Abort 후 기존 App 유지 |
| TC-FAIL-004 | RequestDownload 후 리셋 (ISS-OTA-005 수정 검증) | 소거된 슬롯 INVALID 처리, 반대 슬롯 정상 부팅 |

### 보안 공격 테스트

| TC ID | 공격 시나리오 | 기대 결과 |
|---|---|---|
| TC-SEC-001 | .bin 1바이트 변조 후 OTA | ECDSA 검증 실패 → Safe State |
| TC-SEC-002 | 서명 없는 펌웨어 설치 시도 | Signature failure → 거부 |
| TC-SEC-003 | 낮은 버전 펌웨어 전송 | Anti-rollback → 거부 |
| TC-SEC-006 | Security Access 없이 0x34 요청 | Security Access Denied NRC |
| TC-SEC-008 | CAN Flood 중 OTA | Timeout/Abort 후 기존 App 유지 |

### 단위 테스트

| 대상 | 테스트 내용 |
|---|---|
| `ota_flash.c` | 메타데이터 읽기/쓰기, INVALID 기록 순서 |
| `uds.c` | NRC 응답 코드, 시퀀스 오류 처리 |
| `bootloader.c` | Slot 선택 로직, is_valid_app 경계 조건 |

---

## Phase 11 — 통합 테스트 + 시연 영상 ❌ 미완료

**목표:** SRS Section 15 테스트 케이스 전체 실행 및 시연 영상 촬영

### 정상 기능 테스트

| TC ID | 내용 | 기대 결과 |
|---|---|---|
| TC-NOR-003 | RPi5 → DriveECU + SensorECU 전체 OTA Campaign | 두 ECU 모두 새 Slot 설치 완료 |
| TC-NOR-005 | Drive ECU App v1: B1 버튼 → 직진 → 10cm 장애물 즉시 정지 | 버튼 후 주행 시작, 10cm 이하 즉시 정지 |
| TC-NOR-006 | App v2 OTA 후: 30cm 감속 + 10cm 정지 비례제어 확인 | v1 대비 감속 구간 동작 확인 |
| TC-NOR-007 | App v3 OTA 후: 감속 + 정지 + 자동 후진 복귀 | 정지 후 300ms 대기 → 600ms 후진 → IDLE |

### 시연 영상 촬영

- App v1 → v2 → v3 OTA 전환 및 장애물 반응 변화 비교
- 변조 펌웨어 거부 로그 화면 (TC-SEC-001)
- 전원 차단 복구 시퀀스 (TC-FAIL-001)
- Jenkins 파이프라인 자동 실행 화면

---

## 진행 순서

```
[완료] Phase 1~9: CAN, Bootloader, OTA, ECDSA, SensorECU, Jenkins, RC카+앱
  → Phase 8 (CI/CD 파이프라인 통합 테스트)  ← 현재 (Phase 9와 병행)
    - ISS-OTA-005 수정
    - 진단 코드 정리
    - Jenkinsfile 복원
  → Phase 10 (예외 시나리오 + 단위 테스트)
  → Phase 11 (통합 테스트 + 시연 영상)
```

**미구현 이슈 (Phase 8 수정 필요):**
- ISS-OTA-005: RequestDownload에서 슬롯 소거 전 INVALID 기록 누락 (`SensorECU/Core/Src/uds.c`)
