JaehyeongIm/automotive-secure-ota-ecu/docs/assets/photos/오실로스코프.JPG

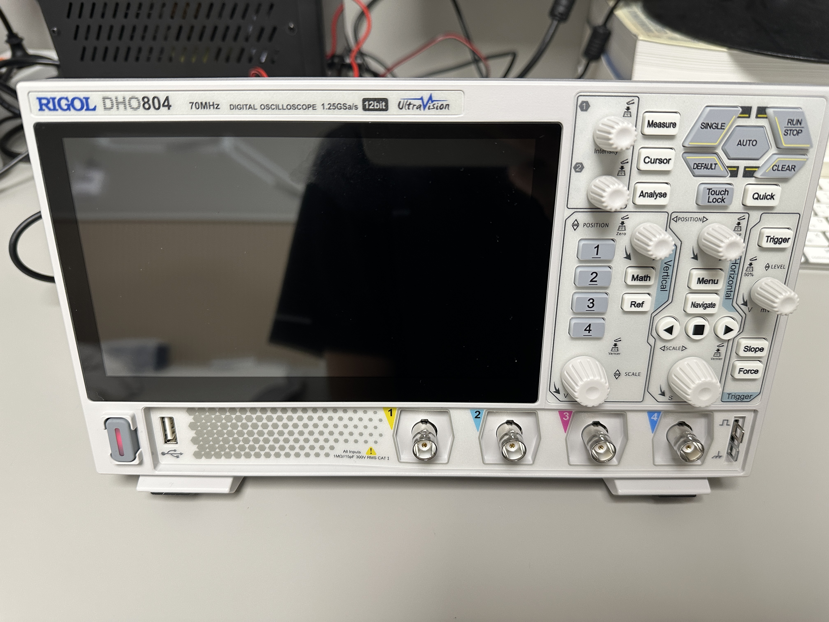
docs/assets/photos/오실로스코프.JPG
