JaehyeongIm/automotive-secure-ota-ecu/docs/assets/photos/측면사진2.JPG

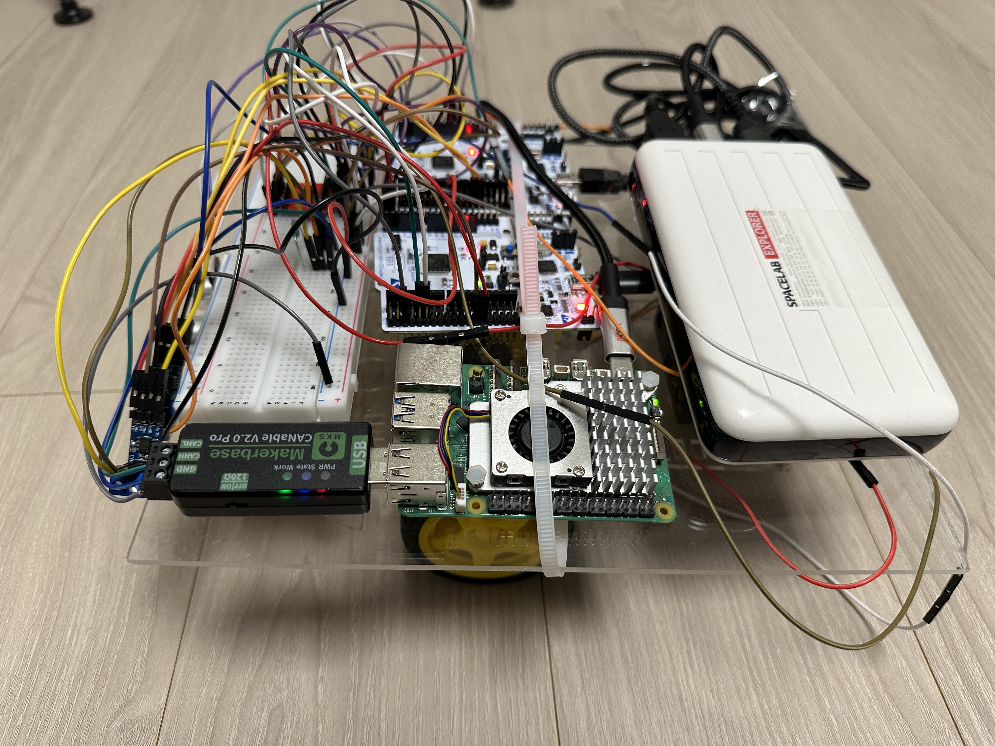
docs/assets/photos/측면사진2.JPG
