JaehyeongIm/automotive-secure-ota-ecu/docs/assets/photos/측면사진.JPG

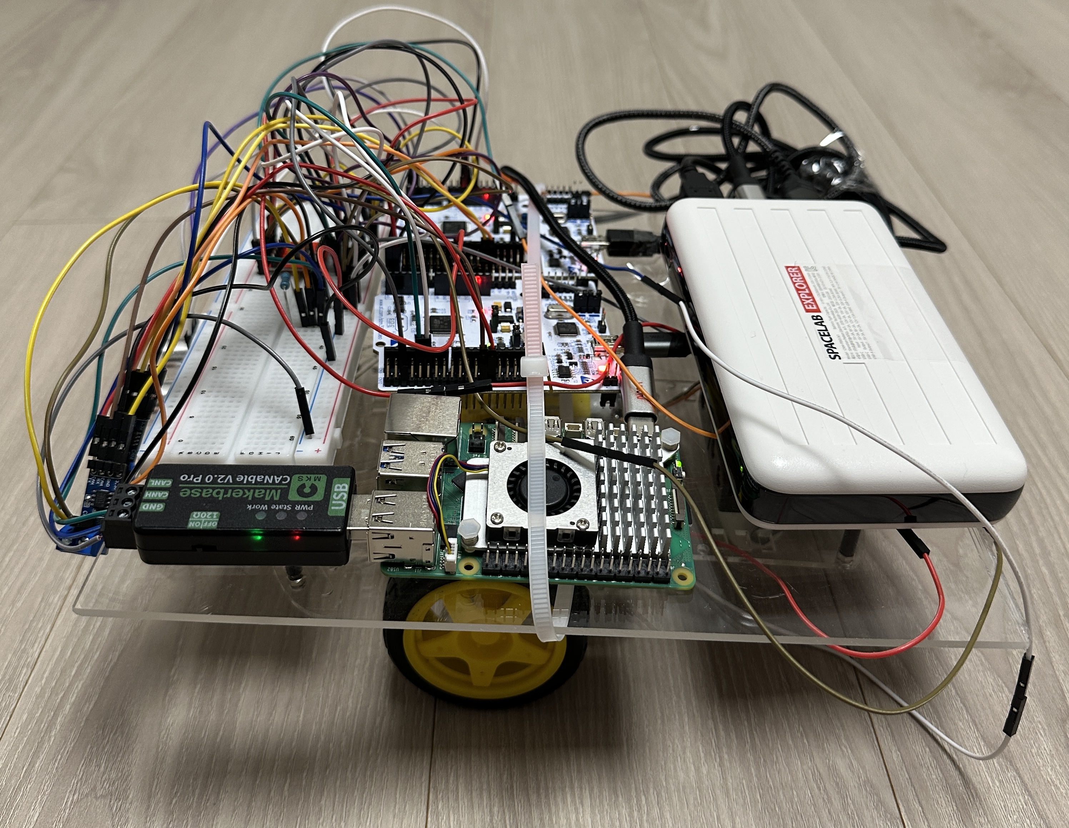
docs/assets/photos/측면사진.JPG
