JaehyeongIm/automotive-secure-ota-ecu/docs/assets/pinmap.png

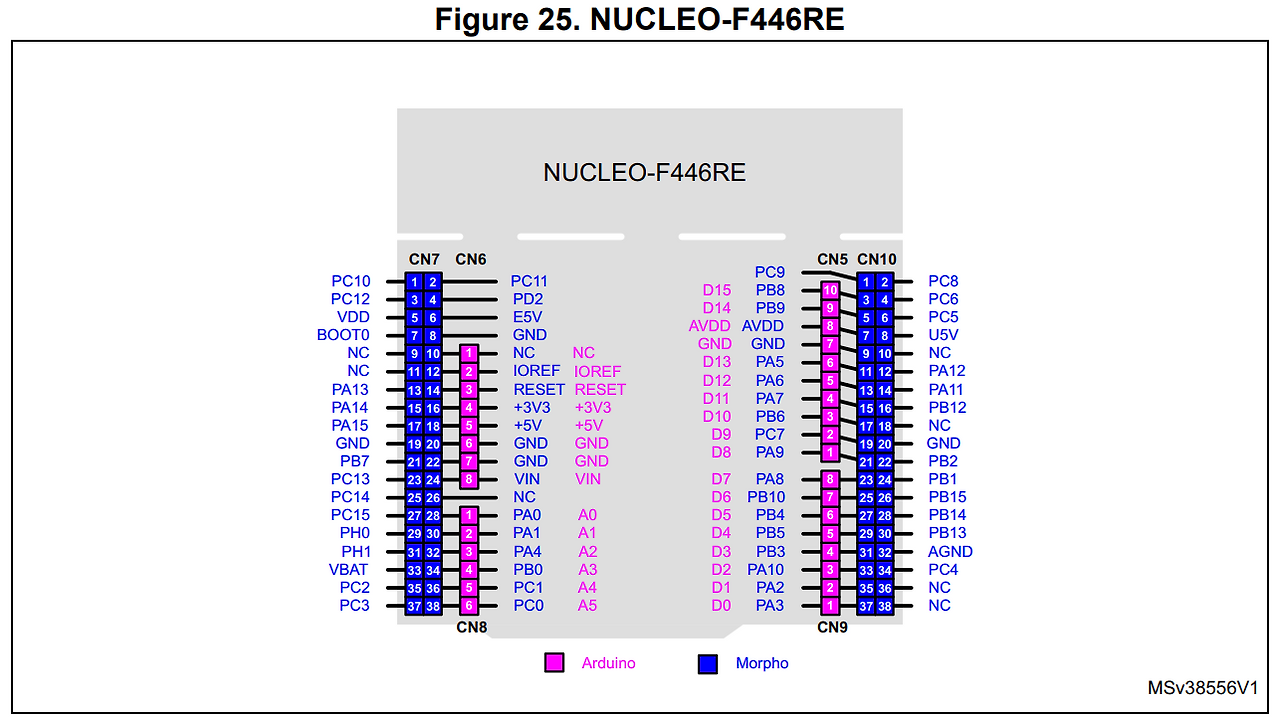
docs/assets/pinmap.png
