JaehyeongIm/automotive-secure-ota-ecu/docs/assets/부품구매목록.xlsx

전자부품 구매 목록 — BTM-ECU 프로젝트
구매처 | 디바이스마트 (일부 외부구매)
작성일 | 2026-04-16
작성자 | 임재형
분류 | Hardware / BOM
구매차수 | 번호 | 품명 | 규격·모델 | 수량 | 단가(원) | 금액(원) | 비고 | 상태
1차 구매 | 1 | STM32 Nucleo F411RE | STM32F411RE, ARM Cortex-M4 |  |  |  | 보드 손상사고로 현재 사용 불가 | 사용 불가
1차 구매 | 2 | 저항 1kΩ | 1/4W 1% Axial, 102F |  |  |  |  | 구매완료
1차 구매 | 3 | 저항 4.7kΩ | 1/4W 1% Axial, 472F |  |  |  | I2C 풀업용 | 구매완료
1차 구매 | 4 | 저항 220Ω | 1/4W 1% Axial, 221F |  |  |  |  | 구매완료
1차 구매 | 5 | 저항 10kΩ | 1/4W 1% Axial |  |  |  |  | 구매완료
1차 구매 | 6 | 디지털 멀티미터 | UT136B+ |  |  |  | 계측용 | 구매완료
1차 구매 | 7 | 브레드보드 830핀 | MB-102 [SZH-BBAD-002] |  |  |  |  | 구매완료
1차 구매 | 8 | USB-A 2.0 to Mini 5핀 케이블 |  | 2 |  |  |  | 구매완료
1차 구매 | 9 | 브레드보드용 택트스위치 4핀 | 6×6 [SZH-TH0018] |  |  |  |  | 구매완료
1차 구매 | 10 | 5mm LED Pack | 50pcs [FIT0242] |  |  |  |  | 구매완료
1차 구매 | 11 | 점퍼 케이블 40P M/F 20cm | [CH254] |  |  |  |  | 구매완료
1차 구매 | 12 | 점퍼 케이블 40P M/M 20cm | [CH254] |  |  |  |  | 구매완료
1차 구매 | 13 | 점퍼 케이블 40P F/F 20cm | [CH254] |  |  |  |  | 구매완료
1차 구매 | 14 | SHT31 온습도 센서 모듈 | I2C [SEN0331] |  |  |  | 손상사고로 현재 사용 불가 | 사용 불가
1차 구매 | 15 | 액티브 부저 모듈 | 회로내장형 [ONE005] |  |  |  |  | 구매완료
1차 구매 | 16 | INA219 전류 센서 모듈 | High Side DC, I2C [SZH-SSBH-075] |  |  |  | 보드 손상사고로 현재 사용 불가 | 사용 불가
1차 구매 | 17 | 쿨링 팬 | 5V [SZH-AT002] |  |  |  |  | 구매완료
1차 구매 | 18 | 아날로그 포텐셔미터 모듈 | 10kΩ [EF04085] |  |  |  |  | 구매완료
1차 구매 | 19 | IRF520 MOSFET 드라이버 모듈 | [SZH-MDBL-004] |  |  |  | 팬 제어 (3.3V 구동 주의) | 구매완료
1차 구매 |  | 맥북 m4 프로 16인치, 48GB RAM,512GB SSD |  |  |  |  | 작업용 (외부구매) | 구매완료
2차 구매 | 1 | 직류 전원 공급 장치 | WANPTEK 30V 5A, 4자리 LED |  |  |  | 실험용 벤치 파워 | 구매완료
2차 구매 | 2 | 마이크로 리미트 스위치 | V-154-1C25 [VLT-LSW002] |  |  |  | 도어 감지 | 구매완료
2차 구매 | 3 | 캡톤테이프 | 단면접착, 15mm × 33m |  |  |  | 히터 고정용 | 구매완료
2차 구매 | 4 | 정류 다이오드 | 1N4007 |  |  |  |  | 구매완료
2차 구매 | 5 | 바이메탈 서모스탯 | ST-22 70°C W-TYPE |  |  |  | HW 과온 인터락 (SW-102T 대응) | 구매완료
2차 구매 | 6 | 래핑와이어 빨강 | UL1007 18AWG 10M [VLT-CAB168] |  |  |  | 전원(+) 배선 | 구매완료
2차 구매 | 7 | 래핑와이어 검정 | UL1007 18AWG 10M [VLT-CAB165] |  |  |  | 전원(-) 배선 | 구매완료
2차 구매 | 8 | 4채널 릴레이 모듈 | 5V [SZH-RLBG-012] |  |  |  |  | 구매완료
2차 구매 | 9 | USB 로직 애널라이저 | 24MHz 8채널 [AN-1] |  |  |  | 프로토콜 디버깅용 | 구매완료
2차 구매 | 10 | 악어클립 바나나잭 케이블 | 1M, 검/빨 SET [VLT-CAB081] |  |  |  | 계측용 | 구매완료
2차 구매 | 11 | 캡톤 필름 히터 | 24V 26W, 85×50mm |  |  |  | 챔버 가열 | 구매완료
2차 구매 | 12 | 알루미늄 방열판 | 1T, 100×60mm |  |  |  | MOSFET 방열 | 구매완료
2차 구매 | 13 | 육각 너트 M3 | 스텐 |  |  |  |  | 구매완료
2차 구매 | 14 | 레버형 커넥터 | PCT-1-4 (2핀 조립식) | 2 |  |  |  | 구매완료
2차 구매 | 15 | DC/DC 강압 컨버터 | 24V → 5V [SZH-BPM003] |  |  |  | 팬 전원 | 구매완료
2차 구매 | 16 | 1채널 미니 릴레이 모듈 | 5V [SZH-EK082] |  |  |  |  | 구매완료
2차 구매 | 17 | MOSFET | IRLZ44NPBF, N-ch 55V/47A |  |  |  | 히터 PWM 제어 | 구매완료
2차 구매 | 18 | 2핀 커넥터 | EK508V |  |  |  |  | 구매완료
2차 구매 | 19 | 만능 PCB 기판 | 70×90mm 양면 [PCB-0709S] |  |  |  |  | 구매완료
2차 구매 | 20 | 평와셔 M3 | 스텐 |  |  |  |  | 구매완료
2차 구매 | 21 | 코멧 BPA FREE 클리어 밀폐용기 | 2.6L |  |  |  |  | 구매완료
3차 구매 | 1 | 고전력 MOS PWM DC 모터 제어 모듈 | 4V-60V [VLT-MD021] | 2 |  |  |  | 구매완료
3차 구매 | 2 | 원터치 전선연결 커넥터 | 221-412 (2핀) |  |  |  |  | 구매완료
4차 구매 | 1 | STM32 Nucleo F446RE | STM32F446RE, ARM Cortex-M4 |  |  |  | F411RE 손상으로 교체 | 구매완료
4차 구매 | 2 | DHT22 온습도 센서 |  |  |  |  | SHT31 손상으로 구매 | 구매완료
4차 구매 | 3 | DS18B20 온도 센서 모듈 | DS18B20 |  |  |  | DHT22보다 성능이 좋아서 추가 구매 | 구매완료
4차 구매 | 4 | IC 후크 바나나 플러그 리드케이블 5종 세트 | BE863 |  |  |  | 멀티미터 후크형 케이블 용도 | 구매완료
5차 구매 | 1 | STM32 Nucleo F446RE | NUCLEO-F446RE |  |  |  | CAN 통신을 위해 추가 구매 | 구매완료
5차 구매 | 2 | SN65HVD230 CAN 트랜시버 | [TYE-CT001] | 2 |  |  |  | 구매완료
5차 구매 | 3 | CANable V2.0 Pro S USB to CAN 모듈 | C타입, 케이스 포함 |  |  |  |  | 구매완료
5차 구매 | 4 | 저항 120Ω | 1/2W 1% Axial, 121F | 10 |  |  | CAN 종단저항 | 구매완료
5차 구매 | 5 | EEPROM | 24LC256-I/P |  |  |  |  | 구매완료
5차 구매 | 6 | 오실로스코프 | Rigol DHO804 |  |  |  |  | 구매완료
6차 구매 | 1 | 아두이노 2WD RC카 프레임 주행 세트 | [VLT-KT006] |  |  |  |  | 구매완료
6차 구매 | 2 | TB6612FNG 듀얼 모터 드라이버 모듈 | [SZH-MDBL-003] |  |  |  |  | 구매완료
6차 구매 | 3 | 18650×2 리튬이온 배터리 홀더 | [SZH-BH002] |  |  |  |  | 구매완료
6차 구매 | 4 | 18650 리튬이온 배터리 | 3.7V 2600mAh, 보호회로 내장 / [UB848] | 2 |  |  |  | 구매완료
6차 구매 | 5 | 토글 스위치 | SRLS-102-C3 |  |  |  |  | 구매완료
6차 구매 | 6 | 건전지충전기 (18650용) | [BU494] |  |  |  |  | 구매완료
6차 구매 | 7 | C타입(F) to 5핀(M) 변환 젠더 | BLACK [TYE-GEN05] |  |  |  |  | 구매완료
6차 구매 | 8 | TOF 레이저 거리 센서 | VL53L0X [215921] |  |  |  |  | 구매완료
6차 구매 | 9 | 미니 서보모터 | TowerPro SG-90 9g |  |  |  |  | 구매완료
6차 구매 | 10 | 4채널 라인트레이서 적외선 센서 모듈 | [SZH-SSBH-006] |  |  |  |  | 구매완료
6차 구매 | 11 | 초음파 거리센서 모듈 | HC-SR04 [SZH-EK004] |  |  |  |  | 구매완료
6차 구매 | 12 | 라인트레이서 경기장 | 원형케이스포함 1m×1.5m |  |  |  |  | 구매완료
6차 구매 | 13 | 라즈베리파이5 액티브 쿨러 | Raspberry Pi Active Cooler [정품] |  |  |  |  | 구매완료
6차 구매 | 14 | 라즈베리파이5 8GB + 가이드북 | Raspberry Pi 5 8GB |  |  |  |  | 구매완료
6차 구매 | 15 | 공식 어댑터 | White [정품] |  |  |  |  | 구매완료
6차 구매 | 16 | 마이크로SD 128GB | EXCERIA G2 |  |  |  |  | 구매완료
6차 구매 | 17 | USB-A 3.0 to Type-C 고속 충전케이블 | CM4052 / CU301, 블랙 1m |  |  |  |  | 구매완료
6차 구매 | 18 | M3 알루미늄 서포트 Female 30mm | [SZH-ZR063] | 8 |  |  |  | 구매완료
6차 구매 | 19 | M3 알루미늄 서포트 Female 35mm | [SZH-ZR064] | 4 |  |  |  | 구매완료
6차 구매 | 20 | 스텐 둥근머리 십자볼트 M3×10 |  | 40 |  |  |  | 구매완료
6차 구매 | 21 | 너트 (니켈) M3 |  | 20 |  |  |  | 구매완료
6차 구매 | 22 | 스텐 평와샤 M3 |  | 30 |  |  |  | 구매완료
6차 구매 | 23 | 로크(나일론)너트 M3 |  | 10 |  |  |  | 구매완료
6차 구매 | 24 | 테스트[CH254] 소켓 점퍼 케이블 40P (칼라) (M/F) 20cm |  |  |  |  |  | 구매완료
6차 구매 | 25 | [KEYES] 테스트[CH254] 소켓 점퍼 케이블 40P (칼라) (M/M) 20cm |  |  |  |  |  | 구매완료
6차 구매 | 26 | 스텐 둥근머리 십자볼트 M3×6 |  | 20 |  |  |  | 구매완료
6차 구매 |  | 65W 보조배터리 CHM-PB65 20000mAh | 20,000mAh · 유선 · 3포트(C×1·A×2) · 최대 65W · QC3.0/PPS/PD3.0 | 1 |  |  | 외부구매 | 구매완료
7차 구매 | 1 | 엔코더 TT 모터(6V 160RPM 120:1) | [FIT0450] | 2 | 10400원 | 20800원 |  | 주문완료
7차 구매 | 2 | TT 모터 브라켓 | [SFB-055] | 2 | 2400원 | 4800원 |  | 주문완료
7차 구매 | 3 | Ceramic 0.1㎌, 50V |  | 10 | 30원 | 300원 |  | 주문완료
7차 구매 | 4 | 3Amp 4V-16V DC Motor Driver (2 Channels) | [MDD3A] | 1 | 13100원 | 13100원 |  | 주문완료
7차 구매 | 5 | SMD E/C 16V 470uF(85℃)/8Ø x10mm |  | 10 | 95원 | 950원 |  | 주문완료
7차 구매 | 6 | BNO086 9DoF IMU 센서 모듈(Qwiic) | [SZH-MIN086] | 1 | 46000원 | 46000원 |  | 주문완료
7차 구매 | 7 | DC-DC Buck Boost Converter Module (5A) | [DFR0946] | 1 | 14300원 | 14300원 |  | 주문완료
7차 구매 | 8 | 아두이노 전압 측정 센서 모듈 | [VLT-VCM024] | 2 | 400원 | 800원 |  | 주문완료
7차 구매 | 9 | [SparkFun] SparkFun Cryptographic Co-Processor Breakout - ATECC608A (Qwiic) | [DEV-18077] |  |  |  |  | 주문완료
7차 구매 | 10 | [GIN LING (중국)] 핀헤더 Single 1x40Pin Straight(2.54mm) |  |  |  |  |  | 주문완료
 |  |  | 7차 소계 |  |  | 101050원
8차 구매 | 1 | AURIX TC375 Lite Kit | KIT_A2G_TC375_LITE | 1 | 170000원 | 170000원 | Mouser · 2차 MCU 업그레이드(TriCore) | 주문완료
8차 구매 | 2 | USB-A → Micro-B 2.0 케이블 | 신지모루 | 2 |  |  | 맥북 허브 경유 데이터 + 보조배터리(A) 전원 겸용 · 2개(예비 포함) | 구매완료
 |  |  | 8차 소계 |  |  | 170000원
