JaehyeongIm/automotive-secure-ota-ecu/docs/test/TEST_SPEC_OTA_v1.0.md

# 소프트웨어 테스트 명세서
## Automotive Secure OTA ECU System

---

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

---

## 개정 이력

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

---

## 목차

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

---

## 1. 개요

### 1.1 목적

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

### 1.2 테스트 범위

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

### 1.3 테스트 범위 외

- Bootloader 자체 단위 테스트 (별도 명세 예정)
- 하드웨어 내구성 시험 (온도, 진동)
- EMC/EMI 시험

---

## 2. 참조 문서

| 문서 번호 | 제목 |
|---|---|
| SRS-001 | CAN Secure OTA Pipeline 소프트웨어 요구사항 명세서 |
| DIAG-001 | 시스템 다이어그램 (docs/design/diagram.md) |
| ISS-CAN-004 | CAN 핀 배선 오류 해결 기록 |
| ISO 14229-1 | Unified Diagnostic Services (UDS) |
| ISO 26262-6 | Functional Safety — Software Level |
| ASPICE v3.1 | SWE.4 / SWE.5 / SWE.6 |

---

## 3. 용어 및 약어

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

---

## 4. 테스트 전략

### 4.1 테스트 레벨

```
┌─────────────────────────────────────────┐
│  SWE.6  소프트웨어 적격성 테스트           │  ← E2E: git push → OTA 완료
├─────────────────────────────────────────┤
│  SWE.5  소프트웨어 통합 테스트             │  ← ECU 간 CAN 통신, OTA 세션
├─────────────────────────────────────────┤
│  SWE.4  소프트웨어 단위 검증               │  ← 개별 모듈 기능 검증
└─────────────────────────────────────────┘
```

### 4.2 테스트 우선순위

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

### 4.3 합격 기준 (Pass Criteria)

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

---

## 5. 테스트 환경

### 5.1 하드웨어 구성

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

### 5.2 소프트웨어 구성

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

### 5.3 CAN 버스 구성

```
DriveECU (PA11/PA12)
    └── SN65HVD230 ── CANH/CANL ── SN65HVD230 ── SensorECU (PA11/PA12)
                                         │
                                    CANable (USB)
                                         │
                                    RPi5 / PC
```

### 5.4 메모리 맵 (DriveECU / SensorECU 동일)

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

---

## 6. 테스트 케이스 — CAN 통신 (TC-CAN)

### TC-CAN-001 DriveECU 하트비트 주기 검증

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

---

### TC-CAN-002 DriveECU 하트비트 페이로드 검증

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

---

### TC-CAN-003 SensorECU 장애물 메시지 전송 검증

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

---

### TC-CAN-004 DriveECU 장애물 플래그 CAN 수신 반영 검증

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

---

## 7. 테스트 케이스 — 주행 제어 (TC-DRV)

### TC-DRV-001 버튼 트리거 — 전진 시작

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

---

### TC-DRV-002 전진 시간 종료 후 자동 정지

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

---

### TC-DRV-003 v1 — 10cm 장애물 감지 즉시 정지

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

---

### TC-DRV-004 v2 — 정지 후 자동 후진 복귀 (OTA 후)

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

---

### TC-DRV-005 OTA 다운로드 중 주행 유지

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

---

## 8. 테스트 케이스 — OTA 프로토콜 (TC-OTA)

### TC-OTA-001 DiagnosticSessionControl — ExtendedSession 정상 진입

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

---

### TC-OTA-002 SecurityAccess — Seed/Key 정상 해제

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

---

### TC-OTA-003 SecurityAccess — 잘못된 Key NRC 검증

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

---

### TC-OTA-004 SecurityAccess 없이 RequestDownload 시도 — NRC

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

---

### TC-OTA-005 RequestDownload — 비활성 슬롯 자동 선택 검증

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

---

### TC-OTA-006 TransferData — 블록 시퀀스 오류 NRC

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

---

### TC-OTA-007 TransferExit — 메타데이터 기록 및 즉시 재부팅

| 항목 | 내용 |
|---|---|
| **TC ID** | TC-OTA-007 |
| **테스트 레벨** | SWE.4 |
| **우선순위** | H |
| **참조 요구사항** | FR-CAN-013, FR-DRV-008 |
| **목적** | TransferExit 수신 시 메타데이터(pending) 기록·0x77 응답·UART 로그 출력 후 즉시 NVIC_SystemReset() 재부팅 검증 |
| **사전 조건** | TransferData 전체 청크 전송 완료(누적 수신 == image_size) |
| **테스트 절차** | 1. 0x37 (RequestTransferExit) 전송<br>2. 0x77 응답 확인<br>3. UART 로그: `[UDS] FW Slot X 완료 → 재부팅` 확인<br>4. 응답 후 약 100ms 내 재부팅 및 부트로더 로그 진입 확인 |
| **기대 결과** | 0x77 응답 수신 후 즉시(~100ms) NVIC_SystemReset() 재부팅, Bootloader 진입 |
| **합격 기준** | 응답 확인, 재부팅 발생 및 Bootloader 진입 확인 |
| **결과** | N/T |
| **비고** | ADR-001 옵션 C — 활성화는 TransferExit 시 즉시(IDLE 전제는 Gateway가 보장) |

---

### TC-OTA-008 Gateway IDLE 감지 후 OTA 시작 (wait_for_idle)

| 항목 | 내용 |
|---|---|
| **TC ID** | TC-OTA-008 |
| **테스트 레벨** | SWE.5 |
| **우선순위** | H |
| **참조 요구사항** | FR-CICD-007, FR-DRV-006 |
| **목적** | OTA 배포 스크립트가 heartbeat(CAN 0x100) driving_state로 IDLE을 확인한 뒤에만 OTA(RequestDownload)를 시작하는지 검증 |
| **사전 조건** | ECU DRIVE_RUNNING 상태, `tools/ota_client.py` 실행(`--idle-timeout` 기본 120초) |
| **테스트 절차** | 1. B1 버튼으로 ECU를 DRIVE_RUNNING 유지<br>2. ota_client OTA 트리거 → `[OTA] ECU IDLE 대기 중` 로그 확인<br>3. 주행 중(heartbeat byte[2]==1)에는 0x34가 전송되지 않음을 candump로 확인<br>4. 주행 완료로 DRIVE_IDLE(byte[2]==0) 진입 후 `[OTA] ECU IDLE 확인 → OTA 시작` 로그 및 0x34 전송 시작 확인 |
| **기대 결과** | driving_state==1 동안 OTA 미개시, IDLE 확인 후 OTA 시퀀스 시작 |
| **합격 기준** | IDLE 전 0x34 부재, IDLE 후 OTA 진행 확인 |
| **결과** | N/T |
| **비고** | ADR-001 옵션 C — IDLE 게이트는 Gateway(RPi5) `wait_for_idle`; 타임아웃 시 OTA 중단 |

---

## 9. 테스트 케이스 — 보안 (TC-SEC)

### TC-SEC-001 ECDSA 서명 검증 통과 — 정상 펌웨어 부팅

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

---

### TC-SEC-002 ECDSA 서명 검증 실패 — 변조 펌웨어 차단

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

---

### TC-SEC-003 서명 없는 펌웨어 차단

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

---

### TC-SEC-004 DefaultSession에서 SecurityAccess 시도 — NRC

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

---

## 10. 테스트 케이스 — 슬롯 관리 (TC-SLOT)

### TC-SLOT-001 메타데이터 없을 때 Slot A 기본 부팅

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

---

### TC-SLOT-002 A→B 슬롯 전환 검증

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

---

### TC-SLOT-003 B→A 슬롯 재전환 검증

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

---

## 11. 테스트 케이스 — CI/CD 파이프라인 (TC-CI)

### TC-CI-001 git push → Jenkins 자동 트리거

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

---

### TC-CI-002 변경 ECU만 선택적 빌드 검증

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

---

### TC-CI-003 E2E OTA 파이프라인 — v1→v2 전환

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

---

### TC-CI-004 OTA 실패 시 파이프라인 실패 처리

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

---

## 12. 요구사항 추적성 매트릭스

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

---

## 13. 테스트 결과 요약

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

### 13.1 결과 집계표 (TR-001 §6.1 기준)

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

### 13.2 발견된 결함

| 결함 ID | 관련 TC | 심각도 | 설명 | 상태 |
|---|---|---|---|---|
| — | — | — | 테스트 수행 전 | — |

### 13.3 테스트 완료 기준

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

---

*본 문서는 ASPICE SWE.4/5/6 산출물로 관리되며, 테스트 수행 후 결과를 본 문서에 기록한다.*
