JaehyeongIm/automotive-secure-ota-ecu/DriveECU/Core/Src/main.c

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
/* Includes ------------------------------------------------------------------*/
#include "main.h"

/* USER CODE BEGIN Includes */
#include <stdio.h>
#include <string.h>
#include "isotp.h"
#include "uds.h"
#include "drive.h"
#include "ota_flash.h"
/* USER CODE END Includes */

CAN_HandleTypeDef hcan1;

IWDG_HandleTypeDef hiwdg;

TIM_HandleTypeDef htim2;
TIM_HandleTypeDef htim3;

UART_HandleTypeDef huart2;

/* USER CODE BEGIN PV */
static CAN_TxHeaderTypeDef tx_header;
static CAN_RxHeaderTypeDef rx_header;
static uint8_t tx_data[8] = {0xDE, 0xAD, 0xBE, 0xEF, 0x00, 0x00, 0x00, 0x00};
static uint8_t rx_data[8];
static uint32_t tx_mailbox;
static uint32_t tx_count = 0;
static volatile uint8_t s_hb_sent = 0;   /* 첫 heartbeat 송신 성공 = self-test liveness */
/* USER CODE END PV */

void SystemClock_Config(void);
static void MX_GPIO_Init(void);
static void MX_CAN1_Init(void);
static void MX_IWDG_Init(void);
static void MX_USART2_UART_Init(void);
static void MX_TIM2_Init(void);
static void MX_TIM3_Init(void);
/* USER CODE BEGIN 0 */
int __io_putchar(int ch)
{
    HAL_UART_Transmit(&huart2, (uint8_t *)&ch, 1, HAL_MAX_DELAY);
    return ch;
}
/* USER CODE END 0 */

/**
  * @brief  The application entry point.
  * @retval int
  */
int main(void)
{

  /* USER CODE BEGIN 1 */
  extern uint32_t g_pfnVectors;
  __enable_irq();
  SCB->VTOR = (uint32_t)&g_pfnVectors;
  /* USER CODE END 1 */

  /* MCU Configuration--------------------------------------------------------*/

  /* Reset of all peripherals, Initializes the Flash interface and the Systick. */
  HAL_Init();

  /* Configure the system clock */
  SystemClock_Config();

  /* Initialize all configured peripherals */
  MX_GPIO_Init();
  MX_CAN1_Init();
  MX_IWDG_Init();
  MX_USART2_UART_Init();
  MX_TIM2_Init();
  MX_TIM3_Init();
  /* USER CODE BEGIN 2 */
  CAN_FilterTypeDef filter = {0};
  filter.FilterBank           = 0;
  filter.FilterMode           = CAN_FILTERMODE_IDMASK;
  filter.FilterScale          = CAN_FILTERSCALE_32BIT;
  filter.FilterIdHigh         = 0x0000;
  filter.FilterIdLow          = 0x0000;
  filter.FilterMaskIdHigh     = 0x0000;
  filter.FilterMaskIdLow      = 0x0000;
  filter.FilterFIFOAssignment = CAN_RX_FIFO0;
  filter.FilterActivation     = ENABLE;
  {
    HAL_StatusTypeDef r;
    r = HAL_CAN_ConfigFilter(&hcan1, &filter);
    printf("[CAN] ConfigFilter=%d\r\n", (int)r);
    r = HAL_CAN_Start(&hcan1);
    printf("[CAN] Start=%d state=%lu ESR=0x%08lX\r\n",
           (int)r, (uint32_t)hcan1.State, CAN1->ESR);
    r = HAL_CAN_ActivateNotification(&hcan1, CAN_IT_RX_FIFO0_MSG_PENDING);
    printf("[CAN] Notify=%d\r\n", (int)r);
  }

  tx_header.StdId = 0x100;
  tx_header.IDE   = CAN_ID_STD;
  tx_header.RTR   = CAN_RTR_DATA;
  tx_header.DLC   = 8;

  HAL_TIM_Base_Start_IT(&htim2);
  isotp_init(uds_on_isotp_rx);
  uds_init();
  drive_init();
  /* B1(PC13) EXTI 인터럽트 활성화 — MX_GPIO_Init에서 핀 설정만 하고 NVIC는 수동 등록 */
  HAL_NVIC_SetPriority(EXTI15_10_IRQn, 5, 0);
  HAL_NVIC_EnableIRQ(EXTI15_10_IRQn);
  printf("[DriveECU v%d] Start, Slot=%d\r\n", APP_VERSION, ota_get_active_slot());

  /* USER CODE END 2 */

  /* Infinite loop */
  /* USER CODE BEGIN WHILE */
  while (1)
  {
    /* USER CODE END WHILE */

    /* USER CODE BEGIN 3 */
#ifdef HIL_SELFTEST_FAIL
    while (1) { }   /* HIL TC-02 픽스처: self-test 전 hang → IWDG 리셋 → 3-strike */
#endif
    HAL_IWDG_Refresh(&hiwdg);
    uds_process();

    /* self-test commit (FR-AB-004): main 루프 도달 + 페리페럴 init + heartbeat 송신 성공
     * → 현재 슬롯이 TRIAL이면 CONFIRMED로 확정(1회). 플래시 쓰기라 ISR 아닌 메인 루프에서. */
    static uint8_t s_self_confirmed = 0;
    if (s_hb_sent && !s_self_confirmed) {
        s_self_confirmed = 1;
        ota_meta_self_confirm(ota_get_active_slot());
    }

    uint32_t now = HAL_GetTick();

    static uint32_t s_drive_tick = 0;
    if (now - s_drive_tick >= 20) {
        s_drive_tick = now;
        drive_update();
    }

    static uint32_t s_last_tick = 0;
    if (now - s_last_tick >= 3000) {
        s_last_tick = now;
        printf("[ALIVE] t=%lu CAN state=%lu ESR=0x%08lX\r\n",
               now, (uint32_t)hcan1.State, CAN1->ESR);
    }
  }
  /* USER CODE END 3 */
}

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
/* USER CODE BEGIN 4 */
void HAL_TIM_PeriodElapsedCallback(TIM_HandleTypeDef *htim)
{
    if (htim->Instance != TIM2) return;

    tx_data[0] = APP_VERSION;
    tx_data[1] = ota_get_active_slot();
    tx_data[2] = (uint8_t)g_driving_state;
    tx_data[3] = (uint8_t)g_obstacle_flag;
    tx_data[4] = (uint8_t)(tx_count >> 24);
    tx_data[5] = (uint8_t)(tx_count >> 16);
    tx_data[6] = (uint8_t)(tx_count >> 8);
    tx_data[7] = (uint8_t)(tx_count);
    tx_count++;

    if (HAL_CAN_AddTxMessage(&hcan1, &tx_header, tx_data, &tx_mailbox) == HAL_OK) {
        HAL_GPIO_TogglePin(LD2_GPIO_Port, LD2_Pin);
        s_hb_sent = 1;   /* self-test 항목: CAN 스택 생존 증명 */
    } else {
        static uint8_t s_once = 0;
        if (!s_once) {
            s_once = 1;
            printf("[TIM2] CAN TX fail: state=%lu ESR=0x%08lX err=0x%08lX\r\n",
                   (uint32_t)hcan1.State, CAN1->ESR, hcan1.ErrorCode);
        }
    }
}

void HAL_CAN_RxFifo0MsgPendingCallback(CAN_HandleTypeDef *hcan)
{
    HAL_CAN_GetRxMessage(hcan, CAN_RX_FIFO0, &rx_header, rx_data);

    if (rx_header.StdId == ISOTP_RX_CAN_ID) {
        isotp_can_rx(rx_data, (uint8_t)rx_header.DLC);
        return;
    }

    if (rx_header.StdId == 0x200) {
        g_obstacle_flag = rx_data[0];
        g_distance_cm   = ((uint16_t)rx_data[1] << 8) | rx_data[2];
        drive_note_sensor_rx();   /* 신선도 감시: 수신 시각 갱신 */
        return;
    }
    /* 그 외 프레임(센서 0x201 하트비트 등)은 무시. ISR 안에서 printf 금지 —
     * 매 수신마다 blocking printf는 UART를 폭주시키고, 재진입으로 메인의
     * [BL]/[UDS] 로그를 깨뜨려 HIL 관측을 방해한다. */
}
void HAL_GPIO_EXTI_Callback(uint16_t GPIO_Pin)
{
    if (GPIO_Pin != B1_Pin) return;
    static uint32_t s_last_press = 0;
    uint32_t now = HAL_GetTick();
    if (now - s_last_press < 300) return;  /* 디바운스 300ms */
    s_last_press = now;
    g_button_pressed = 1;
}
/* USER CODE END 4 */
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
