JaehyeongIm/automotive-secure-ota-ecu/DriveECU/Core/Src/motor.c

#include "motor.h"
#include "main.h"

extern TIM_HandleTypeDef htim3;

void motor_init(void)
{
    HAL_TIM_PWM_Start(&htim3, TIM_CHANNEL_1);
    HAL_TIM_PWM_Start(&htim3, TIM_CHANNEL_2);
    HAL_GPIO_WritePin(AIN1_GPIO_Port, AIN1_Pin, GPIO_PIN_SET);
    HAL_GPIO_WritePin(AIN2_GPIO_Port, AIN2_Pin, GPIO_PIN_RESET);
    HAL_GPIO_WritePin(BIN1_GPIO_Port, BIN1_Pin, GPIO_PIN_SET);
    HAL_GPIO_WritePin(BIN2_GPIO_Port, BIN2_Pin, GPIO_PIN_RESET);
    HAL_GPIO_WritePin(MOTOR_STBY_GPIO_Port, MOTOR_STBY_Pin, GPIO_PIN_SET);
}

void motor_set(uint16_t left, uint16_t right)
{
    if (left  > 999) left  = 999;
    if (right > 999) right = 999;
    __HAL_TIM_SET_COMPARE(&htim3, TIM_CHANNEL_1, left);
    __HAL_TIM_SET_COMPARE(&htim3, TIM_CHANNEL_2, right);
}

void motor_stop(void)
{
    __HAL_TIM_SET_COMPARE(&htim3, TIM_CHANNEL_1, 0);
    __HAL_TIM_SET_COMPARE(&htim3, TIM_CHANNEL_2, 0);
    /* 방향 핀을 전진으로 복귀 — 다음 motor_set() 호출이 전진으로 동작하도록 */
    HAL_GPIO_WritePin(AIN1_GPIO_Port, AIN1_Pin, GPIO_PIN_SET);
    HAL_GPIO_WritePin(AIN2_GPIO_Port, AIN2_Pin, GPIO_PIN_RESET);
    HAL_GPIO_WritePin(BIN1_GPIO_Port, BIN1_Pin, GPIO_PIN_SET);
    HAL_GPIO_WritePin(BIN2_GPIO_Port, BIN2_Pin, GPIO_PIN_RESET);
}

void motor_reverse(uint16_t left, uint16_t right)
{
    HAL_GPIO_WritePin(AIN1_GPIO_Port, AIN1_Pin, GPIO_PIN_RESET);
    HAL_GPIO_WritePin(AIN2_GPIO_Port, AIN2_Pin, GPIO_PIN_SET);
    HAL_GPIO_WritePin(BIN1_GPIO_Port, BIN1_Pin, GPIO_PIN_RESET);
    HAL_GPIO_WritePin(BIN2_GPIO_Port, BIN2_Pin, GPIO_PIN_SET);
    motor_set(left, right);
}
