JaehyeongIm/automotive-secure-ota-ecu/DriveECU/Core/Inc/ota_flash.h

#ifndef OTA_FLASH_H
#define OTA_FLASH_H

#include <stdint.h>
#include "stm32f4xx_hal.h"

/* Slot/metadata layout and the OTA_Metadata_t struct live in ota_meta.h (SSOT).
 * This header only declares the HAL-backed flash operations (mockable). */

#define SLOT_A_START_ADDR  0x08010000UL
#define SLOT_A_END_ADDR    0x08040000UL   /* 192KB */
#define SLOT_B_START_ADDR  0x08040000UL
#define SLOT_B_END_ADDR    0x08080000UL   /* 256KB */

HAL_StatusTypeDef ota_flash_erase_slot_a(void);
HAL_StatusTypeDef ota_flash_erase_slot_b(void);
HAL_StatusTypeDef ota_flash_write(uint32_t addr, const uint8_t *data, uint16_t len);
HAL_StatusTypeDef ota_meta_write_pending(uint8_t slot, uint32_t fw_size, uint32_t fw_version);
HAL_StatusTypeDef ota_meta_self_confirm(uint8_t my_slot);
uint8_t           ota_get_active_slot(void);

/* 영속 단조 seq_counter를 +1 하고 새 값을 *new_seq에 반환(부팅당 1회). SecurityAccess
 * seed freshness용 boot-epoch — 재부팅에도 유지되어 seed 비반복 보장(SR-ATK-005).
 * 유효 메타 없으면 HAL_ERROR. ping-pong 원자커밋(전원단절 안전). */
HAL_StatusTypeDef ota_meta_bump_seq(uint32_t *new_seq);

#endif
