JaehyeongIm/automotive-secure-ota-ecu/Bootloader/Core/Src/bootloader.c

#include "bootloader.h"

#ifndef UNIT_TEST
#include "ecdsa_pubkey.h"
#include "main.h"
#include <stdio.h>
#include <string.h>

#define uECC_SUPPORTS_secp160r1 0
#define uECC_SUPPORTS_secp192r1 0
#define uECC_SUPPORTS_secp224r1 0
#define uECC_SUPPORTS_secp256r1 1
#define uECC_SUPPORTS_secp256k1 0
#include "../Lib/uECC.h"
#include "../Lib/sha256.h"

typedef void (*pFunction)(void);

extern IWDG_HandleTypeDef hiwdg;

static int is_valid_app(uint32_t addr)
{
    uint32_t sp = *(volatile uint32_t *)addr;
    /* STM32F446RE SRAM: 0x20000000 ~ 0x2002FFFF (128KB) */
    return ((sp & 0xFF000000) == 0x20000000);
}

static void jump_to_app(uint32_t addr)
{
    uint32_t sp = *(volatile uint32_t *)addr;
    uint32_t pc = *(volatile uint32_t *)(addr + 4);

    printf("[BL] Jump to 0x%08lX  SP=0x%08lX  PC=0x%08lX\r\n", addr, sp, pc);
    HAL_Delay(10);

    __disable_irq();
    HAL_DeInit();

    SCB->VTOR = addr;
    __set_MSP(sp);

    pFunction reset_handler = (pFunction)pc;
    reset_handler();

    while (1);
}

static void safe_state(void)
{
    printf("[BL] Safe State: all slots invalid. Reflash via ST-Link.\r\n");
    while (1) {
        HAL_IWDG_Refresh(&hiwdg);
        HAL_Delay(1000);
        printf("[BL] Waiting...\r\n");
    }
}

/* 메타데이터 전이를 비활성 사본에 원자적으로 커밋(ping-pong, CRC 마지막 워드). */
static void bl_meta_commit(OTA_Metadata_t *m)
{
    const OTA_Metadata_t *ca = (const OTA_Metadata_t *)METADATA_A_ADDR;
    const OTA_Metadata_t *cb = (const OTA_Metadata_t *)METADATA_B_ADDR;
    int va = ota_meta_valid(ca), vb = ota_meta_valid(cb);
    int to_b;
    if (va && vb) to_b = (ca->seq_counter >= cb->seq_counter) ? 1 : 0;
    else if (va)  to_b = 1;
    else          to_b = 0;

    m->crc32 = ota_meta_crc(m);   /* seal; crc32가 마지막 워드라 마지막에 기록됨 */

    FLASH_EraseInitTypeDef erase = {0};
    uint32_t err;
    uint32_t addr = to_b ? METADATA_B_ADDR : METADATA_A_ADDR;
    erase.TypeErase    = FLASH_TYPEERASE_SECTORS;
    erase.VoltageRange = FLASH_VOLTAGE_RANGE_3;
    erase.Sector       = to_b ? FLASH_SECTOR_3 : FLASH_SECTOR_2;
    erase.NbSectors    = 1;

    HAL_FLASH_Unlock();
    if (HAL_FLASHEx_Erase(&erase, &err) != HAL_OK) { HAL_FLASH_Lock(); return; }
    const uint8_t *src = (const uint8_t *)m;
    for (uint32_t i = 0; i < sizeof(*m); i += 4) {
        uint32_t word;
        memcpy(&word, &src[i], 4);
        if (HAL_FLASH_Program(FLASH_TYPEPROGRAM_WORD, addr + i, word) != HAL_OK) break;
    }
    HAL_FLASH_Lock();
}
#endif /* UNIT_TEST */

/* 메타데이터만으로 부팅 주소를 결정한다.
   HAL/ECDSA 없이 순수 로직만 포함 — 호스트 단위 테스트 가능. */
uint32_t bootloader_select_boot_addr(const OTA_Metadata_t *meta)
{
    if (meta->magic != METADATA_MAGIC)
        return SLOT_A_ADDR;

    if (meta->active_slot == 0) {
        if (meta->slot_a_status == SLOT_CONFIRMED || meta->slot_a_status == SLOT_UPDATED)
            return SLOT_A_ADDR;
        if (meta->slot_b_status == SLOT_CONFIRMED)
            return SLOT_B_ADDR;
        return 0;  /* 두 슬롯 모두 유효하지 않음 → safe_state 진입 */
    } else {
        if (meta->slot_b_status == SLOT_CONFIRMED || meta->slot_b_status == SLOT_UPDATED)
            return SLOT_B_ADDR;
        if (meta->slot_a_status == SLOT_CONFIRMED)
            return SLOT_A_ADDR;
        return 0;
    }
}

/* 검증 게이팅 결정 (FR-AB-003 fail-closed). HAL 없이 순수 — 호스트 단위 테스트 가능. */
bl_verify_decision_t bootloader_verify_decision(const OTA_Metadata_t *meta,
                                                uint32_t fw_total, uint32_t slot_max)
{
    if (meta->magic != METADATA_MAGIC)
        return BL_VERIFY_SKIP;                  /* 메타 없음 = factory/ST-Link 미서명 dev */
    if (fw_total > 64u && fw_total <= slot_max)
        return BL_VERIFY_REQUIRED;              /* 정상 size → ECDSA 통과 필수 */
    return BL_VERIFY_REFUSE;                    /* size==0/초과/0xFFFFFFFF → fail-closed 거부 */
}

#ifndef UNIT_TEST
void bootloader_run(void)
{
    printf("[BL] Bootloader v1.0\r\n");

    /* Redundant metadata: pick the CRC-valid copy with the highest seq (FR-AB-005). */
    OTA_Metadata_t meta;
    if (ota_meta_select((const OTA_Metadata_t *)METADATA_A_ADDR,
                        (const OTA_Metadata_t *)METADATA_B_ADDR, &meta)) {
        printf("[BL] meta seq=%lu active=%lu  A=0x%08lX  B=0x%08lX\r\n",
               meta.seq_counter, meta.active_slot, meta.slot_a_status, meta.slot_b_status);
    } else {
        memset(&meta, 0, sizeof(meta));   /* no valid copy → magic=0 → default Slot A */
        printf("[BL] No valid metadata, defaulting to Slot A\r\n");
    }

    /* Trial / 3-strike 생명주기 (FR-AB-007): 부팅 슬롯 결정 + 전이 커밋. */
    OTA_Metadata_t newmeta;
    OTA_BootPlan_t plan = ota_meta_plan_boot(&meta, &newmeta, 3);
    switch (plan.event) {
    case BOOT_EV_TRIAL_START:
        printf("[BL] trial start: slot %d (attempt 1)\r\n", plan.boot_slot); break;
    case BOOT_EV_TRIAL_RETRY:
        printf("[BL] trial retry: slot %d (attempt %lu)\r\n",
               plan.boot_slot, (unsigned long)newmeta.boot_count); break;
    case BOOT_EV_ROLLBACK:
        printf("[BL] 3-strike: slot %lu reached limit -> INVALID, rollback\r\n",
               (unsigned long)meta.active_slot); break;
    case BOOT_EV_FALLBACK:
        printf("[BL] fallback: candidate invalid -> slot %d (CONFIRMED)\r\n", plan.boot_slot); break;
    case BOOT_EV_CONFIRMED:
        printf("[BL] confirmed boot: slot %d\r\n", plan.boot_slot); break;
    case BOOT_EV_FACTORY:
        printf("[BL] no metadata -> factory slot A\r\n"); break;
    case BOOT_EV_SAFE:
        printf("[BL] no bootable slot\r\n"); break;
    }
    if (plan.write) {
        bl_meta_commit(&newmeta);
        meta = newmeta;   /* 이후 로직은 갱신된 상태 사용 */
    }
    if (plan.boot_slot < 0) {
        safe_state();
        return;
    }
    uint32_t boot_addr = (plan.boot_slot == 0) ? SLOT_A_ADDR : SLOT_B_ADDR;

    if (!is_valid_app(boot_addr + IMG_HEADER_SIZE)) {
        printf("[BL] No valid app at 0x%08lX, trying fallback\r\n", boot_addr);
        if (boot_addr == SLOT_B_ADDR && meta.slot_a_status == SLOT_CONFIRMED) {
            boot_addr = SLOT_A_ADDR;
            printf("[BL] Fallback to Slot A\r\n");
        } else if (boot_addr == SLOT_A_ADDR && meta.slot_b_status == SLOT_CONFIRMED) {
            boot_addr = SLOT_B_ADDR;
            printf("[BL] Fallback to Slot B\r\n");
        } else {
            safe_state();
            return;
        }
        if (!is_valid_app(boot_addr + IMG_HEADER_SIZE)) {
            printf("[BL] Fallback slot also invalid, entering Safe State\r\n");
            safe_state();
            return;
        }
    }

    /* ECDSA 검증 게이팅 (FR-AB-003 fail-closed): 메타가 있는데 size가 비정상이면
     * '검증 우회'가 아니라 '부팅 거부'. 메타 부재(factory)만 검증 없이 부팅. */
    uint32_t fw_total = (boot_addr == SLOT_A_ADDR) ? meta.slot_a_size : meta.slot_b_size;
    uint32_t slot_max = (boot_addr == SLOT_A_ADDR) ? 0x30000UL : 0x40000UL;
    bl_verify_decision_t vd = bootloader_verify_decision(&meta, fw_total, slot_max);

    if (vd == BL_VERIFY_REFUSE) {
        printf("[BL] metadata size invalid (0x%08lX) — fail-closed, refusing\r\n",
               (unsigned long)fw_total);
        safe_state();
        return;
    }
    if (vd == BL_VERIFY_REQUIRED) {
        uint32_t fw_data_size  = fw_total - 64;
        const uint8_t *fw_ptr  = (const uint8_t *)boot_addr;
        const uint8_t *sig_ptr = fw_ptr + fw_data_size;

        SHA256_CTX ctx;
        uint8_t hash[32];
        sha256_init(&ctx);
        sha256_update(&ctx, fw_ptr, fw_data_size);
        sha256_final(&ctx, hash);

        if (!uECC_verify(ecdsa_pubkey, hash, 32, sig_ptr, uECC_secp256r1())) {
            printf("[BL] ECDSA FAILED at 0x%08lX — refusing to boot\r\n", boot_addr);
            safe_state();
            return;
        }
        printf("[BL] ECDSA OK\r\n");

        /* anti-rollback (FR-BL-008): 서명된 헤더 버전이 기준선보다 낮으면 거부.
         * 헤더는 ECDSA로 검증된 영역(slot+0)이라 이 시점에 신뢰 가능. */
        OTA_ImgHeader_t hdr;
        if (ota_img_header_read(fw_ptr, &hdr)) {
            if (!ota_meta_version_allowed(&meta, hdr.fw_version)) {
                printf("[BL] anti-rollback: v%lu below baseline — refusing\r\n",
                       (unsigned long)hdr.fw_version);
                /* 거부 슬롯을 INVALID 마킹 + 이전 CONFIRMED로 롤백(가용성↑, 옛 버전 미실행).
                 * 폴백 CONFIRMED 없으면 safe_state. */
                uint32_t other = (boot_addr == SLOT_A_ADDR) ? 1u : 0u;
                uint32_t ostat = other ? meta.slot_b_status : meta.slot_a_status;
                if (ostat == SLOT_CONFIRMED) {
                    OTA_Metadata_t nm = meta;
                    if (boot_addr == SLOT_A_ADDR) nm.slot_a_status = SLOT_INVALID;
                    else                          nm.slot_b_status = SLOT_INVALID;
                    nm.active_slot = other;
                    nm.seq_counter = meta.seq_counter + 1u;
                    printf("[BL] rollback to slot %lu (CONFIRMED) + reset\r\n",
                           (unsigned long)other);
                    bl_meta_commit(&nm);
                    NVIC_SystemReset();
                }
                safe_state();
                return;
            }
            printf("[BL] version v%lu OK\r\n", (unsigned long)hdr.fw_version);
        }
    }
    /* BL_VERIFY_SKIP → 미서명 factory/ST-Link 경로, 검증 없이 부팅 */

    /* IWDG 시작: 앱이 8초 내 kick 안 하면 리셋 */
    hiwdg.Instance       = IWDG;
    hiwdg.Init.Prescaler = IWDG_PRESCALER_256;
    hiwdg.Init.Reload    = 999;
    HAL_IWDG_Init(&hiwdg);

    jump_to_app(boot_addr + IMG_HEADER_SIZE);   /* 앱 벡터테이블 = slot+0x200 (앞 헤더) */
}
#endif /* UNIT_TEST */
