JaehyeongIm/automotive-secure-ota-ecu/Bootloader/Core/Inc/ecdsa_pubkey.h

#ifndef ECDSA_PUBKEY_H
#define ECDSA_PUBKEY_H

#include <stdint.h>

/* ECDSA-P256 public key (uncompressed, x || y, 64 bytes) */
static const uint8_t ecdsa_pubkey[64] = {
    0x58, 0xCD, 0x00, 0x78, 0x33, 0xAF, 0x53, 0x0D,
    0x1B, 0x3C, 0xE2, 0x76, 0xF4, 0x69, 0xE3, 0x2D,
    0x52, 0xD1, 0x37, 0x6C, 0xC0, 0x14, 0x37, 0x54,
    0x64, 0x00, 0xD0, 0x1C, 0xB6, 0x30, 0x0C, 0x8C,
    0x4F, 0x8A, 0x46, 0xC7, 0x86, 0x91, 0x48, 0x2A,
    0x8A, 0x21, 0xDD, 0x89, 0xB8, 0x0E, 0x9F, 0x6E,
    0xD5, 0xBC, 0x77, 0xA3, 0x24, 0xD6, 0xF9, 0x46,
    0x79, 0x96, 0xFB, 0xFD, 0x3A, 0x59, 0x8E, 0x47,
};

#endif /* ECDSA_PUBKEY_H */
