JaehyeongIm/automotive-secure-ota-ecu/(commit log)

2026-05-16 docs: 초기 커밋 - SRS-001 v1.4 및 부품 구매 목록
    - SRS-001_CAN_Secure_OTA_Pipeline_v4.md (v1.4): CAN 기반 UDS over ISO-TP Secure OTA 파이프라인 요구사항 명세서
    - 부품_구매_목록.xlsx: 프로젝트 하드웨어 부품 목록
    [부품_구매_목록.xlsx]
2026-05-16 docs(SRS): 실무 검토 피드백 반영 및 프로토콜 수치화 (v1.6)
    - 파일명 v4.md → v1.4.md 변경 (버전 체계 1.x 통일)
    - v1.4: ISO-TP 추가, Drive/Sensor ECU v1/v2 제어 로직 구체화, HC-SR04 확정
    - v1.5: Jenkins CI/CD 파이프라인 요구사항(FR-CICD-001~009), 개발 일정 3주(Section 21)
    - v1.6: CAN ID 테이블(Section 13.2), ISO-TP/Security Access 파라미터 수치화,
    키 관리 요구사항(SR-KEY-001~004), IWDG 8000ms/WRP(FR-BL-012~013),
    Safe State 정의(NFR-SAFE-004), UVR-001(SWE.4) 필수 문서, UN R156 Out of Scope
2026-05-16 chore: .gitignore 추가
2026-05-17 feat: Phase 1-2 STM32 펌웨어 및 CAN 모니터링 스크립트 추가
    - DriveECU: CAN 0x100 Status 200ms 주기 송신 (TIM2)
    - SensorECU: CAN 0x201 Heartbeat 100ms 주기 송신 (TIM3)
    - 구현절차.md: 하드웨어 배선 절차 추가, 서식 정리
    - tools/can_monitor.py: python-can 기반 PC 모니터링 스크립트
2026-05-18 fix: DriveECU RX cnt 파싱 오프셋 수정 및 Phase 1-2 완료 처리
    - DriveECU RX 콜백: hb_count 파싱을 data[4-7] → data[1-4]로 수정
    - 시작 로그 문구 수정: CAN Loopback Test Start → Start
    - 구현절차.md: 루프백/양방향 테스트 설명 명확화, Phase 3 구분선 추가
    [main.c]
2026-05-18 feat: Phase 3 Bootloader 구현 완료
    - Bootloader: Metadata 기반 Slot A/B 선택 후 점프
    - Bootloader: IWDG 8s 타임아웃 (앱 미kick 시 리셋)
    - Bootloader: 유효하지 않은 슬롯 Safe State 처리
    - DriveECU: 링커 스크립트 Slot A(0x08010000, 192KB)로 변경
    - DriveECU: VECT_TAB_OFFSET 0x10000으로 수정
    - 로그 메시지 한글 → 영어 변경
    [bootloader.c, bootloader.h, main.c, main.h]
2026-05-19 feat: Phase 4 UDS/ISO-TP/OTA 스택 구현 및 VTOR 버그 수정
    - ISO-TP SF/FF/CF/FC 레이어 구현 (isotp.c/h)
    - UDS 서비스 핸들러 구현 (uds.c/h): 0x10/0x27/0x34/0x36/0x37
    - Slot B Flash 소거/쓰기/Metadata 기록 구현 (ota_flash.c/h)
    - PC Python OTA 클라이언트 구현 (tools/ota_client.py)
    - Slot B 링커 스크립트 추가 (STM32F446RETX_FLASH_SlotB.ld)
    - main() 시작부 SCB->VTOR 명시적 설정으로 인터럽트 벡터 오동작 수정
    - 트러블슈팅 문서 및 하드웨어 독립적 선행 구현 기록 추가
    [부품_구매_목록.xlsx]
2026-05-19 chore: IDE 설정 파일 gitignore 추가 및 추적 제거
2026-05-19 fix: DriveECU 부트로더 연동 후 CAN 인터럽트 불능 3가지 원인 수정
    - __enable_irq(): 부트로더 __disable_irq() 후 PRIMASK=1 상태로 점프하므로 복원
    - SCB->VTOR = 0x08010000U: SystemInit() 우회 대비 Slot A 벡터 테이블 명시 설정
    - MX_IWDG_Init() 복원: 디버깅 중 주석 처리했던 IWDG 초기화 재활성화
    - VECT_TAB_OFFSET 0x00010000U: Slot A 빌드 기준으로 수정
    - .gitignore: STM32CubeIDE 설정파일 패턴 추가
    - troubleshooting.md: Phase 4 트러블슈팅 전 과정 정확하게 문서화
    [main.c]
2026-05-19 fix: VTOR 하드코딩 제거 — g_pfnVectors 링커 심볼로 슬롯 무관 자동 설정
    SCB->VTOR = 0x08010000U 하드코딩을 g_pfnVectors 링커 심볼로 교체하여
    Slot A/B 전환 시 소스 수정 없이 올바른 벡터 테이블 주소가 자동 설정된다.
    troubleshooting.md에 Phase 4.5 VTOR/링커스크립트 불일치 섹션 추가.
    [main.c]
2026-05-19 chore: 루트 문서 docs/로 이동 정리 및 gitignore 보완
    - 루트의 SRS, 구현절차, 부품목록 파일 삭제 (docs/로 이동 완료)
    - .gitignore에 SlotB/ 빌드 폴더 추가
    - DriveECU/.settings/language.settings.xml git 추적 제거
    [부품_구매_목록.xlsx]
2026-05-19 docs: troubleshooting 파일명을 문제 현상에 맞게 변경
2026-05-19 docs: 원인 1 설명 수정 — startup 건너뜀(오류) → VECT_TAB_OFFSET=0 오설정(정확)
2026-05-20 fix: PENDING 슬롯 손상 시 Bootloader Slot A 폴백 누락 수정
    OTA 중단으로 Slot B가 erase된 채 PENDING 상태로 남으면
    is_valid_app() 실패 후 Slot A CONFIRMED 여부와 무관하게
    Safe State로 진입하는 버그 수정.
    - bootloader.c: is_valid_app() 실패 시 반대 슬롯 CONFIRMED 확인 후 폴백
    - ota_client.py: RPi5 socketcan 인터페이스 지원 추가 (--interface socketcan)
    - docs/구현절차.md: Phase 5A 완료, 미완료 항목 현황 반영
    - docs/troubleshooting: phase5_bootloader_fallback_pending_invalid.md 추가
    [bootloader.c, ota_client.py]
2026-05-20 feat: 진정한 A/B OTA + Bootloader ECDSA-P256 서명 검증 구현
    [Bootloader]
    - OTA_Metadata_t에 slot_a_size / slot_b_size 필드 추가 (reserved 대체)
    - bootloader.c: ECDSA-P256 + SHA-256 서명 검증 블록 추가
    - size==0 또는 size>slot_max 이면 건너뜀 (ST-Link 플래싱 호환)
    - 검증 실패 시 safe_state() 진입
    - micro-ecc 라이브러리 및 SHA-256 추가 (Bootloader/Core/Lib/)
    - uECC_PLATFORM=0 으로 순수 C 구현 강제 (-mthumb 호환)
    - ecdsa_pubkey.h 추가 (secp256r1 공개키)
    [DriveECU]
    - ota_flash.c 전면 재작성: 진정한 A/B 슬롯 지원
    - ota_flash_erase_slot_a() 추가 (Sector 4+5)
    - ota_flash_write()가 Slot A / Slot B 모두 허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
2026-05-20 docs: 구현절차 및 SRS A/B OTA / ECDSA 완료 내용 반영
    구현절차.md
    - Phase 4/5A/5B 상태 완료로 업데이트
    - Flash 섹터 레이아웃 오류 수정 (Slot A: 섹터 4+5, Slot B: 섹터 6+7)
    - A/B 슬롯 동작 원리 및 sign_firmware.py 서명 포맷 설명 추가
    - Bootloader, DriveECU, RPi5 구현 상태표 최신화
    - 권장 진행 순서에서 완료 Phase 제거, 미해결 이슈 ISS-CAN-003 기록
    - Phase 5B 설명을 실제 구현(Appended Signature) 기준으로 교체
    SRS-001 v1.7
    - 버전 1.6 → 1.7, 작성일 업데이트
    - Section 14.2 "초기 파티션 제안" → "확정 파티션 레이아웃"으로 변경
    (섹터 경계·주소·크기를 실제 Linker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
2026-05-21 docs: ISS-CAN-003 근본 원인 및 해결 내용 기록
    __enable_irq() 누락으로 인한 인터럽트 전역 차단이 원인.
    May 18 빌드(fix 이전)가 Slot B에 남아 있다가 May 21 재빌드 OTA로 해결.
2026-05-21 feat: Phase 6A DriveECU 라인트레이싱 + 모터 제어 구현
    - motor.c/h: TIM3 CH1/CH2(PB4/PB5) PWM + TB6612FNG GPIO 제어
    - drive.c/h: ADC1 3채널(PA0/PA1/PA4) 센서 읽기 + App v1(ON/OFF)/v2(비례) 주행 로직
    - main.c: drive_init/update 20ms 주기 실행, 0x100 페이로드 업데이트, 0x200 장애물 수신 처리
    - uds.c: RequestDownload 시 g_ota_active 세트 → 모터 즉시 정지
    - CubeMX: TIM3 PWM, ADC1 IN0/IN1/IN4, GPIO PC0~PC4 추가
2026-05-21 refactor: 라인센서 ADC → GPIO 디지털 입력 전환 (4채널)
    - ADC1 제거, PA0/PA1/PA4/PB0 GPIO Input으로 교체 (IR_S1~S4)
    - drive.c: read_sensors() GPIO 읽기로 변경
    - App v1: 4채널 우선순위 ON/OFF 로직 (S1/S4 급선회, S2/S3 완선회)
    - App v2: 가중치(-3/-1/+1/+3) 합산 비례 제어
    - ADC HAL 드라이버 파일 제거
2026-05-21 feat: Phase 6B SensorECU HC-SR04 거리 측정 + OTA 스택 구현
    - HC-SR04 TIM2 1μs polling 거리 측정 (hcsr04.c/h)
    - 50ms 주기 측정, 0x200 CAN TX (obstacle + distance)
    - APP_VERSION 1: 15cm / v2: 25cm 임계값
    - ISO-TP (0x7E1/0x7E9) + UDS A/B OTA 스택 포팅
    - 링커: SlotA(0x08010000 192K) / SlotB(0x08040000 256K)
    - VTOR 고정 + __enable_irq() 추가 (ISS-CAN-003 방지)
    - 0x201 heartbeat: APP_VERSION / 슬롯 / 거리 / obstacle 포함
2026-05-24 fix: Phase 6 DriveECU/SensorECU 통합 주행 수정
    - DriveECU drive.c: IR 센서 방향 반전(D1=우측 기준), 교차로 전체 감지 직진 케이스 추가
    - DriveECU main.c: 하드코딩된 버전 문자열 → APP_VERSION/active_slot 사용
    - SensorECU main.c: CAN 초기화 결과(ConfigFilter/Start/Notify/State/ESR) 로깅 추가
    [부품_구매_목록.xlsx]
2026-05-24 docs: ISS-CAN-004 CAN 핀 배선 오류 해결 기록
    - 근본 원인: 재배치 시 트랜시버를 PB8/PB9에 연결했으나 CubeMX 설정은 PA11(CAN1_RX)/PA12(CAN1_TX)
    - 해결: 조립 전 촬영 사진 + CubeMX 핀맵 대조로 오류 발견, PA11/PA12로 재연결 후 정상 동작 확인
    - 체크리스트 및 배선 정보 PA11/PA12 기준으로 수정
2026-05-24 feat: DriveECU 비례제어 전환 + 라인이탈 복귀 로직 추가
    - drive.h: APP_VERSION 1 → 2 (ON/OFF 제어 → 비례(P) 제어)
    - drive.c: 라인 이탈 시 s_last_error 방향으로 계속 회전하여 복귀 시도
    - drive.c: 센서 극성 반전 (GPIO_PIN_RESET → SET, 검은 라인 / 흰 배경 기준)
    - SensorECU main.c: 거리 측정값 UART 출력 추가 ([DIST] %u cm)
2026-05-24 feat: CI/CD 파이프라인 스크립트 추가 (Jenkins 준비)
    - ci/read_slot.py: CAN 헤더(0x100/0x201)에서 ECU 활성 슬롯 읽기
    - ci/build.sh: 대상 슬롯에 맞는 링커스크립트로 펌웨어 빌드 (CubeIDE 절대경로 패치 포함)
    - tools/ota_client.py: --ecu drive|sensor 옵션 추가 (DriveECU 0x7E0/7E8, SensorECU 0x7E1/7E9)
2026-05-24 feat: Jenkinsfile 추가 - ECU OTA CI/CD 파이프라인
    - 변경된 ECU 자동 감지 (git diff 기반, DriveECU/SensorECU 독립)
    - CAN 헤더(0x100/0x201)에서 활성 슬롯 읽어 비활성 슬롯에 빌드/플래시
    - 빌드 → ECDSA 서명 → UDS/ISO-TP OTA → 슬롯 전환 검증 순차 실행
    - 두 ECU 동시 OTA 금지 (DriveECU → SensorECU 순차)
2026-05-25 feat: 라인트레이싱 → 버튼 트리거 직진+장애물정지 OTA 데모로 기획 전환
    - drive.c: 라인트레이싱 제거, 버튼(B1) 트리거 상태머신으로 재작성
    - v1: 직진 중 10cm 장애물 감지 시 정지
    - v2: 30cm부터 비례 감속, 10cm 정지 (APP_VERSION=2로 OTA)
    - v3: v2 + 정지 후 자동 후진 복귀 (APP_VERSION=3으로 OTA)
    - motor.c: motor_reverse() 추가, motor_stop() 방향핀 초기화 포함
    - main.c(Drive): B1 EXTI NVIC 활성화, CAN 0x200에서 거리값 수신
    - stm32f4xx_it.c: EXTI15_10_IRQHandler 추가 (B1=PC13)
    - SensorECU: 장애물 임계값 APP_VERSION 분기 제거, 10cm 고정
    - docs: diagram.md, rpi5_ssh_unreachable.md, p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
2026-05-25 feat: OTA 활성화를 IDLE 상태에서만 수행하도록 변경 (Uptane 표준 반영)
    - uds.c: TransferExit(0x37)에서 즉시 재부팅 제거 → g_fw_pending=1 세트
    - uds.h: g_fw_pending extern 선언
    - drive.c: DRIVE_IDLE 진입 시 g_fw_pending 감지하면 재부팅 트리거
    다운로드(ExtendedSession~TransferExit)는 주행 중에도 수락하고,
    펌웨어 활성화(재부팅)는 차량이 정지(IDLE) 상태일 때만 실행됨
2026-05-25 docs: 소프트웨어 테스트 명세서 추가 (TS-OTA-001 v1.0)
    ASPICE SWE.4/5/6, ISO 26262-6, ISO 14229-1 참조
    TC 29개: CAN(4) / 주행제어(6) / OTA프로토콜(8) / 보안(4) / 슬롯관리(3) / CI/CD(4)
2026-05-25 docs: SRS v2.0 + diagram 업데이트 — 라인트레이싱 → 버튼 트리거 OTA 데모 반영
    - SRS v1.7 → v2.0: 프로젝트 기획 변경 전면 반영
    - FR-DRV 전면 재작성 (001~008): 라인트레이싱 제거, 버튼 트리거 직진/장애물 회피 v1/v2/v3
    - FR-DRV-007/008: Uptane 지연 활성화 (주행 중 다운로드, IDLE 시 재부팅)
    - FR-SEN-002/004: 장애물 임계값 10cm 단일화 (버전별 15/25cm 제거), 거리값 CAN 전송 명세
    - FR-CICD-007: 다운로드 중 주행 허용, IDLE 활성화 조건으로 변경
    - NFR-SAFE-001: 업데이트 중 주행 금지 → Flash Erase 구간만 정지로 완화
    - TC-NOR-005/006/007: 라인트레이싱 TC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
2026-05-25 refactor: OTA 구조 변경 — RPi5 IDLE 감지 후 플래시, 즉시 재부팅 복원
    [RPi5] tools/ota_client.py
    - ECU_IDS에 heartbeat CAN ID 및 driving_byte 인덱스 추가
    - wait_for_idle() 메서드 추가: CAN 0x100 heartbeat 모니터링,
    driving_state(byte[2])==0 확인 후 OTA 시작 (최대 120초 대기)
    - --idle-timeout CLI 인자 추가 (0이면 즉시 진행)
    - OTAClient.__init__에 self.ecu 저장
    [DriveECU] uds.c
    - g_fw_pending 전역변수 및 uds_init() 초기화 코드 제거
    - RequestDownload(0x34): Flash Erase 전후 g_ota_active=1/0 세트/클리어
    - Default session 복귀(0x10 0x01) 시 g_ota_active=0 클리어
    - RequestTransferExit(0x37): g_fw_pending 대신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
2026-05-25 docs: ADR-001 OTA 활성화 아키텍처 의사결정 문서 추가
2026-05-26 docs: 프로젝트 README 추가 — 시스템 구성, 보안 기능, CI/CD 파이프라인 요약
2026-05-29 docs: docs/etc/ 하위로 파일 정리 및 Uptane 표준 문서 추가
    [부품_구매_목록.xlsx]
2026-05-29 docs: readme 지연 활성화 내용 수정
    [drive.h]
2026-05-29 build: CubeIDE makefile 추적 — Jenkins CI 빌드용
2026-05-29 build: subdir.mk에서 CubeIDE 전용 -fcyclomatic-complexity 옵션 제거
2026-05-29 build: SensorECU subdir.mk에서 -fcyclomatic-complexity 제거
2026-05-29 build: makefile 의존성 줄의 절대경로도 패치
2026-05-29 build: makefile 절대경로 패치 정규식 \S+ → \S* 수정
    [main.c]
2026-05-29 build: .bin 없을 때 objcopy로 직접 변환
2026-05-29 fix: SensorECU isotp send_can CAN TX mailbox 풀 시 재시도
    [isotp.c]
2026-05-29 fix: SensorECU OTA 랜덤 타임아웃 — ISR 내부 printf 블로킹 제거
    HAL_CAN_RxFifo0MsgPendingCallback에서 비-ISOTP 프레임 수신 시
    printf()를 호출하면 HAL_UART_Transmit(HAL_MAX_DELAY)로 ~4ms 블로킹.
    이 구간에 DriveECU 0x100 heartbeat와 OTA CF 버스트(1ms 간격)가
    겹치면 RX FIFO(3슬롯) 오버플로우 → SN 불일치 → ISO-TP 세션 중단.
    비-ISOTP 프레임은 묵시적으로 버린다.
    isotp.c: 이전 세션에서 추가한 ISR 내 10ms 재시도 루프도 함께 롤백
    (ISR 안 블로킹이 동일하게 FIFO 오버플로우를 유발했던 잘못된 시도).
    [isotp.c, main.c]
2026-05-29 fix: SensorECU CAN AutoRetransmission 활성화 — UDS 응답 중재 충돌 시 재전송
    DriveECU 0x100 heartbeat(100ms 주기)와 SensorECU UDS 응답 0x7E9가
    동시에 버스에 올라가면 낮은 ID(0x100)가 중재 승리, 0x7E9는 취소됨.
    AutoRetransmission=DISABLE 상태에서는 ECU가 재전송 없이 포기하므로
    OTA 클라이언트가 응답을 받지 못해 5초 타임아웃 발생 (랜덤 블록).
    트러블슈팅 문서(phase7)에 최종 원인 분석 및 2단계 수정 이력 반영.
    [main.c]
2026-05-29 docs: phase7 트러블슈팅 문서 현행화 — 3차 수정까지 반영, 미해결 상태 명시
2026-05-29 fix: SensorECU OTA 랜덤 타임아웃 — OTA 중 hcsr04 차단, CF 간격 5ms
    TX 메일박스 3개 동시 점유 시 HAL_CAN_AddTxMessage가 HAL_ERROR를 리턴하고
    send_can()이 이를 무시해 UDS 응답이 소실되는 문제.
    hcsr04_measure_cm() 30ms 블로킹 중 TIM3 heartbeat(mailbox[0])와
    obs_data TX(mailbox[1])가 쌓이고, 직전 FC가 DriveECU 중재 패배로
    mailbox[2]에서 재전송 대기 중일 때 isotp_send()가 실패하는 시나리오.
    - uds_ota_active() 추가: g_state == STATE_DOWNLOADING일 때 1 리턴
    - main.c: OTA 중 hcsr04 측정 및 obs_data TX 차단
    - ota_client.py: CF 간격 1ms → 5ms
    [main.c, ota_client.py, uds.c, uds.h]
2026-05-29 docs: phase7 트러블슈팅 해결 완료 — SlotB 부팅 확인
2026-05-29 fix: build.sh make clean 추가 — 증분 빌드 캐시 오염 방지
    [ota_client.py, uds.c]
2026-05-29 ci: SensorECU OTA cf-delay 0.005으로 변경 — 실패 임계값 탐색
2026-05-29 docs: OTA 트러블슈팅 문서 추가 및 업데이트
    - phase8 신규: SlotA OTA 실패 후 하트비트 없음 (ISS-OTA-005) — 소거와 메타데이터 무효화 비원자성 원인 분석
    - phase7 업데이트: hcsr04 가설 약화, CF 간격이 실제 원인일 가능성 반영
2026-05-29 docs: 구현계획 phase 재구성, 트러블슈팅 문서 명칭 일관성 정렬
    구현 현황과 불일치하던 phase 구조 전면 수정:
    - Phase 5A/5B → Phase 5 (RPi5 + ECDSA 통합)
    - Phase 6B → Phase 6 (SensorECU OTA)
    - Phase 5C → Phase 7 (Jenkins CI/CD)
    - Phase 8: CI/CD 파이프라인 통합 테스트 (현재 진행 중, ISS-OTA-004/005 포함)
    - Phase 9: RC카 + DriveECU 앱 v1/v2/v3 (구현 완료)
    - Phase 10: 예외 시나리오 + 단위 테스트
    - Phase 11: 통합 테스트 + 시연 영상
    트러블슈팅 문서 rename:
    - phase6_rc_car_assembly → phase9_rc_car_assembly (RC카 = Phase 9)
    - phase7_sensorECU_ota_random_timeout → phase8_sensorECU_ota_random_timeout (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
2026-05-29 docs: 구현절차.md 삭제 (구현계획.md로 대체)
2026-05-29 fix: SensorECU Makefile에서 -fcyclomatic-complexity 제거 — 표준 arm-none-eabi-gcc 호환
2026-05-29 test: Ceedling 단위 테스트 초기 설정 — SensorECU UDS 상태 머신 테스트 기반 구축
    - project.yml: Ceedling 0.31.1 설정 (경로, CMock, 플래그)
    - test/support/stm32f4xx_hal.h: HAL 타입 스텁 (호스트 빌드용)
    - test/support/hal_stubs.c/h: HAL 함수 스텁 + 테스트 제어 전역 변수
    - test/unit/test_uds_state.c: smoke test (1 PASS 확인)
2026-05-29 test: UDS 상태 머신 단위 테스트 작성 (TC-UT-UDS-001~003) — 11개 PASS
    - Session Control, SecurityAccess, RequestDownload, TransferData
    정상 흐름 및 NRC 응답 검증
    - 커버 요구사항: FR-CAN-009/010/011/012/016
2026-05-29 test: TC-UT-BL-001~008 부트로더 슬롯 선택 단위 테스트 추가
    bootloader_select_boot_addr() 추출 — UNIT_TEST 가드로 ARM 의존성 분리,
    bootloader_run()은 추출 함수를 호출하도록 리팩터링.
    project.yml에 Bootloader 소스/헤더 경로 및 -DUNIT_TEST 플래그 추가.
    총 19개 테스트 통과 (UDS 11 + Bootloader 8).
2026-05-29 fix: CAN Bus-Off 자동 복구 활성화 (ISS-OTA-005)
    OTA timeout 후 host bus.shutdown() 시 ACK 없는 TX 시도로
    TEC가 급증해 Bus-Off 진입, AutoBusOff=DISABLE로 영구 불능
    상태가 되어 이후 heartbeat가 수신되지 않던 문제 수정.
    [main.c]
2026-05-29 test: TC-UT-META-001~009 OTA 메타데이터 단위 테스트 추가
    ota_flash.c에 UNIT_TEST 가드로 META_PTR 추상화 추가 —
    호스트 테스트 시 0x08008000 대신 정적 버퍼 사용.
    ota_flash.h에 OTA_Metadata_t 구조체 및 테스트 헬퍼 선언 추가.
    총 28개 테스트 통과 (UDS 11 + Bootloader 8 + OTA Meta 9).
2026-05-29 ci: OTA 반복 통합 테스트 스크립트 추가 (ota_stress_test.py)
    AutoBusOff=ENABLE 패치 검증 및 타임아웃 임계값 탐색용.
    블록별 소요 시간 측정, 실패 후 CAN 생존 여부 확인,
    N회 반복 요약 리포트 기능 포함.
2026-05-29 feat: ota_stress_test에 자동 빌드+서명 통합 (--key 인수)
    --key <pem> 지정 시 ci/build.sh + sign_firmware.py를 내부적으로
    호출하여 SlotA/B 펌웨어를 빌드하고 서명한 뒤 테스트를 진행한다.
    기존 --fw-a/--fw-b는 사전 빌드된 파일이 있을 때 그대로 사용 가능.
2026-05-29 fix: wait_for_slot 2-phase로 수정 — 호스트 CAN Bus-Off 방지
    uds.c TransferExit 처리 흐름:
    ota_meta_write_pending → isotp_send(0x77) → HAL_Delay(100) → NVIC_SystemReset
    ECU는 NVIC_SystemReset 직전 HAL_Delay(100) 중에 heartbeat를 한 번 더
    전송한다. 기존 wait_for_slot은 이 '리셋 직전 heartbeat'를 즉시 수신하여
    반환했고, 다음 iteration이 부트로더 실행 중(CAN 비활성)에 UDS 요청을
    전송하면서 호스트 CAN TEC가 Bus-Off 임계값(255)을 초과했다.
    수정: Phase1에서 heartbeat가 500ms 이상 끊길 때까지 대기(ECU 실제 리셋
    확인)한 뒤 Phase2에서 재부팅 완료 후 target slot heartbeat를 탐지한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
    [isotp.c, isotp.h, main.c, ota_stress_test.py, uds.c]
2026-05-29 fix: always regenerate slot bin from elf
2026-05-29 feat: test_all.py — 단위 테스트 + 3회 OTA 통합 테스트 일괄 실행
    ci/test_all.py 추가: ceedling test:all (Phase 1) → DriveECU/SensorECU 반복 OTA (Phase 2)를
    단일 명령으로 실행. README에 테스트 가이드(사전 준비, 옵션 표) 추가.
2026-05-29 fix: ceedling 미설치 시 FileNotFoundError 대신 명확한 오류 출력
    [test_all.py]
2026-05-29 fix: Ruby 미설치 환경 안내 추가 (ruby-full → gem → PATH)
    [test_all.py]
2026-05-29 fix: 최신 Ceedling 호환 — Ceedling.load_path 제거
2026-05-29 fix: 최신 Ceedling 호환 — use_test_preprocessor :all, 구버전 플러그인 제거
2026-05-29 fix: OTA 로그에서 슬롯 번호(0/1) → 문자(A/B) 표시
    [test_all.py]
2026-05-29 feat: 빌드 로그 억제, 최종 결과에 단위 테스트 요약 포함
2026-05-29 fix: ceedling 요약 파싱 — stderr 포함, 정규식으로 강건하게 처리
    [test_all.py]
2026-05-29 feat: demo_ota.py — --versions 인수로 v1/v2/v3 버전 지정 OTA 시연, README 가이드 추가
2026-05-29 fix/docs: Jenkinsfile DRIVE_CHANGED 버그 수정, git push OTA 시연 가이드 추가
2026-05-29 chore: IR 센서 핀 제거 (CubeMX 재생성), SensorECU 빌드 설정 업데이트
    [부품_구매_목록.xlsx]
2026-05-29 fix: sleep 10 제거 — read_slot.py --wait-reboot으로 재부팅 완료 감지
    [read_slot.py]
2026-05-29 fix: 구버전 arm-none-eabi-gcc 호환 — -fcyclomatic-complexity 빌드 전 제거
2026-05-29 tune: 주행 속도 감소 및 감속 구간 확장
    BASE_SPEED 600→400, SLOW_SPEED 300→200, FORWARD_MS 3000→6000ms, SLOW_DIST_CM 30→60cm
2026-05-29 tune: BASE_SPEED 500, SLOW_SPEED 280으로 조정 — 모터 기동 토크 확보
2026-05-29 fix: 소프트 스타트 및 트림 오프셋으로 직진 쏠림 보정
    출발 시 랜덤하게 좌우로 쏠리는 문제를 해결.
    400ms 동안 SLOW_SPEED → BASE_SPEED로 선형 램프업하여 기동 불균형을 줄이고,
    TRIM_L/TRIM_R 상수로 잔여 쏠림을 미세 보정할 수 있도록 함.
    [drive.c]
2026-05-29 fix: 킥 스타트로 출발 직후 쏠림 개선
    출발 순간 25ms 동안 KICK_SPEED(850)를 인가해 양쪽 모터가
    정지 마찰을 동시에 극복하도록 하고, 이후 500ms 램프업으로 부드럽게 정속 진입.
    [drive.c, drive.h]
2026-05-29 tune: BASE_SPEED 720, SLOW_SPEED 400으로 상향 — 모터 선형 안정 구간 진입
    PWM 500 구간에서 양쪽 바퀴 속도가 매번 달라지는 비선형 코깅 현상 발생.
    속도를 높여 모터가 안정적인 선형 구간에서 동작하도록 조정.
2026-05-29 tune: BASE_SPEED 999(최대), SLOW_SPEED 500(절반)으로 조정
2026-05-29 ci: 젠킨스 파이프라인 트리거
2026-05-29 Improve straight-line driving stability
    [drive.c, drive.h]
2026-05-29 refactor: v2=감속+정지 제거, v3→v2(직진+정지+자동후진)로 재편
    시연 구성 변경: v1(직진+즉시정지) → v2(직진+자동후진복귀)
    감속 로직은 v2에서 제외, 장애물 감지 즉시 정지 후 후진만 수행.
2026-05-29 ci: UDS 전송 전후 CAN 상태 및 전송 중 candump 로깅 추가
2026-05-29 ci: 빌드 전 cppcheck 정적 분석 스테이지 추가
    변경된 ECU(DriveECU/SensorECU)의 Core/Src만 검사하며,
    error 등급 이상 발견 시 파이프라인을 중단한다.
2026-05-29 ci: 단위 테스트 스테이지 추가 — 미통과 시 빌드·OTA 차단
2026-05-29 docs: App v3 제거, 자동 후진 복귀를 v2로 통합 반영
2026-05-29 docs: 직진 주행 방향 불규칙 문제를 미해결 과제로 문서화
2026-05-29 docs: README 전면 정리 — 포트폴리오 GitHub 링크용 가독성 개선
2026-05-30 feat: test_all.py 로그 개선 — 단위 테스트 개별 결과 실시간 출력 및 라운드별 소요 시간 표시
2026-05-30 fix: DriveECU CAN AutoBusOff·AutoRetransmission 비활성화 — 부트로더 연동 후 CAN 불통 수정 및 원인 격리 문서 추가
    - AutoBusOff ENABLE → DISABLE, AutoRetransmission ENABLE → DISABLE
    - PRIMASK/VTOR 원인 격리 실험 결과 문서화 (primask_vtor_root_cause_isolation.md)
    - 로컬 CubeIDE 디버그 환경 설정 가이드 추가 (local_cubeide_debug_setup.md)
    - phase4 문서에서 포트 혼동 단계 제거 및 단계 번호 정리
    [main.c]
2026-05-31 chore: Debug 빌드 아티팩트 추적 제거 및 .gitignore에 Debug/ 추가
2026-06-01 feat: 출발 프로파일 강화 — 간헐적 출발 불발 개선
    킥을 최대 출력(999)·250ms로 늘려 정지마찰을 확실히 깨고, 킥 이후
    홀드/램프 시작 출력을 SLOW_SPEED(400) 대신 LAUNCH_FLOOR(620)로 올려
    적재 상태 구름저항 아래로 떨어져 스톨하던 문제를 방지.
2026-06-02 feat: SecurityAccess 고정 XOR→HMAC-SHA256(PSK,Seed) + A/B 슬롯·보안 요구 강화
    SecurityAccess:
    - 고정 XOR(key=seed^const)를 HMAC-SHA256(PSK, Seed)[0:4] 챌린지-응답으로 교체
    (양 ECU uds.c, 게이트웨이 ota_client.py)
    - 3회 Key 실패→NRC 0x36, 10초 잠금→NRC 0x37 (RAM 기반, ISO 14229)
    - seed는 소프트웨어 nonce(F446 무TRNG: UID+tick+ctr→SHA256)
    - crypto: sha256/hmac_sha256 앱 포팅(RFC 2104), 단위테스트 test_hmac(RFC4231)·test_uds_state(unlock+잠금)
    - PSK 32B를 WRP 부트로더 0x08007FE0(.psk 섹션)에 배치, 앱이 read (SR-KEY-003)
    요구사항 강화(적대적 질문 리뷰):
    - SRS §7.3 A/B Slot 재작성(슬롯 5상태 lifecyc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
2026-06-02 docs: 트러블슈팅 8D 헤딩·MADR 템플릿화 + 파일명 ISS/EXP 규칙 정립(ADR-005)
    - 트러블슈팅 결함보고서 헤딩을 8D(D2 문제정의·D4 RCA·D5–6 시정&검증·D7 재발방지)로 정렬
    - 템플릿 추가: docs/troubleshooting/_TEMPLATE.md(8D-lite), docs/adr/_TEMPLATE.md(MADR)
    - 파일명을 ISS-<영역>-<NNN>_<slug> / EXP-<NNN>로 통일(ADR-005): 9개 git mv(이력 보존),
    ID 부여(phase4→ISS-BL-001, phase5A→ISS-BL-002, primask→EXP-001),
    참조 갱신(docs/etc/구현계획.md + 문서 간 상호참조), README 링크 갱신
2026-06-02 docs: ADR-006 Secure Element(ATECC608A) 도입 결정 + ADR-003/004 역참조
2026-06-02 build: DriveECU SlotB에 sha256/hmac_sha256 등록 — Slot B OTA 펌웨어 crypto 링크
2026-06-03 docs: 문서 정합성 패스 — SRS(v2.5) 기준 핵심 4종 일치 (D1~D6)
    SRS를 단일 진실원천(SSOT)으로 README·TEST_SPEC·diagram 간 변경 드리프트 해소.
    - D1 SecurityAccess XOR 잔재 → HMAC-SHA256(PSK,Seed)[0:4] (TEST_SPEC·diagram)
    - D2 TEST_SPEC 추적성: 28개 §참조 + RTM 표 → FR/SR 요구 ID (섹션 이동에 안 깨짐)
    - D3 SRS 파일명 버전표기 제거(SRS-001_CAN_Secure_OTA_Pipeline.md) — 버전은 개정이력에만
    - D4 WRP 영역 FR-BL-013·SR-KEY-001 "Sector 0~4"→"0~1"
    (0~4는 Metadata·Slot A까지 잠가 OTA 불가, §14.2와 모순 해소)
    - D5 메타데이터 이중화(섹터2·3+CRC32+seq)를 README·TEST_SPEC 메모리맵에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
2026-06-03 docs: SRS §7.4 UDS 프로토콜 요구 강화(v2.6) — FR-CAN HMAC 정합·endless-data·S3 타임아웃·RDBID 신설
    적대적 질문 Round 2(ISO 14229/15765/24089 근거)로 §7.4 강화:
    - FR-CAN-009: programmingSession 0x02 명시
    - FR-CAN-010: HMAC(key=PSK,msg=Seed)·소프트웨어 nonce로 정합(§13.6/ADR-004 일치)
    - FR-CAN-011: ecu_id·hardware_id·version fail-fast 거부
    - FR-CAN-012: endless-data 누적상한 → NRC 0x31 (SR-ATK-007)
    - FR-CAN-013: 수신완료(==image_size) 검증
    - FR-CAN-014: fail-closed — Verify 통과해야 UPDATED (FR-AB-003)
    - FR-CAN-017: 세션 nonce(session_id) 기반 replay 방어
    - FR-CAN-018(신설): RDBID 0x22 ECU Inventory (SR-UP-001)
    - FR-C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
2026-06-03 feat: Boot Metadata 이중화 — 섹터2·3 redundant + CRC32 + seq 원자적 갱신 (FR-AB-005)
    - ota_meta.c/h(SSOT): 구조체에 seq_counter+crc32 추가, 소프트웨어 CRC-32(zlib),
    ota_meta_valid/select(CRC유효·seq최대 선택). 부트로더·양 ECU 복사 → 구조체 일원화로 드리프트 해소
    - 부트로더 read: 섹터2·3 두 사본 load → ota_meta_select → 부팅(없으면 default/safe)
    - 앱 write: 현재본의 반대 사본에 seq+1로 기록, CRC를 마지막 워드로 → 활성 사본 보존
    (원자적 commit, 전원차단 torn-write 방어)
    - ota_flash.h 슬림화(메타 로직→ota_meta.h) → CMock 안전(test_uds_state 무영향)
    - 검증: 단위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
2026-06-03 feat: self-test commit + 3-strike 롤백 (FR-AB-004/007) + 슬롯 5상태
    - 슬롯 5상태(INVALID/UPDATING/UPDATED/TRIAL/CONFIRMED): SLOT_PENDING→UPDATED/TRIAL 분리(§7.3.1 실코드화)
    - ota_meta_plan_boot(순수): UPDATED→TRIAL(count=1)·증가-먼저-점프·3회 초과 시 INVALID+이전 CONFIRMED 롤백
    - ota_meta_plan_confirm(순수): self-test PASS 시 TRIAL→CONFIRMED, count=0
    - 부트로더: plan_boot 호출 + bl_meta_commit(ping-pong HAL 쓰기)로 점프 전 전이 커밋
    - 앱: write_pending→UPDATED, main.c self-test(main 도달+CAN init+heartbeat 송신 성공)→ota_meta_self_confirm
    (ISR선 플래그만 세우고 flash 쓰기는 메인루프)
    - 문서: SRS §13.3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
2026-06-03 docs: ADR-006 해결 매핑 정정 — 잠금·anti-rollback·seed는 서로 다른 약점
    - 실패 원인(난수성/휘발성/변조) 열 추가 — ATECC608A가 한 문제를 한 번에 푸는 게 아니라
    서로 다른 약점을 각기 다른 기능으로 막음을 명시
    - anti-rollback rollback-index 행 추가 (FR-BL-008/ADR-007 연결)
    - ATECC608A는 저장한 값만 보호 — 메타 전체 무결성은 별도 MAC 필요(CRC≠변조방지) 명시
    - 관련 요구사항 FR-BL-008·SR-ATK-003·ADR-007 연결
2026-06-03 feat: anti-rollback 다운그레이드 거부 (FR-BL-008/FR-AB-008, ADR-007)
    - 앞 서명 헤더(MCUboot 정석): [헤더0x200][코드][ECDSA서명64], 서명이 (헤더+코드)를 덮음
    → fw_version 위조 불가, 실행 전 검증
    - ota_meta: OTA_ImgHeader_t + ota_img_header_read(offset 0) + ota_meta_version_allowed(순수)
    - sign_firmware.py: --version/--ecu-id로 0x200 앞 헤더 prepend + (헤더+코드) 서명 + 자가검증
    - 링커 4종(Sensor/Drive×A/B): FLASH origin +0x200, length -0x200 (앱 벡터테이블 = slot+0x200)
    - 부트로더: 점프/유효성검사 +IMG_HEADER_SIZE, ECDSA 후 헤더 fw_version을 메타 CONFIRMED
    버전과 비교해 다운그레이드 거부. VT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
2026-06-03 fix: ECDSA 검증 게이팅 fail-closed — size==0 서명검증 우회 차단 (FR-AB-003)
    기존 부트로더는 메타 size가 비정상(0/초과/0xFFFFFFFF)이면 ECDSA 검증을
    '건너뛰고 그대로 부팅'(fail-open) → 공격자가 size=0으로 위조하면 미서명
    코드가 부팅되어 ECDSA·anti-rollback이 통째로 무력화됨(CWE-636).
    - bootloader_verify_decision(순수): 메타 유효+size 정상→REQUIRED, 메타 부재
    (factory/ST-Link 미서명)→SKIP, 메타 유효+size 비정상→REFUSE
    - bootloader_run: REFUSE → safe_state(부팅 거부). 검증 '우회'가 아니라 '부팅 불가'
    (size==0이면 검사 자체가 불가능 → deny-by-default, ISO 24089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
    [bootloader.c, bootloader.h, test_bootloader_slot.c]
2026-06-04 feat: 센서 staleness fail-safe — Sensor 침묵 시 Drive 정지 (ISO 26262 안전상태)
    기존 DriveECU는 0x200 수신 시 g_obstacle_flag만 갱신할 뿐 '언제 받았는지'를
    보지 않아, Sensor가 죽으면 마지막 "장애물 없음"을 믿고 눈 감고 돌진(안전 구멍).
    - drive.h: 순수 inline drive_sensor_fresh(seen, now, last_rx, timeout) —
    미수신(seen=0) 또는 age>timeout 이면 stale. unsigned 뺄셈으로 tick wrap 안전
    - main.c 0x200 RX: drive_note_sensor_rx()로 수신 시각 기록
    - drive_update 진입 시 stale면 force_stop + IDLE (침묵=장애물로 간주, fail to safe)
    → 첫 프레임 받기 전(미수신)에도 출발 금지, 주행 중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
    [drive.c, drive.h, main.c]
2026-06-04 docs: HIL-001 실보드 테스트 플랜 — anti-rollback/3-strike/fail-closed/staleness
    호스트 단위테스트(논리)가 못 잡는 통합/하드웨어 동작을 실보드에서 검증하는
    ASPICE SWE.6 형식 테스트 플랜. 관측점(CAN heartbeat 0x100/0x201=버전·슬롯,
    부트로더 UART 로그)과 자극(OTA 푸시·ST-Link 메타 위조·센서 분리)을 정의.
    - TC-00 정상 OTA+self-test commit, TC-01 anti-rollback(+상위허용 대조),
    TC-02 3-strike 롤백(고장앱 4사이클), TC-03 fail-closed(size=0 위조),
    TC-04 센서 staleness(+시동 stale 대조) — 각 전제·절차·기대로그·합격기준
    - 추적 매트릭스(요구사항↔단위테스트↔H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
2026-06-04 feat: 부트로더 boot event 로그 + anti-rollback graceful fallback (HIL 관측성)
    HIL-001 작성 중 발견한 관측성/견고성 갭 2개 개선.
    [갭1] 3-strike 등 부팅 결정이 로그로 구분 안 됨
    - ota_meta_plan_boot이 OTA_BootEvent_t(TRIAL_START/TRIAL_RETRY/ROLLBACK/
    FALLBACK/CONFIRMED/FACTORY/SAFE)를 반환(순수, SSOT 3사본)
    - 부트로더가 사유별 로그: "trial start/retry: slot N (attempt M)",
    "3-strike: slot N reached limit -> INVALID, rollback" 등
    - test_meta_lifecycle에 event 검증 추가(8 tests)
    [갭2] anti-rollback 거부 시 halt(safe_state) → 가용성 저하
    - 거부 시 거부 슬롯 INVALID 마킹 + 이전 CONFIRMED로 active 전환 + r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
2026-06-04 test: HIL 픽스처 — forge_meta.py(위조 메타) + 고장앱 define(HIL_SELFTEST_FAIL)
    HIL-001 TC 실행에 필요한 테스트 픽스처(항목 2) 제작.
    - tools/forge_meta.py: OTA_Metadata_t(SSOT) + CRC32(zlib/ISO-HDLC) 재현 →
    ST-Link 주입용 44B 메타 블롭 생성. preset size0-attack(TC-03 fail-closed),
    confirmed-a/b + 수동 필드. CRC가 부트로더 bit-reflected 구현과 일치 검증
    - main.c(양 ECU): #ifdef HIL_SELFTEST_FAIL — main 루프 진입 직후 hang →
    IWDG 리셋 → self-test 미통과(TC-02 3-strike 픽스처). production 기본 OFF
    - HIL-001 §2 픽스처를 실제 명령(sign_firmware --version / forge_meta /
    -DHIL_SELFTEST_FAIL)으로 구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
    [forge_meta.py, main.c]
2026-06-04 test: HIL 오케스트레이션 hil_runner.py — 자극→관측→판정 자동화
    HIL-001 TC를 실보드에 반자동 실행. 기존 도구 재사용(ota_client.py OTA,
    forge_meta.py 메타 위조). 물리 동작(전원·센서 분리·버튼)은 운영자 프롬프트.
    - 관측: CanHeartbeat(0x100/0x201 → ver,slot) + SerialLog(UART 로그 wait_for)
    - 자극: ota_push / forge_inject(+st-flash) / st_reset / manual 프롬프트
    - TC-01 anti-rollback, TC-02 3-strike, TC-03 fail-closed, TC-04 staleness
    → 로그·heartbeat 자동 대조로 PASS/FAIL 판정
    - 순수 파싱(decode_heartbeat·LogBuffer)을 분리, `--selftest`로 하드웨어 없이 검증
    - 검증: python hil_runner.py -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
    [hil_runner.py]
2026-06-04 test: HIL 한 줄 실행 자동화 — build_fixtures.sh + hil_runner --build/--setup
    수동 다단계(빌드·서명·플래시·베이스라인)를 스크립트로 박제해 1~2 명령으로 축소.
    - tools/build_fixtures.sh <ecu>: 정상 v1/v2/v3 + 고장앱(HIL_SELFTEST_FAIL,
    임시 #define 후 원복)을 한 번에 빌드·서명 → fixtures/<ecu>_v*_<slot>.bin
    - hil_runner: --build(픽스처 빌드) / --setup(부트로더+베이스라인 v2 플래시,
    known-state 멱등) / --ecu / --uart 추가 → 한 줄 실행:
    python tools/hil_runner.py --ecu drive --build --setup --all --can slcan0 --uart /dev/ttyUSB0
    - TC 픽스처 파일명을 build_fixtures 산출물과 정합(<ecu>_v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
    [hil_runner.py]
2026-06-04 test: hil_runner — Mac 단일 오케스트레이션 지원(--ota-cmd, --can 옵션화)
    장치 분리 배선(ST-Link·UART=Mac, CAN=Pi) + 운영 ngrok OTA 경로에 맞춤.
    Mac 한 점에서 자극·관측·판정: 플래시(로컬 ST-Link) + 관측(로컬 UART) +
    OTA 자극(--ota-cmd로 운영 경로 재사용). test-like-you-operate(전달 파이프라인까지 end-to-end).
    - --ota-cmd "<템플릿>": {img},{ecu} 치환해 OTA 푸시 명령 실행
    (예: curl -F fw=@{img} https://X.ngrok.io/ota/{ecu}) → ngrok→Pi 게이트웨이 재사용
    - --ota-remote: 수동 프롬프트(다른 머신서 푸시) 대안
    - --can 옵션화(default None): 없으면 heartbeat 생략, UART 로그로 판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
2026-06-04 fix: HIL 도구 python3 사용 — build_fixtures.sh + hil_runner 안내문
    일부 macOS는 `python`이 없고 `python3`만 있어 `--build`가 실패할 수 있음.
    - build_fixtures.sh: sign 호출을 ${PYTHON:-python3}로
    - hil_runner 안내문(docstring) 명령 예시를 python3로
    - (subprocess 내부는 이미 sys.executable라 호출 인터프리터 따라감)
    [hil_runner.py]
2026-06-04 fix: hil_runner — can=None close 크래시 + st-flash 실패 가시화 + --st-serial
    - finally에서 can(None)일 때 close() 호출하던 AttributeError 수정
    - sh()가 실패 시 exit코드+출력을 노출(st-flash 충돌·보드 미인식 진단)
    - stflash() 헬퍼 + --st-serial: 보드 2개 동시연결 시 ST-Link 타깃 지정
    - st_reset(cfg) 시그니처 정리
    [hil_runner.py]
2026-06-04 feat: OTA 파이프라인 CI/배포 분리 — 태그 릴리스 + Pi 승인 게이트
    git push는 단위테스트·정적분석·컴파일 검증까지만 수행하고 ECU를 건드리지 않는다. 실제 배포는 vN 릴리스 태그 + Jenkins input 승인 게이트를 통과한 뒤에만 일어난다(Pi에서 명시적 배포 결정). 태그 숫자는 sign_firmware.py --version으로 주입돼 anti-rollback 기준선이 된다(ADR-007 연계).
    - Jenkinsfile: Detect/Unit/Static/Compile(push) | Build&Sign/Approve/Deploy(release tag)
    - ADR-008: CI vs Deployment 분리 결정 기록(UN R156 SUMS, Uptane Image/Director, ASPICE)
    - README: ADR 인덱스 갱신(007·008)
2026-06-04 docs: ADR-001 — 옵션 C(게이트웨이 IDLE 감지) 유지 재확인 + 근본원인 검토
    대화 기반으로 옵션 C 결정을 ADR에 반영. §6 후속 검토 추가:
    - 옵션 D(RAMFUNC), 옵션 E(dual-bank RWW)로 Erase 블로킹 근본 해결 가능하나
    single-bank F446 + 데모 범위에선 옵션 C 유지가 합리적(시간적 분리, ISO 26262).
    - deferred activation(g_fw_pending) 개념 자체는 유효 — Erase가 안전해지면 부활.
    - ECU 측 RequestDownload 전제조건 거부(NRC 0x22)를 보강 과제로 명시.
    - 정합성 메모: SRS FR-DRV-008/FR-CICD-007·TEST_SPEC·diagram의 옵션 B 잔재는
    본 ADR(정본)과 어긋나며 baseline 정합화는 별도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
2026-06-04 test: hil_runner — ECU UART 로그를 터미널에 실시간 echo
    판정 결과만 찍던 것 → SerialLog가 읽은 [BL]/[DRIVE] 로그를 "uart|" 접두로
    실시간 출력. 투명성·디버깅 향상(별도 시리얼 모니터 불필요, 포트는 점유 중).
2026-06-04 fix: DriveECU CAN RX ISR의 [RX] printf 제거 — UART 폭주/로그 손상 차단
    수신 콜백(ISR)에서 매 프레임 [RX] printf → 센서 0x201 하트비트로 UART 폭주 +
    printf 재진입으로 [BL]/[UDS] 로그가 깨져 HIL 관측 불가(TC-02 trial/3-strike
    로그를 매칭 못함). 미처리 프레임은 조용히 무시(ISR에서 blocking printf 금지).
    [main.c]
2026-06-04 docs: HIL-001 §6 실행기록 — 핵심 4종 실보드 PASS(2026-06-04)
    TC-01 anti-rollback / TC-02 3-strike / TC-03 fail-closed / TC-04 staleness
    전부 PASS. 관측 로그·환경(Mac ST-Link/UART, Pi can0, scp+ssh OTA) 기입.
2026-06-04 docs: HIL-001 — on-target 벤치 테스트임을 명시(엄밀한 plant-sim HIL과 구분)
    제목/레벨을 on-target 벤치로 정정 + 용어 주의 추가: 실 ECU+실물 환경(실 CAN·
    모터·게이트웨이)으로 수행한 on-target 시스템 테스트이며, plant를 실시간 시뮬레이션하는
    교과서적 HIL과 구분됨. 문서 ID는 통용 약칭.
2026-06-04 docs: SDD-001 SW 설계서 — SAD/SDD 통합본(SWE.2 아키텍처 + SWE.3 상세설계)
    SRS-001 요구사항이 어떤 설계로 실현됐는지 기술.
    - SWE.2 아키텍처: 컨텍스트·메모리맵·레이어·컴포넌트 인터페이스(provided/required,
    내부 API + 외부 CAN/UDS)·리소스/타이밍 예산·동적행위·ADR 대안평가
    - SWE.3 상세설계: 모듈·데이터(메타·5상태·이미지헤더·BootPlan)·핵심 알고리즘
    (부팅·OTA·self-test·3-strike·staleness)
    - 요구사항↔설계↔코드↔테스트 추적성 매트릭스
    - 검증: 단위 61 + gcc 6 + on-target HIL 4(전부 PASS)
    규모상 SAD/SDD를 한 문서로 통합(IEEE 1016), 레벨은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
2026-06-05 docs: HARA-001·TARA-001 분석 + ISS-CAN-005(스코프 CAN 디코드 8D) + 포트폴리오 자산
    병행 작성한 안전(HARA)·위협(TARA) 분석, 오실로스코프 CAN 디코드 트러블슈팅(8D),
    구성 사진/PPT/부품목록을 트래킹에 추가. (빌드/IDE 노이즈는 제외)
    [부품_구매_목록.xlsx, 부품구매목록.xlsx]
2026-06-05 build: Ceedling gcov 커버리지 측정 활성화
    :plugins:에 gcov 추가 + :defines/:flags의 :gcov: 컨텍스트에 UNIT_TEST 부여
    (gcov 빌드가 HAL 블록을 컴파일하지 않도록). `ceedling gcov:all`로 재현.
    측정: 라인 ~87%·브랜치 ~94%(호스트 검증 가능 핵심 로직; HAL 경로는 HIL 보완).
2026-06-05 test: uds.c 음성 테스트 13개 추가 — 거부 분기 보강
    미탐 거부 경로 보강: NRC 0x11(미지원 SID)·0x12(미지원 subfunc)·0x13(길이부족)·
    0x22(상태밖 0x36/0x37)·0x31(RequestDownload size=0/초과/포맷)·0x72(erase/write 실패)
    + TransferData 성공 경로(0x76). 보안 관련 endless-data/oversized 방어 음성검증.
    커버리지: uds.c 분기 60.5%→81.6%·라인 77%→89%. 전체 라인 87→92%·분기 73→81%.
    단위테스트 61→74. (ota_flash_write는 :ignore 플러그인의 IgnoreAndReturn 사용)
2026-06-05 docs: README 개편 — KPI 대시보드·서사·검증 섹션 + 보안 테이블 구현상태 정정
    - 상단 KPI(보안6·안전1·테스트74·라인92%·분기81%·HIL 4/4·산출물·규모) + 프로젝트 서사
    - OTA 보안 테이블을 *구현 상태*로 정직 표기(✅구현+HIL / 🔶부분 / ⬜계획) —
    미구현(Replay·Uptane)을 구현된 것처럼 적던 과장 제거(문서-코드 갭 정정)
    - SecurityAccess 표기 정정: HMAC-SHA256(PSK, Seed) (구 'Seed‖PSK' 오류)
    - 검증(Verification) 2단계 섹션: 단위(커버리지) + on-target HIL 4종 PASS(실물환경 명시)
    - 문서 인덱스에 SDD-001·HARA-001·TARA-001·HIL-001 링크 추가
    - 테스트 실행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
2026-06-05 docs: README — CI/배포 분리 + 명시적 승인 게이트 반영 (ADR-008)
    시스템 구성도·Jenkins 섹션이 옛 "push=자동배포"로 남아있던 것을 실제 구현
    (Jenkinsfile: CI는 모든 push, 배포는 태그 vN + input 승인 게이트 + IDLE 후 전송)에
    맞춰 정정. UN R156 SUMS 승인·Uptane Image/Director 분리 근거 명시.
2026-06-05 docs: README 정합성 정정 — Jenkins 시연·디렉터리·Flash맵
    검토 후 정정:
    - Jenkins 시연이 'push→배포'로 ADR-008(push=CI/태그+승인=배포)과 모순 → 2단계
    (push=CI, tag vN=빌드·서명·input승인·IDLE대기·OTA)로 정정
    - 디렉터리 구조에 HIL 도구(forge_meta·build_fixtures·hil_runner)·새 문서
    (SDD/HARA/TARA/HIL/troubleshooting)·project.yml 반영(outdated 해소)
    - Flash맵에 앱 벡터=slot+0x200(앞 서명 이미지 헤더, ADR-007) 표기
    - (확인) IDLE 감지는 ota_client.wait_for_idle로 실제 구현됨 — 과장 아님
2026-06-05 docs: diagram.md §5 보안·안전 흐름 다이어그램 추가
    기존 다이어그램(해피패스·구 부트로더 모델)에 빠진 보안/안전 흐름을 보강:
    - 5.1 부팅 결정+검증 게이팅(plan_boot 5상태 → verify_decision fail-closed →
    ECDSA → anti-rollback) 플로차트
    - 5.2 anti-rollback 거부 시퀀스(다운그레이드 차단)
    - 5.3 슬롯 5상태 생명주기 + 3-strike 롤백 상태도
    - 5.4 센서 staleness fail-safe 플로차트
    각 흐름에 대응 HIL TC(01~04) 표기. README diagram 링크 설명 갱신.
2026-06-05 docs: 1-Page 포트폴리오 요약 + 데모 영상 링크
    - docs/PORTFOLIO_ONEPAGER.md: 면접/이력서용 1페이지 — 한줄·KPI·기능↔표준↔검증·
    검증전략(V모델 양방향)·핵심 ADR·엔지니어링 스토리·기술스택
    - README 상단에 데모 영상(YouTube) 클릭 썸네일 + 문서 인덱스에 원페이저 링크
2026-06-05 docs: 문서 정합성 패스 — 테스트 수 61→74·uds 12→25 동기화, 커밋수 갱신
    SDD-001: test_uds_state(12)→(25), 호스트 단위테스트 61→74개(라인 92%·분기 81% 커버리지 명시)
    HIL-001: 호스트 단위테스트(61개)→(74개)
    README: 규모 125→130+ commits
    SRS v2.9 개정이력의 누적 61은 해당 개정 시점 기록이므로 유지.
    타이밍(IWDG 8000ms·잠금 10s·staleness 150ms·S3 5000ms)·메모리맵·HMAC(PSK,Seed)·ADR×8·8D×10 전 문서 일치 확인.
2026-06-05 feat: ECU 식별 강제 — 타 ECU용 이미지 OTA 거부(FR-CAN-011)
    서명 헤더 target_ecu_id가 정의·서명만 되고 아무도 거부하지 않던 갭(README 🔶) 해소.
    - 앱 컴파일타임 ID: OTA_ECU_ID(Drive=1/Sensor=2)를 uds.c에 정의
    - RequestTransferExit(0x37)에서 헤더 ecu_id ≠ 자기 ID면 NRC 0x31 거부(메타 commit 전)
    - 순수 결정함수 ota_meta_ecu_id_allowed(SSOT 3곳) — version_allowed와 동일 패턴
    · header_ecu_id==0(미지정) 호환 허용, 헤더 부재(레거시)는 스킵
    - test_anti_rollback 4 신규(거부/허용/미지정/미래ID), 총 10 · 누적 78개 그린
    - 커버리지 라인 91%·분기 79%(strict)
    설계 결정 ADR-009: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
2026-06-05 docs: 한계·잔여위험 통합 레지스터 신설(SRS §19.1) — 후속 트리거·근거 명시
    흩어져 있던 후속 항목을 한 표로 색인(ISO/SAE 21434 잔여위험 수용·ASPICE SWE.6):
    보안 6(replay·hardware_id·잠금NV·seed·anti-rollback 기준선·ECU-id 앱레벨 → ATECC608A 입고)
    + 제어 1(직진 안정화 → 엔코더·IMU 입고). 각 행에 현재완화·트리거·근거ADR 명시.
    - FR-CAN-011: hardware_id 후속 이연 표기
    - §19(9): 직진 이슈 근본원인 규명(엔코더·IMU 부재→개루프, 폐루프 제어로 해소)
    - README: 레지스터 포인터 추가 / SRS 2.10→2.11, SDD 참조 동기화
2026-06-05 docs: 보안 공격 테스트 ID 충돌 해소(TC-SEC→TC-ATK) + 10종→구현분 calibration
    - SRS TC-SEC-001~010 → TC-ATK-001~010 개명 (SR-ATK와 1:1, TEST_SPEC의 TC-SEC 실행스펙과 네임스페이스 분리)
    - §21.2·MS-004 '공격 10종 통과/PASS' → '구현분 통과'로 calibrate (replay·campaign 미구현은 §19.1 후속과 정합)
    - SRS 2.11→2.12 + 개정이력, SDD 참조 v2.12 동기화
2026-06-05 docs: 테스트 결과서 TR-001 신규 — 단위 78/78·on-target 4/4 PASS
    - 실행 결과 기반 TR-001(ASPICE SWE.6): 단위 78/78(커버리지 91%/79%) + HIL 4/4 PASS, 로그 인용
    - 보안 공격 시나리오 커버리지 ✅3·🔶4·⬜3, 미실행·이연은 §19.1 연결(과대 PASS 없음)
    - README/PORTFOLIO 표준산출물에 TR 추가 + 문서목록 링크
2026-06-05 fix: Jenkinsfile 첫 릴리스 deploy-all — 직전 태그 없으면 두 ECU 배포
    기존: 첫 태그는 직전 태그가 없어 비교 기준선이 HEAD~1로 좁아짐 → 태그 커밋이 문서만
    바꾸면 DRIVE/SENSOR_CHANGED=false → Approve/Deploy 스테이지가 스킵돼 승인 게이트가 안 뜸.
    수정: IS_RELEASE인데 직전 태그가 없으면(firstRelease) 두 ECU를 deploy-all로 처리.
    증분 릴리스(직전 태그 존재)의 변경ECU만 배포하는 기존 동작은 유지.
2026-06-05 build: project.yml ceedling 1.0 호환 — :gcov :compile를 plain list로
    Pi Jenkins의 ceedling 1.0.1은 :flags :gcov :compile에서 :*: 매처-해시를 금지(plain list만 허용,
    매처는 :test 컨텍스트 전용). plain list로 변경 — Mac ceedling 0.31에서도 gcov:all 78개 PASS·커버리지 정상 확인(양쪽 호환).
2026-06-05 fix: Jenkinsfile cppcheck 오탐 차단 — 정보성 메시지 suppress
    Pi의 신규 cppcheck가 toomanyconfigs·normalCheckLevelMaxBranches(information severity, 실결함 아님)에도
    --error-exitcode=1로 exit 1 → Static Analysis 실패. 두 정보성 ID를 suppress(Drive·Sensor 양쪽).
2026-06-05 build: CI용 Debug 빌드설정 커밋 — Slot A makefile(Drive·Sensor)
    ci/build.sh가 DriveECU/Debug·SensorECU/Debug의 makefile로 Slot A(및 Sensor B)를 빌드하는데
    Debug/가 gitignore라 Jenkins 클린 체크아웃엔 없어 Build&Sign 실패. SlotB와 동일하게 빌드설정만
    추적(makefile·objects.list·objects.mk·sources.mk·subdir.mk ×3, 아티팩트 제외). 소스경로는 상대,
    링커 절대경로·-fcyclomatic-complexity는 build.sh가 빌드 시 patch/제거.
2026-06-06 docs: 실보드 검증 명칭 HIL→SIT 표준화 — ADR-010 신규
    HIL은 plant를 실시간 시뮬레이터로 대체하는 기법이나, 본 벤치는
    ECU·CAN·모터·센서·Pi가 전부 실물 → 정의상 HIL 아님. ASPICE SWE.5
    정식 용어인 시스템 통합 테스트(SIT)로 개명.
    - HIL-001 → SIT-001(파일 rename), HIL-TC-NN → SIT-TC-NN
    - 본문 HIL → on-target/SIT (README·SDD·TR·SRS·diagram·ADR-002/007/009·ISS-CAN-005)
    - SIT-001 제목·디스클레이머 재작성 — "왜 HIL 아닌 SIT인지" 표준 근거로
    - ADR-010 신규 — 결정·검토옵션·코드식별자 보류 사유 기록, ADR 카운트 ×9→×10
    - 코드 식별자(hil_runner.py·HIL_SELFT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
2026-06-06 fix: OTA endless-data 누적상한·완료검증 구현(FR-CAN-012/013) + 공격 시나리오 검증 보강
    코드 리뷰(공격 시나리오 커버리지 점검)에서 FR-CAN-012/013(Must)이 문서엔
    "구현"이나 코드 미반영이던 갭 발견(ISS-SEC-001). 작은 image_size 선언 후
    TransferData를 계속 보내면 선언 크기를 넘겨 인접 flash까지 기록되는
    endless-data(SR-ATK-007)가 실제로 가능했음.
    수정(두 ECU uds.c):
    - 0x36 TransferData: 누적 > image_size면 NRC 0x31 + 세션 종료 (FR-CAN-012)
    - 0x37 RequestTransferExit: 누적 != image_size면 NRC 0x24 (FR-CAN-013)
    - 단위 2종 추가 → ceedling test:all 80/80 PASS, 두 ECU arm-none-eabi 클린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
    [forge_image.py, test_uds_state.c, uds.c]
2026-06-06 test: on-target 하네스 보강 — SIT-TC-05~08 자동/반자동화 + FR-CAN-019 과대표기 정정
    hil_runner 하나로 8종 시나리오를 돌릴 수 있게 함(01~04에 이어 05~08 추가):
    - ota_client.py --declared-size N : endless-data 공격(작은 size 선언+초과 전송)
    - hil_runner tc05(endless-data)/tc06(변조)/tc07(미서명) 자동, tc08(CAN flood) 반자동
    - forge_image 연동(tc06/07), ota_push extra 인자, selftest 신규 패턴 2종(ALL PASS)
    - 판정: UART NRC SID=0x36 code=0x31 / [BL] ECDSA FAILED / 이전 CONFIRMED 유지
    발견·정정(문서-코드 갭 2호): FR-CAN-019 S3 세션 타임아웃(Must)이 문서엔
    "구현"이나 uds.c에 미반영 → TR-001 §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
    [hil_runner.py, ota_client.py]
2026-06-06 fix(can): Bus-Off 자동복구(ABOM) 활성화 — 양 ECU CAN1
    on-target 테스트 중 발견(ISS-CAN-006): AutoBusOff=DISABLE이라 한 노드가
    Bus-Off에 빠지면 영구히 묶임. hil_runner가 st-flash로 한 ECU만 halt/reset하면
    파트너가 ACK를 못 받아 Bus-Off → 자동복구 없이 CAN 정지(둘 다 수동 리셋해야 회복).
    - 양 ECU main.c: hcan1.Init.AutoBusOff = DISABLE → ENABLE
    - .ioc 동기화(CAN1.ABOM=ENABLE + IPParameters) → CubeMX 재생성 보존
    - 양 ECU arm-none-eabi 클린 컴파일
    - 근거: ISO 11898-1 bus-off 자동복구, AUTOSAR CanSM. 실차 ECU 필수 동작
    - ISS-CAN-006(8D) 신규 — ESR=0xFFFE0047 디코드·RCA·시정
    [main.c]
2026-06-06 tools: flash.sh — 단일 보드 USB(ST-Link) 플래시 헬퍼 (OTA 불필요)
    서명 앱(슬롯A v2) + CONFIRMED 메타를 ST-Link로 굽는다. hil_runner의
    setup_bench에서 "보드별 플래시"만 추출 — 보안 부트로더 게이트를 통과하는
    정석 경로(서명+메타)라 CubeIDE 단독 Run(미서명→ECDSA FAIL)을 대체한다.
    - 사용: tools/flash.sh <drive|sensor> <st-link-serial> [--build] [--bl]
    - --build: build_fixtures.sh로 재빌드+재서명(ABOM 등 새 소스 반영)
    - --bl: 부트로더도 플래시(평소 불변이라 생략)
    - 메타 a-size=서명이미지 크기 자동 계산, 주소는 setup_bench와 동일
    - SIT-001 §2에 플래시 단계 안내 추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
2026-06-06 fix(flash.sh): ST-Link "0 KiB flash" 글리치 대응 — 쓰기 중 halt 유지 + 재시도
    Drive 보드에서 3번째 st-flash(메타 B 0x0800C000)가 매번 "0 KiB flash /
    Unknown memory region"으로 실패 → flash.sh 중단 → 메타 B가 옛 high-seq
    사본으로 남아 부트로더가 옛 슬롯(B v3)을 부팅하던 문제.
    원인: 쓰기마다 --reset로 보드를 실행시켜 도는 앱이 다음 SWD 연결을 방해.
    - 쓰기 사이 --reset 제거(halt 유지), 마지막에만 reset
    - st-flash 1회 재시도 래퍼 sf() 추가
    - 플래시 주소는 불변(메타 0x08008000/0x0800C000은 헤더와 무관한 고정 섹터)
2026-06-06 docs(troubleshooting): on-target 테스트 중 발견한 이슈 3건 8D 정리
    - ISS-HW-001: ST-Link "0 KiB flash" 글리치 — 연속 쓰기 중 reset이 SWD 간섭
    → 메타 사본 한쪽만 써져 옛 high-seq 메타로 오부팅(slot B v3). flash.sh 수정으로 해결.
    - ISS-SEC-002: SecurityAccess NRC 0x35 — Pi 구버전 ota_client로 key 유도식 불일치.
    칩 PSK read + HMAC 자가계산으로 Pi/ECU 중 어느 쪽이 틀린지 판별. git pull로 해결.
    - ISS-OTA-006: OTA TransferData 중 "No Flow Control"(RX FIFO 오버런, 고부하) — 진행 중.
    ISS-OTA-004가 deferred한 robustness 항목. 완화=cf-delay↑, 근본수정 후속.
    - 트러블슈팅 8D 카운트 ×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
2026-06-06 docs(ISS-OTA-006): cf-delay 0.02 완화 검증 — 139/139 전송 + TC-01 PASS
    on-target 재현(2026-06-07): --cf-delay 0.02로 대용량 OTA 전량 전송 완료,
    SIT-TC-01 anti-rollback PASS. 기본값(0.005)은 여전히 랜덤 실패라 완화이며
    근본수정(블록 printf 축소·FIFO0 즉시 드레인)은 후속으로 유지.
2026-06-06 fix(hil_runner): forge_inject ST-Link 글리치 대응 — TC-03 메타 주입 실패 해결
    TC-03 fail-closed가 FAIL이던 건 기능 결함이 아니라 ISS-HW-001 재발:
    forge_inject의 메타 B(0x0800C000) --reset write가 "0 KiB flash" 글리치로
    실패 → 옛 high-seq 메타가 선택돼 size0 위조 미적용 → fail-closed 미발현.
    - forge_inject: 두 사본 쓰기 사이 --reset 제거(halt 유지), reset은 호출부
    - stflash(): "0 KiB flash" 글리치 시 1회 재시도 (setup_bench 포함 전 경로 robust화)
    - selftest ALL PASS, ISS-HW-001 2차 발현 기록
    [hil_runner.py]
2026-06-06 docs(TR-001): SIT-TC-01~04 on-target 재검증 4/4 PASS (2026-06-07)
    ABOM(ISS-CAN-006)·endless-data(FR-CAN-012/013) 펌웨어 변경 후 원래 4종
    on-target 재통과 — 회귀 없음. §4에 재검증 라인, §9 changelog v1.3 추가.
    재검증 중 발견·해결: ISS-HW-001·ISS-SEC-002·ISS-OTA-006(완화).
2026-06-07 docs: SIT-001 RUNBOOK 신규 — on-target 공격 시나리오 TC 실행 절차서
    사전준비(빌드·플래시·Pi 동기화·fixtures scp)부터 TC-01~08 Mac/Pi 명령,
    복구, 트러블슈팅 빠른참조, fixtures 정체까지 순서대로 정리. SIT-001·README에서 링크.
2026-06-07 fix(hil_runner): TC-08은 v1(옛버전) 푸시 — flood 무관하게 v2 귀결로 판정 견고화
    기존 v3_B(유효 상위)는 flood가 약해 완주하면 v3 설치→"version v2 OK" 미발생→
    헷갈리는 FAIL. v1_B로 바꾸면 (깨지면 미커밋→v2)·(완주해도 anti-rollback→v2)
    어느 쪽이든 known-good v2로 귀결 → no-brick 판정 명확. RUNBOOK도 동기화.
    [hil_runner.py]
2026-06-07 docs: 공격 시나리오 SIT-TC-05~08 on-target 4종 PASS — 커버리지 ✅7·🔶1·⬜2
    endless-data(05)·변조(06)·미서명(07)·CAN flood no-brick(08) 실보드 통과(2026-06-07).
    - TR-001 §5: 001·002·007·008 → ✅(on-target), 요약 ✅7·🔶1·⬜2
    - TR-001 §4: 공격 시나리오 결과표 추가, on-target 8/8(기본4+공격4)
    - TR-001 §7: 실행 완료분(TC-ATK-008·SIT-TC-05~08) 이연에서 제거 / changelog v1.4
    - README: On-target 8/8 헤드라인 + TC-05~08 행 추가
    잔여: replay(005)·campaign(010) = HW/Uptane 로드맵, S3(FR-CAN-019) 미구현 별도
2026-06-07 feat(uds): S3 세션 타임아웃 구현(FR-CAN-019/NFR-REL-003/FR-BL-012) + 추적성 정정
    추적성 분석에서 나온 유일한 기능 결함(S3 미구현) 수정 + 문서 정합:
    S3 구현(양 ECU uds.c):
    - uds_process()에 비-Default 세션 5000ms 무요청 → 세션 abort→Default 복귀.
    CAN 중단/멈춘 OTA 자동 회복(TC-08). DriveECU는 g_ota_active=0 병행.
    - 단위 2종 추가(test_s3_timeout_aborts_session·no_abort_within_timeout) → 82/82.
    - 잠금 테스트는 S3(5s)<lockout(10s) 상호작용 반영해 세션 재진입으로 수정.
    - 양 ECU arm-none-eabi 클린 컴파일.
    문서 정합:
    - SRS: FR-CAN-019 "구현됨" 주석, FR-CAN-014(0x31 미구현→부팅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
    [test_uds_state.c, uds.c]
2026-06-07 docs(SRS): Manifest divergence 정합 — 서명 헤더 대체 명문화
    별도 Manifest(SR-MF) 대신 임베디드 ECDSA 서명 헤더(ADR-007)로 대체된 실제 구현을
    요구사항에 반영:
    - §8.1에 설계결정 note + SR-MF-001~008 필드별 충족(002·003 헤더, 005 ECDSA 흡수,
    006 이미지 서명)/이연(007 campaign·008 freshness=Uptane-lite) 매핑
    - §8.2(Manifest Hash/Sig=이미지 ECDSA), FR-GW-002/003(Manifest 미파싱),
    FR-CICD-006(Manifest 미생성), FR-BL-006(hash=ECDSA 내포),
    FR-AB-008(헤더 4필드 subset), SR-UP-002/004/005 구현현황 주석
    - 개정이력 v2.13
    Uptane: ECU 자체검증(SR-UP-004) 핵심 원칙은 헤더로 충족, 상위 메타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
2026-06-07 docs: SDD 세션 변경 반영 + SRS/SDD/TR 버전 정합(완결성 1·2)
    완결성 검토 후속 — SDD 최신화 + 버전 드리프트 해소:
    - SDD §8 추적행 추가: FR-CAN-012/013(endless-data)·FR-CAN-019/NFR-REL-003(S3)·
    TC-ATK-001/002(변조·미서명)·ABOM. §2.4 SID표 미구현(0x22/0x31/0x11/0x3E) 표기.
    §9 on-target 4종→8종, 단위 82(test_uds_state 25→29). 개정이력 v1.2.
    - SRS 헤더 버전 2.12→2.13(changelog와 일치), SDD/TR 참조 SRS v2.13·ADR-002~010 동기화.
2026-06-07 docs: RTM-001 신규 — 통합 요구사항 추적성 매트릭스(완결성 3)
    분산돼 있던 추적(SDD §8 핵심 8개·TR §6·SRS 인라인)을 단일 RTM으로 통합:
    - SRS-001(v2.13) 전체 113개 요구(FR/SR/NFR)를 요구↔설계(SDD§/ADR)↔코드(파일)↔
    테스트(단위/SIT-TC)↔상태(✅/🔶/⬜/🔁)로 1표화. 카테고리별 10개 절 + 요약.
    - 미구현·대체설계 정직 표기: FR-CAN-014(0x31)/015(0x11)/017/018, SR-MF-007/008(헤더 대체),
    SR-ATK-005(replay)/010(campaign), FR-GW-008 등 — 사유(Should/HW/Uptane-lite) 명시.
    - README 표준산출물·doc목록, SDD §8에서 RTM 링크.
2026-06-07 docs(TARA): v0.1→1.0 보강 — T-1~T-10 완성 + SR-ATK·SIT-TC 검증 연결
    골격(척도·자산·T-1 예시)만 있던 TARA를 분석 완료 상태로:
    - T-2~T-5 _TODO_ 등급 채움 + T-6~T-10 신규 → SR-ATK-001~010 전수 대응
    - 각 위협 Impact×Feas→Risk 산정, 처리(Reduce/Retain) + on-target SIT-TC 검증 연결
    (8/10 ✅, CG-2 PSK·CG-9 fake-complete 🔶, CG-4 replay·CG-10 campaign ⬜ 잔여수용→§19.1)
    - §4.1 CG 요약표(목표→요구→검증→상태) 신설
    - 구 TC-SEC→SIT-TC 참조 정정, CSR-1.4 Manifest hash→ECDSA 흡수(§8.1) 반영
    - 관련산출물에 SIT-001/TR-001/RTM-001 링크, 개정이력 v1.0
2026-06-07 docs: HARA-001 v0.1→v1.0 — H-2~4 ASIL 확정·Safety Goal 종합
    - H-2/H-3/H-4 S·E·C·ASIL 확정(모두 A) + 등급 근거(ISO 26262-3 Table 4)
    - §4.1 Safety Goal 종합표 신설 — SG-1~4·TSR-1.2를 위험→SG→요구→검증→상태로 연결
    - §4 검증 항목 stale 참조 정정(TC-DRV-003→SIT-TC-04)
    - TARA-001/SIT-001/TR-001/RTM-001 연결, 상태 '분석 완료'
2026-06-07 docs: 계획 테스트명세↔실행 결과 매핑 (TR-001 §6.1)
    - TR-001 §6.1 신설 — TS-OTA-001 계획 28종을 단위(Ceedling)/on-target(SIT-TC)
    실행 증거에 매핑(✅16·🔶10·⬜2). ⬜ 2종(TC-DRV-004·TC-CI-004) §7 이연 추가, v1.6
    - TS-OTA-001: §13 결과 위치를 TR-001 §6.1로 명시, 집계표 동일 범례로 갱신,
    상태 Draft→계획 확정, v1.1 (계획서/결과서 분리 = ASPICE SWE.6)
2026-06-07 docs: CI/CD E2E 배포(Jenkins #85·#86) 결과 반영 — TR-001 §1·§4.1·§6.1, TS-OTA-001 §13.1, RTM FR-CICD-001/002/010 ✅, ISS-OTA-007 신설
2026-06-07 ci: E2E 검증용 태그·diff 게이트 임시 해제 (TEST-ONLY)
    빈 커밋만으로 DriveECU·SensorECU 전체 OTA가 실행되도록
    IS_RELEASE/*_CHANGED를 강제 override. 버전은 BUILD_NUMBER 사용.
    수동 E2E 검증 후 override 블록 삭제하여 원복 예정.
2026-06-07 ci: E2E 검증용 임시 게이트 해제 원복 (TEST-ONLY override 제거)
    #93에서 비-태그 커밋 → 두 ECU 전체 OTA E2E 검증 완료.
    태그(vN)·diff 게이트를 원래대로 복구 — 일반 push는 CI까지만,
    배포는 릴리스 태그 + ECU diff에서만 동작(ADR-008).
2026-06-08 feat(fuzz): 호스트 커버리지 퍼징 도입·문서 재구성·F-002/F-003 수정
    - docs/ 디스시플린 폴더 재구성(requirements·design·safety·security·test·assets·portfolio) + 인덱스(README), 문서간 링크 전수 정정
    - fuzz/: Homebrew libFuzzer+ASAN/UBSAN 하니스 — FH-1(이미지 헤더)·FH-3(UDS 0x36) + build.sh
    - FT-001 퍼즈 테스트 계획·결과(ASPICE-CS SEC.3 / ISO/SAE 21434 §10.4 / ISO 29119-3)
    - F-002: sha256 부호 있는 좌측 시프트 UB → (WORD) 캐스트(Sensor·Bootloader·Drive) — ISS-SEC-003
    - F-003: UDS TransferData per-block 스택 오버플로(CWE-787) → chunk_len>256 NRC 0x31 가드(양 ECU) — ISS-SEC-004
    - 회귀: test_uds_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
    [부품구매목록.xlsx]
2026-06-08 docs: 퍼징 채널 반영 KPI 동기화 (단위 82→83·트러블슈팅·FT-001)
    - README: 단위 83개, 트러블슈팅(8D)×17, 퍼징 KPI 행 + 표준산출물 FT·SEC.3
    - TR-001: §1 캠페인 ④(호스트 퍼징) 추가, §3 합계 83·test_uds_state 30, §8 결론·재현, 개정 1.8
2026-06-08 test(fuzz): FH-3 v2 다중블록 endless-data 퍼징 + SC3 플래시모델 입증
    - harness_uds.c: 단일블록 → 다중블록 주입(길이바이트 증폭), 슬롯 16KB 축소 모델
    - v2a: 누적 경로 1.23M회 무크래시(누적·per-block 가드로 슬롯 내 유지) → 방어 성립
    - SC3: 누적가드 일시 제거 시 플래시모델이 OOB 검출(16384B 경계) → 복원 후 무크래시 → 리그·FR-CAN-012 유효 입증
    - FT-001 §3/6/8/9 반영
2026-06-08 docs: README 간결화 — ADR 나열 제거·레퍼런스 접이식·단위 82→83 정정
2026-06-09 docs: CWE-787→121 통일
    - CWE-787 → CWE-121(스택 기반 버퍼 오버플로, 더 구체적 분류) 통일 — README·양 ECU uds.c 주석·test_uds_state·TR-001·FT-001·ISS-SEC-004 (14곳). CWE-636(fail-open 설계 라벨)은 유지
    - 개인 제출용 문서는 .gitignore로 추적 제외(로컬 보관)
    [test_uds_state.c, uds.c]
2026-06-09 chore: docs/portfolio/*.pptx git 추적 제외 (.gitignore)
    - 포트폴리오 pptx를 추적 제거(로컬 보관) + docs/portfolio/*.pptx ignore
    - 개인 포트폴리오 산출물은 저장소에 포함하지 않음
2026-06-10 test(fuzz): AFL++ 교차검증 추가 — 엔진 이식성 실증·F-003(CWE-121) 독립 재발견
    - harness_uds_block.c: FH-3 단일블록 하니스(padded 경로 직접 자극)
    - fuzz/afl/run_afl.sh: Docker(AFL++)로 빌드·실행 재현 러너
    - fuzz/README.md: libFuzzer·AFL++ 사용법
    - FT-001 §2·6·7·8·9: AFL++ 캠페인(수정본 무크래시 / 가드해제본 CWE-121 재발견) 반영
    - FT-001_AFL_walkthrough.md: 셋업·실행 절차·근거 작업기록
    동일 하니스(LLVMFuzzerTestOneInput)를 afl-clang-fast로 재컴파일. 수정본은
    양 엔진 무크래시, 가드 임시해제 시 AFL++ havoc가 2초 내 >260B 입력으로
    padded[260] stack-buffer-overflow를 재발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
    [harness_uds_block.c]
2026-06-11 chore: SIT-TC-08 CAN flood 측정 기록 git 추적 제외 (.gitignore)
    docs/test/SIT-TC-08_CAN_flood_measurement.md 및 동반 캡처
    (SIT-TC-08_CAN_flood_*.png)를 로컬 보관·저장소 제외.
2026-06-12 feat(sec): SecurityAccess seed freshness — 영속 epoch로 reboot-replay 차단 (SR-ATK-005)
    기존 seed=SHA-256(UID‖SysTick‖RAM ctr)는 재부팅 시 입력이 모두 리셋돼
    같은 seed가 재생성 → 캡처한 Key로 PSK 없이 unlock 가능(reboot-replay, TARA T-4).
    - sec_derive_seed() 순수 함수 추출 — 호스트 단위테스트 가능
    - ota_meta_bump_seq(): 영속 seq_counter를 부팅당 1회 +1, ping-pong 원자커밋
    - sec_make_seed: SysTick → 영속 boot_epoch + per-session ctr (재부팅 비반복)
    - 첫 RequestSeed에 lazy bump(메인루프=flash 안전), NV 불가 시 NRC 0x22
    - test_sec_freshness: 취약 재현 + 수정 닫힘 실증 5종
    - test_ota_meta: bum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
    [ota_flash.c, ota_flash.h, seed_probe.py, test_ota_meta.c, test_sec_freshness.c, uds.c, uds.h]
2026-06-12 docs(sec): replay 수정 반영 — ADR-004 §6·SIT-TC-09·seed_probe (SR-ATK-005)
    - ADR-004 §6: 영속 boot-epoch로 reboot-replay 해소, on-target TC-ATK-005 PASS
    기록. §5 한계 #1·#3 종결(물리 변조·엔트로피는 잔여). 개정 1.1.
    - SIT-001: SIT-TC-09(replay) 케이스 + 실행기록 PASS(2026-06-13, 양 ECU) + 추적.
    - seed_probe.py: bus.shutdown() finally 정리(SocketcanBus 경고 제거).
    TARA-001 T-4/CG-4 갱신은 기존 WRP WIP와 한 파일에 섞여 별도 처리.
    [seed_probe.py]
2026-06-13 docs: OTA 활성화 설계 정합화 — g_fw_pending(옵션 B) 제거, 옵션 C 반영
    ADR-001(옵션 C) 정본 기준으로 SRS·TEST_SPEC·RTM·diagram의
    옛 g_fw_pending(지연 활성화) 서술을 실제 구현으로 정합화:
    IDLE 확인은 Gateway wait_for_idle, 활성화는 TransferExit 즉시 재부팅.
    RTM FR-DRV-008 코드 추적을 존재하지 않던 main.c→uds.c(0x37)로 정정.
2026-06-13 docs(ts): VTOR·PRIMASK 근본원인 정정 — 경로별 단일 원인 규명
    - ISS-BL-001 원인1: SystemInit VTOR설정 메커니즘은 사실무근(USER_VECT_TAB_ADDRESS 주석),
    실제는 디버거 부트로더 우회로 VTOR 미설정. VTOR룩업+0번지 alias 메커니즘 추가
    - ISS-BL-001 재분석(2026-06-13): 디버거=VTOR, 실제부팅=PRIMASK 단일원인 / git근거
    - EXP-001: T4 동시공존 해석 철회, 실험B VTOR=0 관측 코드 모순 명시
2026-06-19 docs: 단위 테스트 수 91 정합 및 ECDSA 라이브러리 출처 정직화
    - 단위 테스트 83/82→91 정합(TR-001 per-suite 표·SDD-001·SIT-001·README·docs/README): test_sec_freshness 5종 누락 + test_ota_meta 10→13 반영
    - ECDSA-P256를 '오픈소스 uECC(P-256) 통합'으로 정정(README·ONEPAGER) — '직접 포팅' 과장 제거
    - 커버리지(라인 ~91%/분기 ~79%)는 유지
2026-06-19 docs(sec): 잔여위험·위협분석 갱신 — L-8(HW RoT 앵커)·T-4 replay 차단
    - SRS §19.1 L-8 신설: Secure Boot 신뢰점이 SW WRP 앵커(HW RoT 부재) 잔여위험 → HSM MCU 플랫폼 교체로 해소(ADR-006 옵션 C)
    - TARA T-2/T-4 갱신: PSK WRP 격리(WRP-PROV-001)·reboot-replay 영속 boot-epoch 차단(on-target TC-ATK-005 PASS)
    - WRP-PROV-001 신규: 부트로더 WRP 프로비저닝·검증 절차
2026-06-19 docs: 2차 확장 착수 — 구동 제어 요구(SRS-002)·AURIX 포팅(ADR-011)·제어 HARA
    - SRS-002 신규: 폐루프 구동 제어 요구(FR-CTL/FR-FUS/NFR-CTL/FSR-CTL), SRS-001 L-7 해소
    - ADR-011 신규(proposed): AURIX TC375 포팅·온칩 HSM RoT(ADR-006 옵션 C)
    - HARA-001 v1.1: 구동 제어 위험 H-5~H-8 + SG-5~8 → SRS-002 FSR-CTL 연결
2026-06-19 chore: 부품목록 갱신 + 산출물·로컬문서 git 제외
    - 부품목록: 7차(Phase2 부품)·8차(AURIX TC375·USB 케이블) 반영, 9컬럼 서식 정합
    - .gitignore: 포트폴리오 best/·archive/·PHASE2_ROADMAP, 분석 캐시(*.ctu-info·*.gcov) 제외
    [부품구매목록.xlsx]
2026-06-21 docs: 핵심 KPI 정합 — on-target 9/9·보안 7종·ADR 11(채택10·제안1)
    README·docs/README·PORTFOLIO·TR-001의 핵심 성과 지표를 일괄 정합.
    - on-target 8/8→9/9 (SIT-TC-09 SecurityAccess reboot-replay), 공격 4→5종
    - 보안 6→7종 (ECU 식별 강제 FR-CAN-011/ADR-009 포함)
    - ADR 10→11건(채택 10·제안 1 — ADR-011 proposed), 8D ISS 14→17건
    - commits 130+→170+, on-target 라벨 "정상 4"→"기본 4" 용어 통일
    - TR-001 §8 보안 6→7종 정정 + 개정 이력 1.11
2026-06-24 docs: Uptane 과대표현 정정·on-target replay 9/9 정합
    - SRS §9 'Uptane-lite 참고'→'업데이트 오케스트레이션(SR-UP)+참고 아키텍처' 재작성: 강제 개념매핑표 제거→채택/제외 결정표, 디바이스단=MCUboot 명시, Uptane은 2-repo/TUF 미채택·full-verification 원칙만 차용 (v2.15)
    - SIT-TC-09(SecurityAccess reboot-replay) on-target PASS 반영: SR-ATK-005 ⬜→🔶, §19.1 L-1 부분구현 갱신, on-target 8/8→9/9 (v2.16)
    - ADR-007·sign_firmware.py: 'MCUboot 정석'→'MCUboot에서 착안'(TLV·security counter 미채택, 자체 단순화 명시)
    - RTM-001: SR-ATK-005·FR-CAN-017 boot-epoch 대체설계로 정합
    [sign_firmware.py]
2026-06-24 chore: IDE 빌드 산출물 추적 해제·개인 파일 gitignore
    - Debug/·.settings/·SlotB/ 추적 해제(git rm --cached) — IDE 자동생성 산출물 churn 및 makefile 절대 로컬 경로 노출 차단(.gitignore 제외 의도 정합)
    - .gitignore: SlotB/ 추가, 개인 면접자료(*면접*)·원본백업(*원본백업*) 패턴 제외
