JaehyeongIm/automotive-secure-ota-ecu/docs/assets/photos/정면사진.JPG

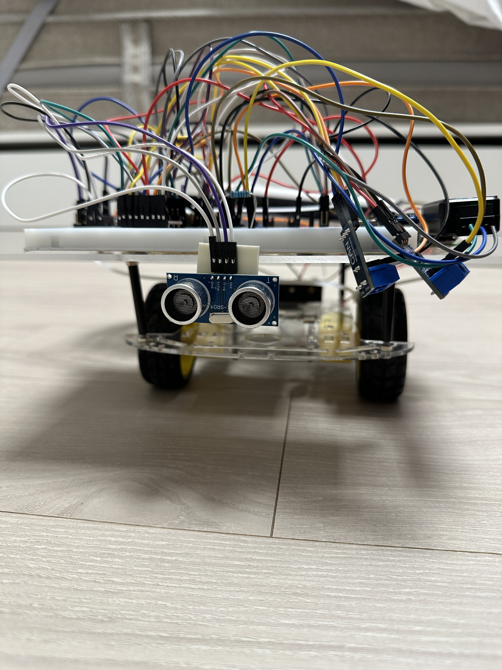
docs/assets/photos/정면사진.JPG
