JaehyeongIm/automotive-secure-ota-ecu/docs/assets/photos/천장사진2.JPG

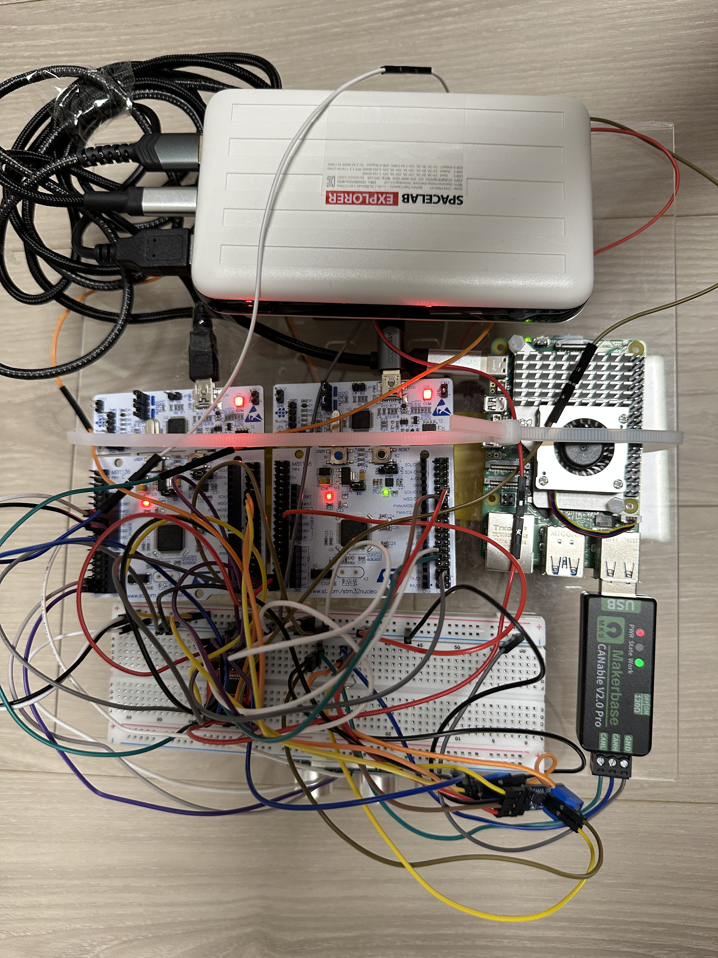
docs/assets/photos/천장사진2.JPG
